Kathrynlls/Hydroponics-Monitoring-System-using-Atmega328p/README.md

# Hydroponics-Monitoring-System-using-Atmega328p
Hydroponics Monitoring System for Bok Choy, Lettuce, and Kale. This repository features a custom ATmega328P implementation, including complete schematics and source code for automated plant health tracking.
