Kathrynlls/Hydroponics-Monitoring-System-using-Atmega328p/Hydroponics-Monitoring-System-of-Lettuce-Kale-and-Bok-Choy-using-Atmega328p-microcontroller-1.pdf

## Hydroponics Monitoring System of Lettuce, Kale, and Bok Choy using Atmega328p microcontroller

by

## Kathryna T. Lelis Angelica Anne D. Santos Jhanna D. Vicente

### Bachelor of Science in Computer Engineering Mapúa University, 2025

A Design Proposal Submitted to the School of Electrical, Electronics, and Computer Engineering in Partial Fulfillment of the Requirements for the Degree

### Bachelor of Science in Computer Engineering

### Mapúa University October 2025

ACKNOWLEDGEMENT

The researchers would like to express their heartfelt gratitude to the panelists, Engr. Carlos C. Hortinela IV, Engr. Rosemarie V. Pellegrino, and Engr. Noel

### B. Linsangan, for their time, patience, and thoughtful suggestions which helped the researchers see the project from a deeper technical perspective and greatly improved

the overall quality of the work.

The researchers are sincerely thankful to their research instructor and adviser,

### Dr. Jocelyn F. Villaverde, for her constant guidance, encouragement, and understanding throughout the entire research process. Her dedication, valuable insights, and continuous support played a significant role in shaping both the

direction and completion of this study.

### The researchers also wish to thank the faculty members of the Computer

Engineering Department, along with their classmates and friends, for their support, assistance, and motivation during the development and testing of the system. Lastly, the researchers are deeply grateful to their families for their patience, encouragement, and unwavering support, which made the completion of this research possible.

Table of Contents

Functionality Constraints Overview of Alternative Solutions.......Error! Bookmark not defined.

Safety Constraints Overview of Alternative Solutions | Error! Bookmark not defined.

Constructability Constraints Overview of Alternative Solutions..Error! Bookmark not defined.

LIST OF FIGURES

FIGURE 3.34 ALTERNATIVE SOLUTION USING INDUSTRIAL GRADE SENSORS .........63

FIGURE 3.46 PROTOTYPE LAYOUT | 81
FIGURE 3.47 PROTOTYPE DISPLAY INSTANCE | 82
FIGURE 3.48 CODE SNIPPET | 82

LIST OF TABLES

TABLE 3.5 OLED DISPLAY AND 20X4 LCD DISPLAY COMPARISON TABLE | 49
TABLE 3.6 BATTERY POWER AND WALL PLUG POWER COMPARISON TABLE | 51

TABLE 3.7 INDUSTRIAL-GRADE SENSORS AND HOBBY-GRADE SENSORS COMPARISON -TABLE 53

TABLE 3.8 DESIGN ALTERNATIVES: FUNCTIONALITY OVERVIEW | 64
TABLE 3.9 DESIGN ALTERNATIVES: SAFETY OVERVIEW | 65
TABLE 3.10 DESIGN ALTERNATIVES: CONSTRUCTABILITY OVERVIEW | 65
TABLE 3.11 SELECTION OF ALTERNATIVE SOLUTIONS: MONITOR DISPLAY | 66
TABLE 3.12 SELECTION OF ALTERNATIVE SOLUTIONS: POWER SUPPLY | 67
TABLE 3.13 SELECTION OF ALTERNATIVE SOLUTIONS: SENSORS | 68
TABLE 3.14 COMPONENTS OF HYDROPONICS PCB | 77
TABLE 3.15 BILL OF MATERIALS | 80

ABSTRACT
Maintaining optimal growing conditions in hydroponic systems requires continuous monitoring of critical water parameters, yet commercial monitoring solutions remain prohibitively expensive for small-scale growers. This paper presents a low-cost, automated hydroponics monitoring system based on the ATmega328p microcontroller that tracks temperature, pH, and total dissolved solids (TDS) for three leafy vegetables: lettuce, kale, and bok choy. The system employs a DS18B20 temperature sensor, DFRobot Gravity analog pH sensor, and TDS sensor to provide real-time measurements displayed on a 20×4 LCD screen. Users select their target crop via push-button interface, automatically loading plant-specific threshold values for optimal growth conditions. A multi-level alert system using color-coded LEDs and an audible buzzer notifies users when parameters deviate from acceptable ranges, while the LCD provides actionable recommendations for corrective measures. Additionally, a programmable timer alerts users every 604,800 seconds (one week) for nutrient solution replenishment. Comprehensive functionality testing validated accurate vegetable selection, precise timer operation (±1 second variance), responsive LED indication, clear LCD display output, and reliable buzzer activation. The system demonstrated stable performance under continuous operation while maintaining a total hardware cost affordable, making it accessible to hobbyist farmers and small-scale urban agriculture applications. Compared to commercial alternatives costing $300 or more, this design achieves comparable monitoring capabilities at approximately one-third the cost, effectively lowering barriers to entry for sustainable hydroponic farming.

Keywords: Hydroponics, ATmega328p, pH monitoring, TDS sensor, embedded systems, agricultural automation, modern farming

CHAPTER 1

DESIGN AND BACKGROUND INTRODUCTION

Introduction

Hydroponics systems provide easy soil-free farming using nutrient-rich water solutions

carrying all of the minerals and nutrients directly into plant roots. However, maintaining a constant

nutrient solution under its preferred conditions requires constant monitoring. The Hydroponic

Monitoring System with ATmega328P provides automatic monitoring capabilities with proper

recommendations for temperature, pH, and TDS for water in the hydroponics system with lettuce,

kale, or Bok choy crops. Data is shown on an LCD I2C screen, and there are alerts on LED

indicators and the buzzer when the data deviates. The system further gives recommendations to

the user for maximum growth which is also shown in the LCD I2C screen. Combining monitoring,

recommendations, automated alerts, and a interface for the user, the Hydroponic Monitoring

System has made hydroponic farming a much easier thing for beginners. This approach would

ensure an efficient, productive, and sustainable growth process compared to the risk involved with

human monitoring.

Customer

Our Client, Marvin Baeza, is a passionate individual especially in hydroponic gardening

who enjoys cultivating a variety of plants using soilless methods. However, as a hobbyist, he fails

to achieve consistent optimum conditions needed for excellent plant growth. While he has

experience with certain types of plants such as lettuce, which is a commonly used plant for

hydroponic setup, he struggles to maintain consistent when growing novel types. Nutrient balance,

pH levels, and environmental conditions are always factors that require monitoring, and he finds this rather overwhelming. Despite his dedication to hydroponics, the complexity of maintaining

ideal growing conditions for different plants applicable in hydroponic system sometimes hinders

his ability to achieve the desired results.

Need

The main problem that our client has is to ensure consistency in the hydroponic gardening

system. He finds it complicated to sustain the plant quality most especially when changing different

plant types which would require a different care routine. He must track the nutrient levels, water

quality, and environmental conditions which will be very time-consuming and error-prone if done

manually. To mitigate this issue, he requires a system that will give him the comfort of a reliable

system that could help in the automation of monitoring with feedback, making his plants healthy

effortlessly.

Solution

a. Objectives

This study aims to create a hydroponic farming monitoring system using

ATmega328p microcontroller to track essential farming parameters.

Specifically it aims to: (1) measure and display data on different farming

factors using the integration of multiple sensor modules which are: water

temperature, pH, TDS, (2) develop an interface that allows users to select

from three pre-set plant-specific growing conditions which are: Lettuce,

Kale, Bok Choy, (3) integrate an LCD display for data visualization and an

alert system using visual indicators, , sound notifications to inform users

when any monitored parameter exceeds the optimal range for the selected plant type and a recommendation to set back to optimal conditions and a

recommendation to set back to optimal conditions.

b. Scopes and Delimitations

The paper focuses on Hydroponic Farming Monitoring System as a

smallscale, home-based solution designed to help growers maintain optimal

hydroponic conditions. It uses ATmega328p microcontroller to monitor pH

levels, total dissolved solids (TDS), and water temperature, ensuring proper

nutrient balance and water quality. The system features three pre-set plant

specifications which are Lettuce, Kale, Bok, Choy allowing users to select

the appropriate settings for different crops. Data and recommendation is

displayed on an LCD. However, the system is limited to hydroponic farming,

does not include automated nutrient dosing or water flow control, and

requires manual adjustments and periodic sensor calibration for accuracy.

Despite these limitations, the system enhances efficiency by reducing

manual monitoring efforts and improving plant health through continuous

parameter tracking.

Differentiation

Hydroponics farming has existed for centuries, but its popularity and the number of people

practicing it have only grown recently. This means that this is a starting and growing industry. The

monitoring systems available and currently in the market are pH meter TDS meter, EC meter,

temperature checker, and salinity checker. Some of these meters are sold separately in the market.

The closest product in the market to a Hydroponics Monitoring System is the 5in1 Portable

Hydroponics Meter. However, this product does not track nor monitor Hydroponics setups in

realtime and it also does not give alerts to the client, unlike the Hydroponics Monitoring System.

The Hydroponics Monitoring System was improved by being able to monitor the current

condition of the Hydroponics setup that the client has. This design is further enhanced by providing

clients with alerts from the LEDs, buzzer, and LCD attached to the system. The system can also

provide the appropriate recommendation which will be displayed in the LCD. Lastly, the client can

choose from three plants: Lettuce, Kale, and Bok Choy that they can plant in their hydroponics and

the Hydroponics Monitoring System would instantly change the parameters of the temperature,

pH, and TDS level based on the needs of each specific plant.

| Hydroponics Monitoring System | 5in1 Portable Hydroponics Meter
Specifications | • Run By ATmega328 microcontroller • Has built-in LCD, LEDs, and buzzer • Sensors: Temperature, pH, TDS • Battery: 5V | • Size: 183*37*37mm • pH meter, TDS meter, EC meter, temperature meter, salinity meter • Battery: 3*1.5V LR44

Functionality/

Features

•

•

•

•

•

•

Monitor system

Gives LED alerts when certain

parameters aren’t met Displays

data in LCD

Can monitor temperature, pH, and

TDS levels

Provides recommendations

Client can choose among 3

plants: Lettuce, Kale, and Bok

Choy and the system will

automatically change the

parameters based on the needs of each plant

•

•

•

•

•

•

Portable

5in1 meter: pH meter, TDS

meter, | EC | meter,

temperature meter, salinity

meter

Low power consumption

Does not give alerts

Does not give feedback
Does not provide real-time assessments

Table 1.1 Differentiation Table

Benefits

The proposed design for the Hydroponics Monitoring System would provide substantial

benefits to the hydroponics owners such that this design can help the client have an assessment of

the hydroponics setup. By providing alerts and feedback based on the condition of the hydroponics

setup, the hydroponics will have the appropriate and constant care that it needs to grow more

efficiently. This design provide all the necessary areas that are needed to be tracked by the client

in their setup. Lastly, because of the programmed parameters of different plants, the client would only need to choose which plant they will put in their hydroponics and the system will instantly

change the parameters needed based on the plant.

CHAPTER 2

REVIEW OF RELATED LITERATURE

This section of the paper provides a review of relevant literature and studies on hydroponic

monitoring systems. It deals with developments in hydroponic technology, such as automated

monitoring solutions, improving plant growth and maintenance. This discussion involves critical

concepts and available applications of hydroponic monitoring technologies that advance

innovations to enhance plant health. The document therefore looks into critical parameters to

consider for monitoring plants in a hydroponic setup and the effects of monitoring on the overall

quality of plants. It then discusses how microcontrollers, specifically the ATmega328P, can be

employed to implement an effective monitoring system. The present review work is basically a

precursor to the Hydroponic Monitoring System project design and development.

Concepts and Existing Applications of Hydroponics Monitoring Technologies

Hydroponics, a method of growing plants without soil, relies on nutrient-rich water

solutions and various substrates like clay pellets, perlite, or rockwool. The agricultural technique

successfully draws manufacturing interest because it improves water efficiency as well as increases

crop production and prevents soil-disease transmission. The integration of technology now allows

hydroponic systems to utilize advanced monitoring equipment which maintains perfect growing

environments. Moreover, the Internet of Things (IoT) components along with sensors and

automated control systems allow real-time adjustments of essential parameters including nutrient

levels, pH balance and temperature together with humidity in hydroponic systems. According to

Lakshmi, et. al (2020), the implementation of IoT can deliver live data and warning alerts to

farmers who achieve enhanced environmental control capabilities through automated systems without manual labor requirements [1]. In its procedure, the system is able connect with mobile

applications, so farmers obtain remote capabilities to oversee their hydroponic system operations,

according to Sobri, et. al (2022). This type of utilization with regards to hydroponics with

technology creates maximum performance alongside fresh opportunities for both urban farming

and sustainable agricultural methods [2].

This advance type of monitoring technology should be implemented in hydroponics since

they significantly improve both the precision and efficiency of plant cultivation. The combination

of automatic environmental parameter adjustment under these systems enhances plant

development which leads to better crop production and improved harvest results. The ability to

remotely handle hydroponic systems and their monitoring functions reduces workplace expenses

and minimizes errors. The combination of hydroponics technology with IoT monitoring provides

regions that lack arable land and water resources with a sustainable method to overcome their food

production problems [3]. Further supporting the development of urban farms during rising

urbanization because they improve food security and decrease the environmental impact of

conventional agriculture.

Factors to Consider in Monitoring Plants in Hydroponics Setup

Hydroponics is a method of growing plants without soil, relying instead on nutrient-rich

water solutions. The efficiency of a hydroponic system depends on the careful monitoring and

control of various environmental factors. Among these, temperature, pH, and total dissolved solids

(TDS) play crucial roles in plant growth, nutrient absorption, and overall yield.

According to Agbayani and Villaverde (2022), many farmers struggle to maintain a healthy

hydroponic system due to the difficulty of monitoring water quality parameters like temperature in real-time. Optimal temperature for hydroponic plant growth varies depending on the plant

species [4]. According to Thakulla et al. (2021), extreme heat damages the root of lettuce thus the

water temperature must be kept stable at 21.1 °C to produced lettuce with greater growth [5].

Likewise, a study on environmental factors on Kale suggests that the optimal temperature is at 20–

23 °C for better growth [6]. Moreover, according to the ideal temperature range for bok choy in

hydroponics is between 18°C and 20°C. Temperature control mechanisms such as water chillers,

heaters, and insulated reservoirs are commonly used to maintain stability [7].

The pH level of the nutrient solution directly affects nutrient solubility and availability to

plants. The pH level can change above or below the recommended pH level, which causes nutrient

deficiencies in plants. The recommended pH level for pechay is 5.5 to 6.5 [8]. Studies indicate that

a nutrient solution pH of 5-6, resulting in a root zone pH of 6-6.5, optimizes nutrient availability

for leafy greens like lettuce and kale in hydroponic systems. When pH levels fall outside this range,

certain nutrients become less available, leading to deficiencies or toxicities [9].

Total Dissolved Solids (TDS) and Water Quality Total dissolved solids (TDS) represent

the combined content of all inorganic and organic substances dissolved in water. TDS levels in

hydroponic systems typically range between 500 and 2,000 ppm, depending on crop requirements.

Generally, according to IGWorks (2025), the recommended TDS range for lettuce is between 560

and 840 ppm, for bok choy is 1050 to 1400 ppm, and kale is 1120-1750 ppm. High TDS levels can

indicate excessive nutrients or contaminants, requiring dilution or water replacement. Maintaining

appropriate TDS levels ensures optimal nutrient balance and prevents water quality degradation.

Effective hydroponic farming requires precise monitoring of temperature, pH, and TDS to

optimize plant growth and productivity. Existing research underscores the importance of maintaining these parameters within recommended ranges to ensure nutrient availability and

minimize plant stress.

The Impact of Monitoring on Plant Quality in the Hydroponics Setup

Taking care of hydroponics can be a tedious job. This is why multiple inventions have been

intended to monitor a hydroponics setup. Hydroponics requires constant and consistent care in

order for the plants to grow better and more efficiently. In a study done by Blancaflor et. al., 2022,

the researchers have utilized Internet of Things (IoT) to monitor and store the data of the condition

of the plants in the hydroponics [10]. Using this, the client will be able to use the mobile application

intended for the hydroponics to cater the needs of the plants. The use of this system will help the

client monitor the condition of the plants with accurate data. Another study by Ayob et. al., 2022,

whereas the researchers also used an IoT device to monitor the condition of the water temperature

in the hydroponics setup. Since hydroponics utilizes water to plant the crop, it should be kept at

certain temperature levels for the plants to survive [11]. The main goal of their project is to track,

monitor, and control the temperature of the water and keep it between the range of 19 to 27 degrees

Celsius.

Application of ATmega328p in a Monitoring System

The ATmega328P microcontroller has proven to be a versatile solution for various

monitoring system applications. One study by M. Caruso et al. emphasizes the use of the

ATmega328P-PU in a low-cost, open-source monitoring system for PV plants. The research

addresses the issue of power loss in PV systems by proposing a system that measures key electrical

quantities affecting energy production. The adoption of such a system can be costly, but the study

demonstrates the feasibility of a simple and affordable solution using the ATmega328P-PU [12].

Another research has utilized an ATMega328P microprocessor to monitor Petroleum Gas (LPG)

air concentration [13]. Moreover, like the previous study, this study mainly focused on developing

the system to be in real-time and to be low cost. A separate group of researchers developed a

wireless fire detection system using the ATmega328P as its core [14]. The system here is attached

to utility posts in which it exemplifies the microcontroller's suitability for remote monitoring and

critical event detection. Since the ATmega328P has a low power consumption it is likely a crucial

factor in such a deployment since it could enable long-term operation without frequent

maintenance. Overall, these studies back-up how the ATmega328p with benefits of small size, low

power consumption, stable operation, and convenient program maintenance which are desirable

features in a monitoring system. These characteristics make the ATmega328P a strong candidate

for various embedded applications, including the development of a hydroponic monitoring system.

Embedded Multi-Sensor Applications using ATmega328p microcontroller

The monitoring system that the researchers will set up requires multiple sensors varying

from pH sensors, temperature sensors, and total dissolved solids (TDS) sensors. In this project, the

researchers will be using the ATmega328p microcontroller to handle the different sensors involved

in the setup. Multiple attempts have been made for ATmega328p as a multi-sensor. Meaning, this

microcontroller can handle multiple sensors at once. In one study, multiple sensors have been

attached to Arduino with ATmega328p as its microcontroller. This is to use the embedded system

as an intrusion detection [15]. Another application of ATmega328p was for the assistive walker

device equipped with multi-sensors [16]. The researchers used two different microcontrollers for

controlling the system and monitoring the system. They have also attached multiple sensors such

as a force sensor, speed sensor, and ultrasonic sensor.

CHAPTER 3

METHODOLOGY

A. Design Process Flow

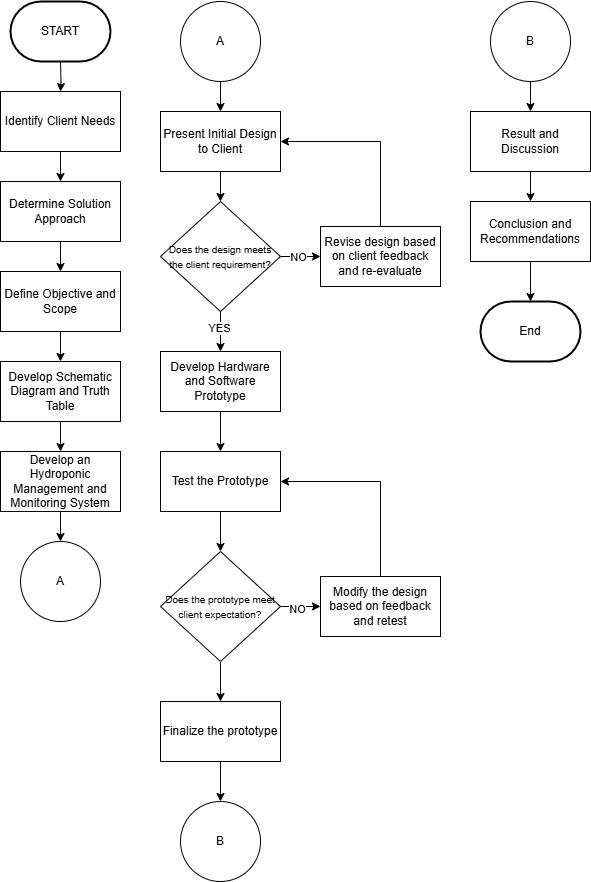
[picture p1: figure]

Figure 3.1 Design Process Flow

The design process, as shown in Figure 3.1, starts with analyzing the client's challenges in

keeping optimal hydroponic conditions. After defining objectives, scope, and limitations, a

schematic design is developed and presented for review by the client. If it needs to be revised, the

necessary adjustments are made before going into prototype development. The system, with the

integration of ATmega328P and sensors that monitor pH, TDS, and temperature, is tested and

refined according to the feedback received from the clients. This would then be a prototype,

finetuned in order to match expectations, while results, discussions, and recommendations are

documented toward improving hydroponic automation and efficiency.

B. Conceptual Framework

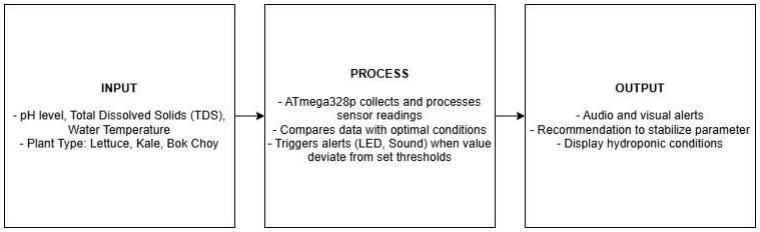
[picture p2: figure]

Figure 3.2 Conceptual Framework

Figure 3.2 shows the conceptual framework of the Hydroponic Monitoring System which

follows an Input-Process-Output model for efficient monitoring of plant growth conditions. The

Input stage consists of data collection through multiple sensors that measure pH level, Total

Dissolved Solids (TDS), and water temperature. Additionally, the user selects a specific plant

type—Lettuce, Kale, or Bok Choy—which determines the predefined optimal conditions for that

crop. In the Process stage, the ATmega328P microcontroller receives the sensor readings and

compares them with the predefined thresholds for the selected plant. If any parameter deviates

from the ideal range, the system triggers alerts through LED indicators and sound notifications, for immediate user awareness. Furthermore, all data is displayed on an LCD screen for monitoring.

Finally, in the Output stage, the system provides visual and auditory alerts when conditions are

suboptimal, displays current hydroponic parameters, and provides recommendations on corrective

actions based on sensor readings.

C. Block Diagram

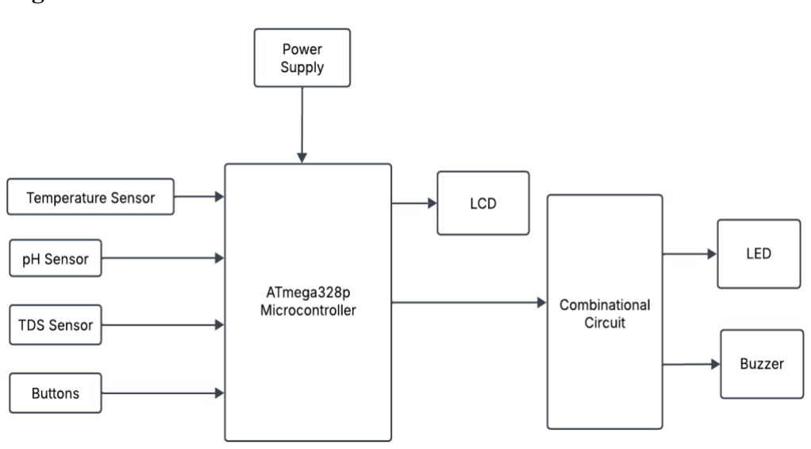
[picture p3: figure]

Figure 3.3 Block Diagram

The ATmega328p will be used as the microcontroller for the proposed monitoring system

for hydroponics. This microcontroller will be responsible for transferring the data gathered to the

program. Alongside it are the three sensors or inputs, namely the DS18B20 temperature sensor,

DFRobot Gravity Analog pH Sensor Kit V2, and the DFRobot Gravity Analog TDS Sensor. The

temperature sensor will be used to monitor the temperature of the water in the hydroponics setup.

The pH sensor will be responsible for gathering the pH data of the water. Lastly, the TDS sensor

will monitor the total dissolved solids of the water. There would also be buttons which can help

the user to choose which plants they want in the hydroponics. The outputs consist of the buzzer,

LEDs, and the LCD. The speaker will be responsible for getting the attention of the client by

making a sound if one of the parameters is not met. The LEDs will light up if one of the parameters is not met. The LCD is where the user can view the data of the water of the hydroponic system.

Lastly, the power supply will be responsible for the microcontroller, inputs, and outputs to work

by giving them enough power to run.

D. Data Gathering Setup

The data gathering setup for our hydroponic monitoring system ensures accurate and

consistent measurement of key parameters, including pH, temperature, and total dissolved solids

(TDS). To achieve reliable readings, the sensors are placed within the 15.5" x 15.5" x 6.25"

styrofoam grow box, ensuring they are submerged in the water reservoir. The pH sensor is

positioned near one corner of the box, avoiding surface disturbances while still capturing acidity

levels. The water temperature sensor is placed centrally within the reservoir, slightly deeper, to

monitor temperature variations evenly. Meanwhile, the TDS sensor is located on the opposite side

of the pH sensor, also submerged, to prevent localized inconsistencies.

To maintain accuracy, the sensors are securely placed to prevent movement that could lead

to fluctuating readings. The microcontroller collects raw data from the sensors. This data is then

compared to predefined thresholds corresponding to optimal plant growth conditions. If any

readings fall outside the acceptable range, the system trigger alerts or recommend corrective

actions, such as adjusting the nutrient solution or temperature. An LCD display, mounted in front

of the grow box, provides realtime monitoring data. Additionally, the system is placed outside to

account for environmental factors such as grow light interference and ambient temperature

fluctuations, ensuring the sensors perform reliably under varying conditions.

E. Hardware Development

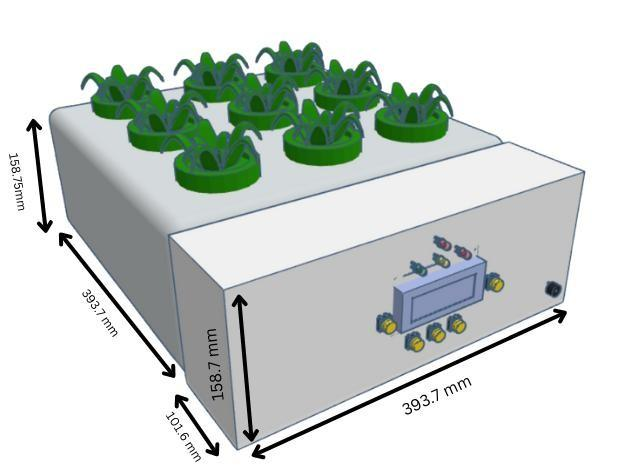
[picture p4: figure]

Figure 3.4 Hardware Development

Figure 3.4 shows the actual illustration of the monitoring setup of the hydroponics system.

The whole system will be equipped with a 393.7 × 393.7 × 158.75 mm styrofoam box with 9 holes

on top, which will serve as the hydroponics grow box. Attached to it is a circuit compartment with

a dimension of 393.7 × 101.6 × 158.75 mm this is where the circuit will be stored. In front of the

whole setup is a 146.0 × 62.5 × 13.6 mm LCD which will display the value of the temperature, pH,

and TDS of the water in the hydroponics setup. There is also one buzzer for notifying the client of

alerts and four buttons which will help the client control the system by choosing a plant (lettuce,

kale, or bok choy) or resetting the system.

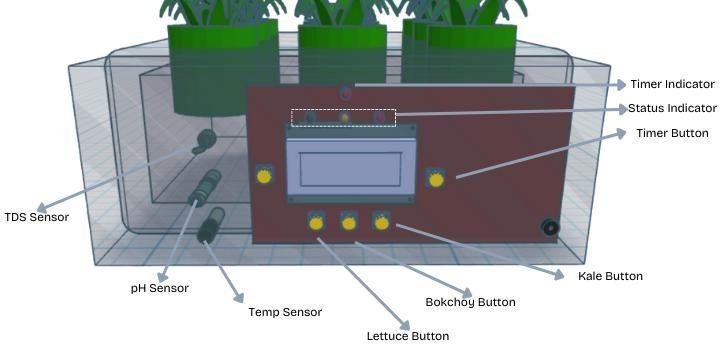
[picture p5: figure]

Figure 3.5 Transparent View of Circuit Compartment

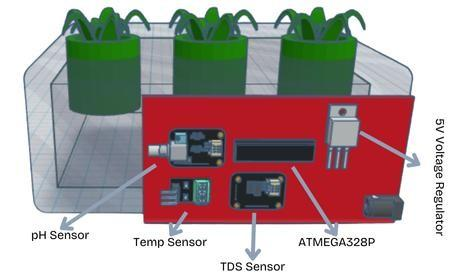
[picture p6: figure]

Figure 3.6 Circuits inside the Compartment

Figure 3.5 shows the transparent circuit compartment. Which will store all of the circuits

and components needed for the monitoring system to work. This compartment box has a dimension

of 393.7 × 101.6 × 158.75 mm. In front of the compartment box is a 77.0 × 47.0 × 12.4 mm LCD

which displays the data and the recommendation based on the water’s parameters. There would

also be four buttons in total which enable the user to control the plant to be put in the hydroponics

system and another button to reset the system. Lastly, the buzzer gives the user an audible alert for

the system.

Figure 3.6 shows the inside of the compartment circuit to be used for the monitoring setup.

Inside, there will be one voltage regulator, temperature sensor, pH sensor, and TDS sensor. The

voltage regulator will help the voltage provided by the power supply to be at an acceptable range.

The temperature sensor will be responsible for gathering data on the temperature of the water for

the system to read and analyze. The pH sensor would be responsible for the data gathering of the

pH of the water and the TDS sensor will get the total dissolved solids in the water.

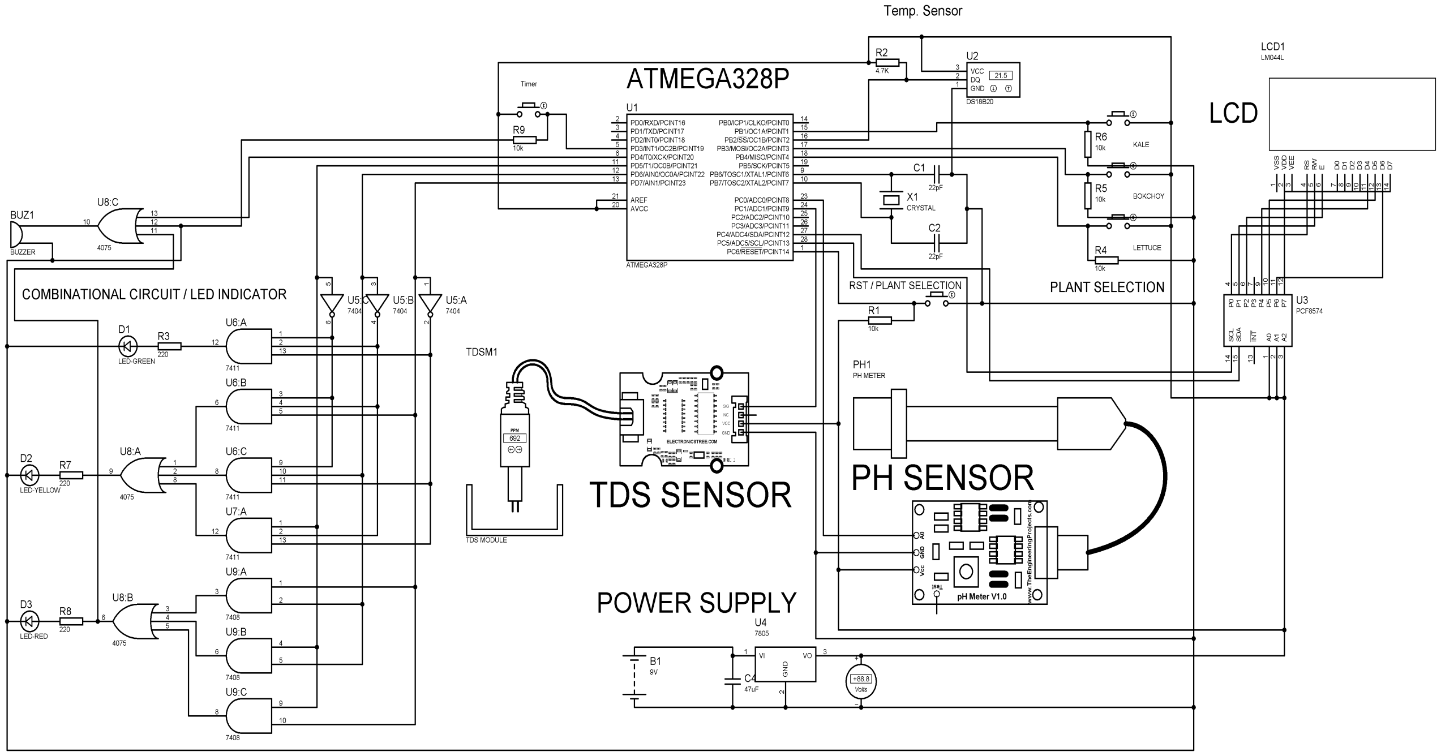
[picture p7: figure]

Figure 3.7 Schematic Diagram

Initial Schematic Diagram

Figure 3.7 shows the schematic diagram of the hydroponic monitoring system, which is

powered by a 220V AC input, which is regulated to 5V DC using a voltage regulator. This ensures a stable power supply for the ATmega328P microcontroller and all connected components,

allowing them to function reliably within safe voltage levels. Additionally, there would be an extra

battery for when an emergency power supply is needed. The plant selection module, containing

three buttons, enables users to choose between different plant types, such as lettuce, bok choy, and

kale. The ATmega328P microcontroller, which has digital outputs and analog inputs, processes

this selection and adjusts the monitoring parameters accordingly to suit the chosen plant. It serves

as the central processing unit, collecting sensor data and controlling system outputs.

The system includes three key sensors: a temperature sensor, a pH sensor, and a Total

Dissolved Solids (TDS) sensor. These sensors continuously measure essential parameters for

hydroponic farming and send the data to the microcontroller. If the measured values deviate from

the optimal range for the selected plant, the system activates the appropriate indicators and alerts.

To display sensor readings, the system uses an LCD display with a PCF8574 I2C module. The I2C

interface simplifies wiring by reducing the number of connections required between the

microcontroller and the display.

An LED indicator and buzzer alert system is implemented using a combinational circuit to

notify the user of the system’s status. The LED indicators provide a visual representation of the

system’s condition. A green LED lights up when all sensor parameters are within the ideal range,

indicating that the hydroponic conditions are optimal. If at least one sensor parameter is outside

the acceptable range, the yellow LED activates to alert the user to a potential issue. When two or

more sensor parameters fall outside the desired range, the red LED and buzzer are triggered

simultaneously, providing both a visual and audible warning to prompt immediate attention.

Additionally, the system also contains an extra two buttons. One is to reset the entire system.

With this, the system will restart, and the client can start the process again by choosing another plant to be planted in the hydroponics system. Another button that was added is for the timer. By

pressing this button, the client will have a timer from when he started to put a nutrient solution up

until the time he needs to replenish it.

Truth Table

For the truth table, the study requires three input, one for each output. In this case, the inputs are

A, B, and C consistently for the three truth tables. A is for the temperature, B is for the pH, and

lastly, C is for the TDS sensor. For the input, 0 indicates that the condition is at a normal state

(stable) or is within the range of the required parameter. On the other hand, 1 indicates that the

parameter for that specific condition has either exceeded the maximum requirement or fell short

of the minimum requirement (unstable). The D input indicates the timer (in some truth table) will

be 0 if timer has not reached zero yet and 1 if the timer reached zero.

A | B | C | D | Z
0 | 0 | 0 | 0 | 0
0 | 0 | 0 | 1 | 1
0 | 0 | 1 | 0 | 0
0 | 0 | 1 | 1 | 1
0 | 1 | 0 | 0 | 0
0 | 1 | 0 | 1 | 1
0 | 1 | 1 | 0 | 1
0 | 1 | 1 | 1 | 1
1 | 0 | 0 | 0 | 0
1 | 0 | 0 | 1 | 1
1 | 0 | 1 | 0 | 1
1 | 0 | 1 | 1 | 1
1 | 1 | 0 | 0 | 1
1 | 1 | 0 | 1 | 1
1 | 1 | 1 | 0 | 1
1 | 1 | 1 | 1 | 1
Table 3.1 Truth Table for Buzzer Output

For this truth table, the buzzer output is taken into account. The inputs are A, B, and C for

each sensor while the output is Z for the Buzzer. The condition is when Z is 0, the buzzer is off

and if Z is 1 the Buzzer will be on. In this case, the buzzer will only be on if two or more of the

sensors are in an unstable state. Also, Z will be 1 if input D (timer) is also 1.

A | B | C | D | G | Y | R | T
0 | 0 | 0 | 0 | 1 | 0 | 0 | 0
0 | 0 | 0 | 1 | 1 | 0 | 0 | 1
0 | 0 | 1 | 0 | 0 | 1 | 0 | 0
0 | 0 | 1 | 1 | 0 | 1 | 0 | 1
0 | 1 | 0 | 0 | 0 | 1 | 0 | 0
0 | 1 | 0 | 1 | 0 | 1 | 0 | 1
0 | 1 | 1 | 0 | 0 | 0 | 1 | 0
0 | 1 | 1 | 1 | 0 | 0 | 1 | 1
1 | 0 | 0 | 0 | 0 | 1 | 0 | 0
1 | 0 | 0 | 1 | 0 | 1 | 0 | 1
1 | 0 | 1 | 0 | 0 | 0 | 1 | 0
1 | 0 | 1 | 1 | 0 | 0 | 1 | 1
1 | 1 | 0 | 0 | 0 | 0 | 1 | 0
1 | 1 | 0 | 1 | 0 | 0 | 1 | 1
1 | 1 | 1 | 0 | 0 | 0 | 1 | 0
1 | 1 | 1 | 1 | 0 | 0 | 1 | 1
Table 3.2 Truth Table for LED Output

For this truth table, the three LEDs are taken into account (red, green, and yellow). The

inputs are still A, B, and C for each sensor. The outputs are G (green), Y (yellow), and R (red) for

each LED output. In this truth table, the green LED will be on if all of the sensors are at a stable

state meaning G will only be 1 if all of the inputs (A, B, and C) are 0. The yellow LED will be on

if one sensor is in an unstable state. This means that Y will only be 1 if one of the sensor inputs is

1. Lastly, the red LED will be on if two or more of the sensors are in an unstable state. This means

that R will only be 1 if at least two of the inputs are 1. There is also an added input D, which indicates the timer, and an output T. In this case D is 0 if the timer has not reached 0 yet and D will

be 1 if timer has reached 0 seconds. The output T is the LED indicator for the timer which will be

off (0) if the timer has not yet reached 0 seconds and on (1) if the timer has reached 0 seconds.

A | B | C | U | V | W
0 | 0 | 0 | 0 | 0 | 0
0 | 0 | 1 | 0 | 0 | 1
0 | 1 | 0 | 0 | 1 | 0
0 | 1 | 1 | 0 | 1 | 1
1 | 0 | 0 | 1 | 0 | 0
1 | 0 | 1 | 1 | 0 | 1
1 | 1 | 0 | 1 | 1 | 0
1 | 1 | 1 | 1 | 1 | 1
Table 3.3 Truth Table for LCD Output

For this truth table, the three recommendations are taken into account (for temperature, pH,

and TDS). The inputs are still A, B, and C for each sensor. The outputs are U (recommendation

for temperature), V (recommendation for pH), and W (recommendation for TDS) for each

recommendation. The U, V, and W output will be 0 indicating that there is no warning signal while

1 indicates that there is a warning signal. Explaining the truth table, each output will be the value

of their corresponding inputs. U will be 0 if A is 0 and U will be 1 if A is 1. V will be 0 if B is 0

and V will be 1 if B is 1. And W will be 0 if C is 0 and W will be 1 if C is 1.

Karnaugh Map

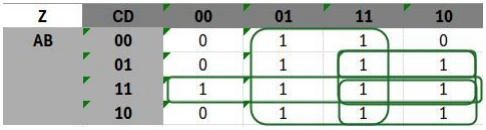
[picture p8: figure]

Figure 3.8 KMAP for Z (Buzzer) Output

Equation: Z= D + AB + BC + AC

Figure 3.6 shows the Karnaugh Map of the Z Output for the Buzzer. The resulting equation

would be the simplified version to display in the schematic diagram. This entails that this equation

is the necessary combinational circuit to meet the expectation of the design. In essence, Z will be

1 if at least two of the sensor inputs are also 1 or D is also 1.

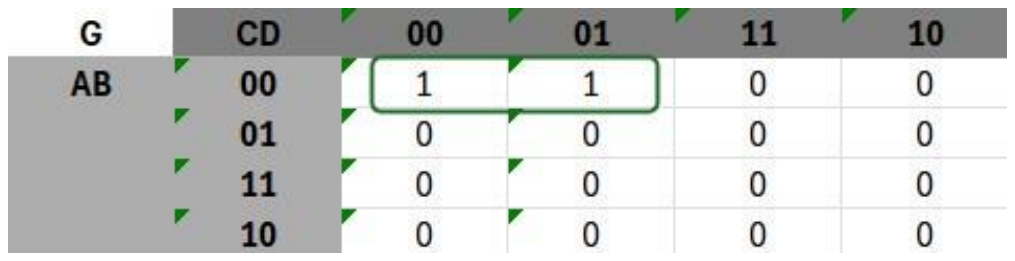
[picture p9: figure]

Figure 3.9 KMAP for G (LED) Output Equation: G= A'B'C'

Figure 3.7 shows the Karnaugh Map of the G Output for the LED component. The resulting

equation would be the simplified version to display in the schematic diagram. This entails that this

equation is the necessary combinational circuit to meet the expectation of the design. In essence,

G will be 1 if all the inputs are 0.

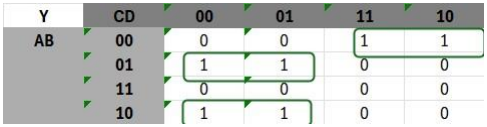
[picture p10: figure]

Figure 3.10 KMAP for Y (LED) Output Equation: Y= AB'C' + A'BC' + A'B'C

Figure 3.8 shows the Karnaugh Map of the Y Output for the LED component. The resulting

equation would be the simplified version to display in the schematic diagram. This entails that this equation is the necessary combinational circuit to meet the expectation of the design. In essence,

Y will be 1 if one of the inputs is 0.

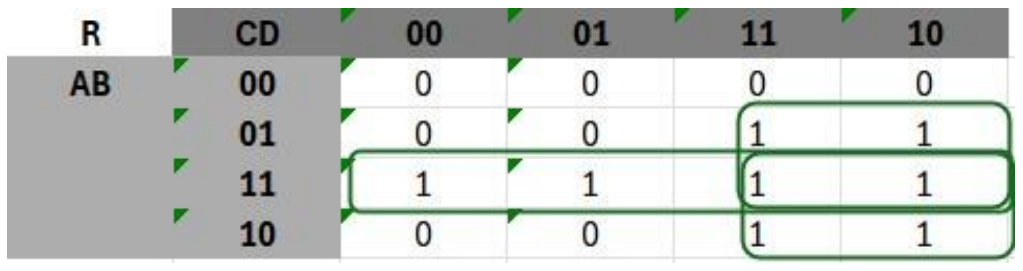
[picture p11: figure]

Figure 3.11 KMAP for R (LED) Output Equation: R= AB + BC + AC

Figure 3.9 shows the Karnaugh Map of the R Output for the LED component. The resulting

equation would be the simplified version to display in the schematic diagram. This entails that this

equation is the necessary combinational circuit to meet the expectation of the design. In essence,

R will be 1 if at least two of the inputs are 1.

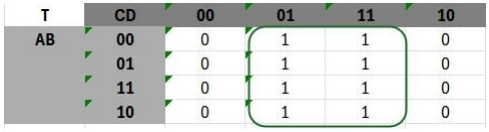
[picture p12: figure]

Figure3. 12 KMAP for T (LED) Output Equation: T= D

Figure 3.9 shows the Karnaugh Map of the R Output for the LED component. The

resulting equation would be the simplified version to display in the schematic diagram. This

entails that this equation is the necessary combinational circuit to meet the expectation of the

design. In essence, R will be whatever the status of D will be.

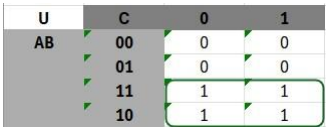
[picture p13: figure]

Figure 3.13 KMAP for U (LCD) Output Equation: U= A

Figure 3.11 shows the Karnaugh Map of the U Output for the LCD component. The

resulting equation would be the simplified version to display in the schematic diagram. This entails

that this equation is the necessary combinational circuit to meet the expectation of the design. In

essence, U will be 1 if A is also 1.

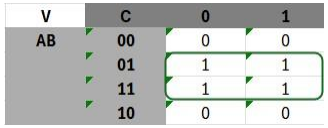
[picture p14: figure]

Figure 3.14 KMAP for V (LCD) Output Equation: V= B

Figure 3.12 shows the Karnaugh Map of the V Output for the LCD component. The

resulting equation would be the simplified version to display in the schematic diagram. This entails

that this equation is the necessary combinational circuit to meet the expectation of the design. In

essence, V will be 1 if B is also 1.

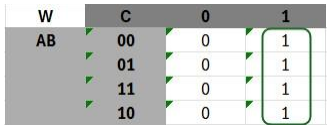
[picture p15: figure]

Figure 3.15 KMAP for W (LCD) Output Equation: W= C

Figure 3.13 shows the Karnaugh Map of the W Output for the LCD component. The

resulting equation would be the simplified version to display in the schematic diagram. This entails

that this equation is the necessary combinational circuit to meet the expectation of the design. In

essence, W will be 1 C is also 1.

F. Software Development

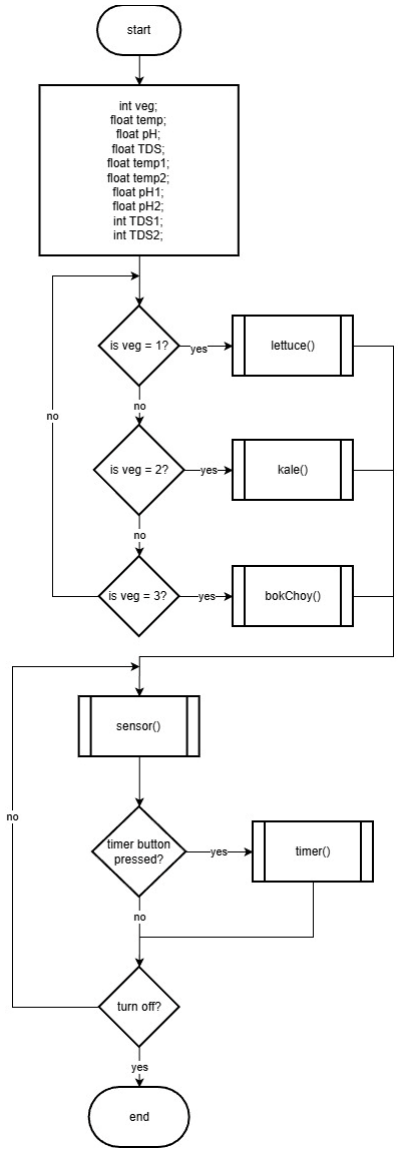
[picture p16: figure]

Figure 3.16 Main Flowchart

The flowchart illustrates a control logic sequence designed for a hydroponic system,

beginning with the initialization of several key variables. The system declares an integer for the

vegetable type (veg) alongside multiple floating-point variables used to track environmental

metrics such as temperature (temp), acidity levels (pH), and nutrient density (TDS). These

variables include specific setpoints or thresholds, indicated by the numbered suffixes like temp1

and temp2, which define the optimal growing range for the selected plant.

Once the variables are established, the program enters a selection phase where it identifies

which plant profile to activate. Through a series of conditional checks, the system determines if

the user has selected lettuce, kale, or bok choy. If one of these is chosen, the program executes a

corresponding predefined function—lettuce(), kale(), or bokChoy()—which loads the specific

optimal factors for that crop. If no valid selection is made, the logic loops back to ensure a vegetable

type is assigned before proceeding to the active monitoring phase.

After the plant profile is set, the system enters a continuous monitoring centered around a

sensor() function. This function serves as the primary data collection point, reading real-time

conditions from the hardware. Within this loop, the system also checks for manual overrides or

specific events, such as whether a "timer button" has been pressed to trigger a countdown

designated for the total dissolved solids. The process remains in this active state, constantly

refreshing sensor data and checking for user input, until a "turn off" command is received, at which

point the program exits the loop and reaches the end of its operation.

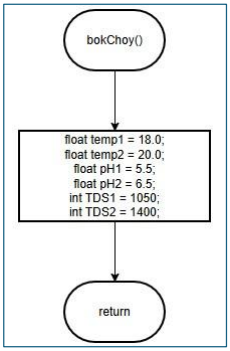
[picture p17: figure]
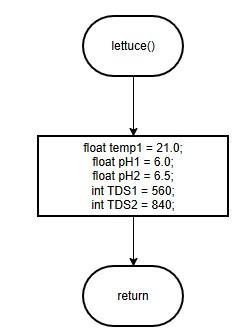
[picture p18: figure]
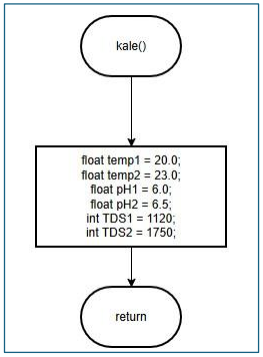
[picture p19: figure]

The diagram presents a "Veg Module" that outlines functions for three different vegetables:

lettuce, kale, and bok choy. Each vegetable has its own distinct function defined within the module.

The function for lettuce, labeled as "lettuce()", initializes several parameters such as temperature

(temp1 = 21.0), pH levels (pH1 = 6.0, pH2 = 6.5), and TDS levels (TDS1 = 560, TDS2 = 840).

Following the initialization of these parameters, the function concludes with a return statement.

Next, the "kale()" function defines its own parameters, with temperature set at two values

(temp1 = 20.0 and temp2 = 23.0), pH levels (pH1 = 6.0 and pH2 = 6.5), and TDS levels (TDS1 =

1120 and TDS2 = 1750). Similar to the lettuce function, it also ends with a return statement.

Lastly, the "bokChoy()" function features parameters that include temperature (temp1 =

18.0 and temp2 = 20.0), pH levels (pH1 = 5.5 and pH2 = 6.5), and TDS values (TDS1 = 1050 and

TDS2 = 1400). It follows the same structure, concluding with a return statement. Overall, this

module systematically organizes the relevant parameters for these three types of vegetables.

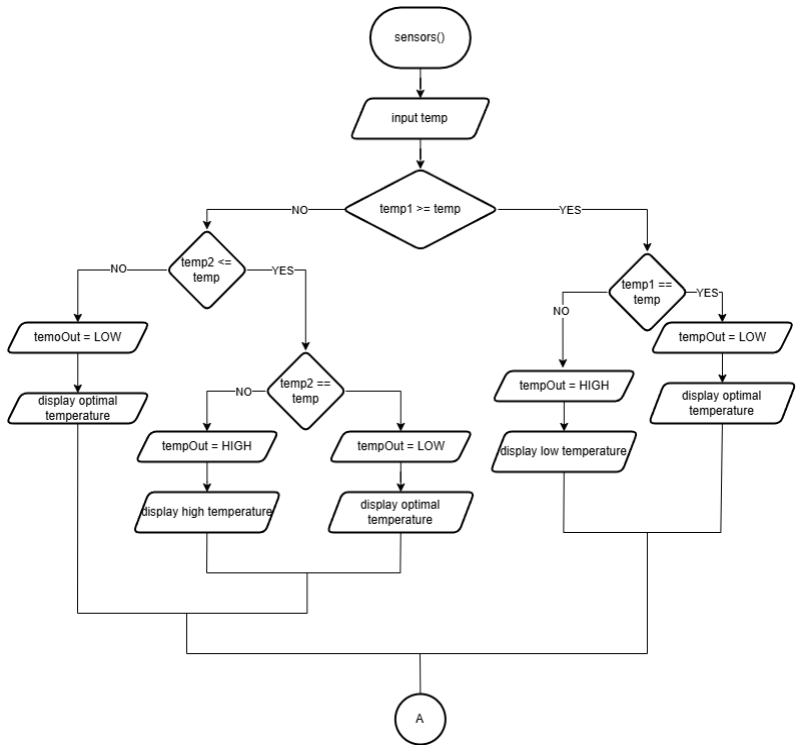
[picture p20: figure]

Figure 3.18 Sensor Flowchart (Temperature)

Figure 3.16 illustrates the temperature monitoring process for the sensor module, utilizing

a series of conditional checks to determine the appropriate temperature output based on how the

input compares to parameters temp1 and temp2. The process begins with the sensors() function,

which waits for an input temperature value.

The system first checks if temp1 is greater than or equal to the input temperature. If this

condition holds, it proceeds to verify whether temp2 is less than or equal to the input. If both

conditions are met, tempOut is set to LOW, indicating an optimal temperature display. However,

if temp2 is greater than the input, the system checks whether temp2 equals the input. If so, tempOut

is set to HIGH, signaling a high temperature.

If temp1 is less than the input temperature, the system then checks if temp1 equals the input.

When this condition is true, tempOut is set to LOW, maintaining an optimal display. If not, the

system evaluates temp2. If temp2 equals the input temperature, tempOut is assigned a value of

HIGH to indicate a low temperature before displaying the corresponding message. Otherwise, the

system defaults to an optimal temperature display. This approach ensures that temperature outputs

are determined directly based on how the input value compares to temp1 and temp2.

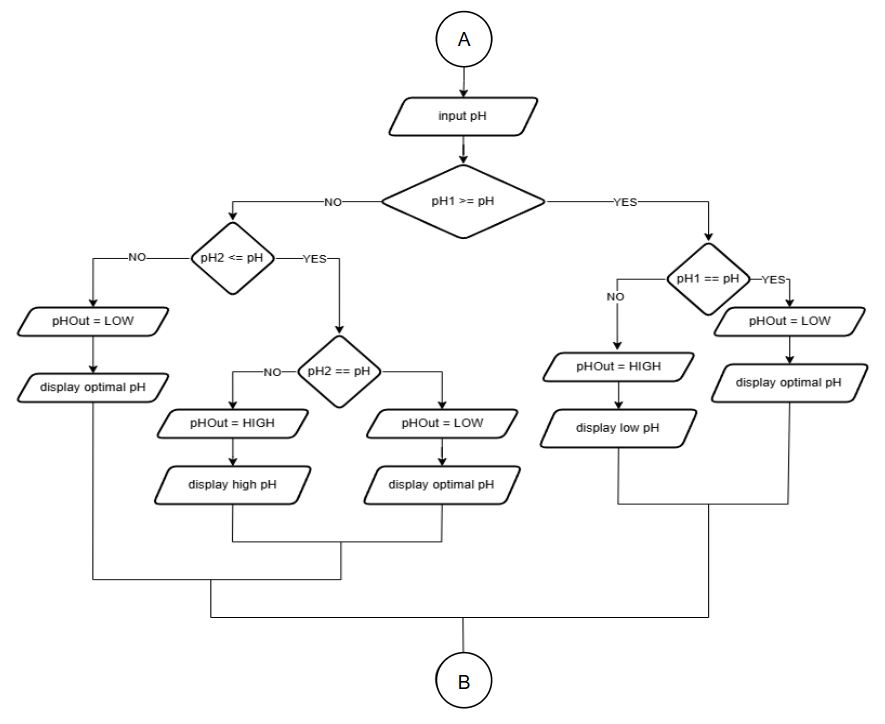
[picture p21: figure]

Figure 3.19 Sensor Flowchart (pH)

Figure 3.17 outlines the process for monitoring pH levels using a sensor system. Initially,

the process begins with the capturing the pH input. The captured pH value is then compared against

specified thresholds established by variables pH1 and pH2. The first decision point checks if the

input pH is greater than or equal to pH1. If this condition is met, the process moves to the next decision box, which verifies whether the input pH is less than or equal to pH2. If the input pH falls

within this optimal range, it is deemed acceptable, and the system will display optimal pH while

setting the output variable pHOut to LOW.

However, if the pH is greater than pH1 but is not less than or equal to pH2, the system

checks if the pH is equal to pH2. Here, if true, the output variable pHOut is set to HIGH and

displays high pH. Conversely, if the input doesn’t match any optimal criteria, the system continues

to check further conditions. If, at any point, the input pH matches pH1, the system will also set

pHOut to LOW and display optimal pH. Similarly, the process also addresses scenarios when the

pH is lower than the established parameters. It ensures that readings lead to informative displays

regarding the pH conditions, guiding users on whether the levels are optimal, high, or low.

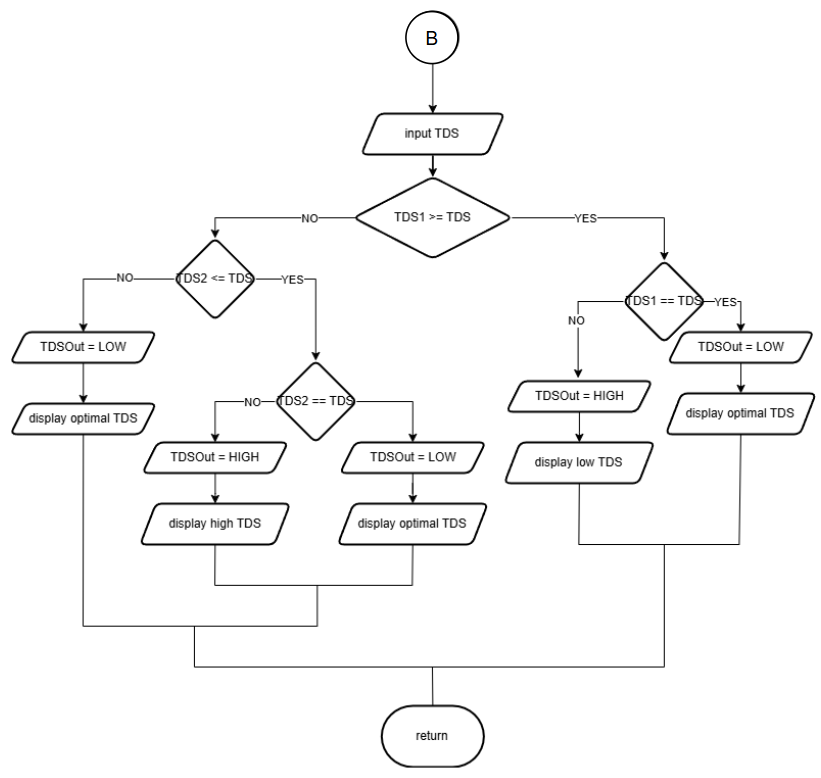
[picture p22: figure]

Figure 3.20 Sensor Flowchart (TDS)

Figure 3.18 outlines the process for monitoring Total Dissolved Solids (TDS) levels

through sensor input. The first step in the flowchart is inputting the current TDS level.

Subsequently, the system compares this input with two predefined thresholds, TDS1 and TDS2. If

the input TDS is greater than or equal to TDS1, the program checks if it is less than or equal to

TDS2. If this condition is met, the output, denoted as TDSOut, is set to LOW, indicating that the

TDS level is optimal, and a corresponding message is displayed.

If the input TDS exceeds TDS2, TDSOut is set to HIGH, which signifies a high TDS

condition, and the system displays a relevant alert. In cases where the input TDS is less than TDS1,

the program checks if it equals TDS2. If so, TDSOut is again set to LOW and displays an optimal

message. However, if the TDS is not equal to TDS2 in this scenario, TDSOut is set to HIGH,

indicating a low TDS condition, prompting the system to display an appropriate message. The

flowchart categorizes the TDS levels into optimal, high, and low, enabling monitoring and alerts

based on the current water quality conditions before finally returning to the initial state.

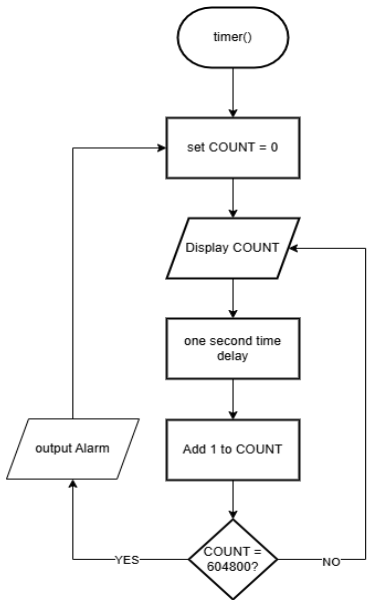
[picture p23: figure]

Figure 3.21 Timer Flowchart Module

The flowchart illustrates the operation of an independent countdown timer designed to alert

the user every 1 week or after 604800 seconds for nutrient addition. The process begins by

initializing the timer with a count value of zero. The current count is then displayed, followed by

a one-second time delay. After each delay, the count is incremented by one. This cycle continues

until the count reaches 604,800 seconds (equivalent to 1 week or 168 hours). Once this threshold

is met, an alarm is triggered to notify the user. Following the alarm, the timer resets to zero, and

the process repeats indefinitely.

G. Multiple Design Constraints
| Power Supply | Monitor Display | Sensor Type | Total
Weights | 0.3 | 0.3 | 0.4 | 1.0
Constraints | Score | Weight | Score | Weight | Score | Weight | Total
Aesthetics | 3 | 0.9 | 4 | 1.2 | 3 | 1.2 | 3.3
Functionality | 5 | 1.5 | 4 | 1.2 | 5 | 2.0 | 4.7
Maintainability | 4 | 1.2 | 4 | 1.2 | 3 | 1.2 | 3.6
Cost | 5 | 1.5 | 4 | 1.2 | 5 | 2.0 | 4.7
Accessibility | 4 | 1.2 | 5 | 1.5 | 4 | 1.6 | 4.3

Table 3.4 Decision Matrix of Multiple Design Constraints

The decision matrix evaluates the major design constraints considered in the

development of the hydroponics monitoring system, namely power supply, monitor display, and

sensor type. Sensor type was given the highest weight (0.4) because measurement accuracy and

reliability directly affect crop health and overall system effectiveness. Power supply and monitor

display were each assigned a weight of 0.3 due to their importance in ensuring continuous

operation and clear user interaction.

The results show that functionality and costobtained the highest total weighted scores

(4.7), indicating that the selected components prioritize reliable operation and cost-effective

system.

Cost Constraints

The cost constraint for the monitor display considers the affordability of the LCD

compared to alternative display technologies such as OLED. The LCD scored high in cost-

effectiveness because it provides sufficient functionality at a lower price point, making it more

suitable for a budget-constrained hydroponics monitoring system while still meeting user

interface requirements.

Functionality Constraints

The functionality constraint for the power source evaluates how reliably and consistently

the system can operate. The wall plug power supply scored higher because it provides stable and

continuous power without interruption, ensuring accurate sensor readings, consistent LCD

updates, and uninterrupted timer operation compared to a battery-based system that may

experience voltage drops over time.

Accessibility Constraints

The accessibility constraint for the sensor type focuses on availability, ease of

procurement, and ease of integration. Consumer-grade sensors scored higher in accessibility

because they are widely available, affordable, and compatible with microcontroller platforms

like the ATmega328P, whereas industrial-grade sensors may require specialized suppliers,

higher budgets, and more complex interfacing.

H. Trade-offs
Constraint | Trade-Offs
Monitor Display | LCD: Using an LCD offers simplicity, readability, and lower cost, but it sacrifices advanced graphical capability, higher contrast, and aesthetic appeal compared to more modern displays. OLED: Using an OLED provides better contrast, sharper visuals, and improved aesthetics, but it comes at a higher cost and may introduce unnecessary complexity of software in terms of integration.
Power Source | Battery Source: Using a battery allows portability and flexibility in placement, but it requires regular charging or replacement and may introduce downtime if power is depleted. Wall Plug: Using a wall plug provides stable and continuous power for long-term operation, but it limits portability and makes the system dependent on a constant electrical supply.
Type of Sensor | Consumer-Grade Sensor: These are significantly more accessible and easier to integrate into microcontroller-based systems, but they generally offer lower accuracy, reduced long-term stability, and require more frequent calibration compared to industrial-grade options. Industrial Sensor: Industrial-grade sensors provide higher precision, durability, and better resistance to environmental variations, but they come at a much higher cost and may require more complex interfacing and signal conditioning.

Table 3.5 Trade-Offs for Each Category

Cost Trade-Offs

The trade-off between LCD and OLED displays centers on the cost of the material.

OLED displays offer higher contrast, sharper visuals, and better viewing angles, which can

improve user experience and make data appear more modern and visually appealing. However,

OLEDs are generally more sensitive to voltage fluctuations, potential burn-in issues, and long-

term degradation, especially in continuously operating monitoring systems. They may also

consume more power depending on usage.

On the other hand, LCDs (such as 16x2 or 20x4 I2C modules) provide stable

performance, lower cost, and strong long-term durability. While they may not match OLED in

contrast and aesthetic appeal, they are highly reliable for displaying numeric sensor readings and system messages. The trade-off therefore involves choosing between enhanced visual

quality (OLED) and proven robustness and practicality (LCD), with the LCD often being more

suitable for continuous environmental monitoring applications.

Functionality Trade-Offs

The trade-off between a wall plug power supply and battery operation primarily involves

reliability versus portability. A wall plug provides a stable and continuous power source, which

ensures uninterrupted monitoring and reduces the risk of sudden shutdowns that could

compromise data collection. It also eliminates concerns about battery depletion, swelling, or

overheating when improperly managed. However, it limits mobility and makes the system

dependent on an available power outlet.

In contrast, battery-powered systems offer portability and flexibility in installation,

which can be beneficial in areas without accessible power sources. However, batteries introduce

safety risks such as overcharging, overheating, leakage, and inconsistent voltage output as

charge decreases. For long-term hydroponic monitoring, the trade-off favors wall plug systems

due to greater operational stability and reduced maintenance requirements, even though battery

systems provide greater flexibility.

Accessibility Trade-Offs

The trade-off between consumer-grade and industrial-grade sensors revolves around

accuracy and durability versus cost and ease of integration. Industrial-grade sensors provide

higher precision, better calibration stability, and greater resistance to environmental factors such

as moisture and chemical exposure. They are designed for long-term deployment in professional agricultural or industrial settings. However, they are significantly more expensive, may require

specialized interfacing circuits, and can complicate system integration.

Consumer-grade sensors, while generally less precise and more prone to calibration drift,

are affordable, widely available, and easier to interface with microcontrollers like Arduino or

similar platforms. They are well-supported by online documentation and libraries, making

system assembly more straightforward and practical for prototype or academic projects. The

trade-off therefore involves balancing performance and durability against budget constraints and

implementation simplicity, with hobby-grade sensors often being more feasible for small-scale

system development.

I. Implementation of Alternative Solutions

Strategies for Monitor Display

Category | Alternative Solution 1: 20x4 LCD (I2C) | Alternative Solution 2: OLED Display
Constraints | Limited to text-only display; no advanced graphics; fixed character layout; depends on backlight for visibility; simpler interface aligned with ATmega328P memory limits | Supports graphical interface and flexible layouts; requires more memory and processing power; slightly higher cost; may introduce UI complexity for users
Trade-offs | Lower cost, lower power consumption, easier programming, highly compatible with microcontroller limitations, but less visually dynamic | More visually appealing and customizable interface, better GUI potential, but higher resource demand, increased complexity, and added cost

Table 3.6 OLED Display and 20x4 LCD Display Comparison Table

The comparison shows that the 20x4 LCD better satisfies the functionality requirements of

the hydroponics monitoring system. Because the system primarily displays numerical values such

as temperature, pH, TDS, and timer information, a simple multi-line text display is sufficient. The

20x4 LCD allows multiple parameters to be shown simultaneously without the need for scrolling, which improves real-time monitoring and makes it easier for farmers to quickly interpret the data.

Additionally, its readability under brighter outdoor conditions makes it practical for agricultural

environments.

Although OLED displays offer higher resolution and graphical capabilities, these features

are not essential for the intended functionality of the system. The ability to display icons and

advanced layouts does not significantly enhance the core monitoring purpose. Moreover, OLED

modules may require additional formatting and careful brightness control. For a system focused

on clarity, simplicity, and real-time numeric data presentation, the 20x4 LCD provides a more

functionally appropriate solution.

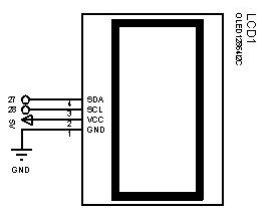
[picture p24: figure]

Figure 3.22 Alternative Solution: OLED Display

The OLED display is connected directly to the microcontroller using the I²C interface

through the SDA and SCL lines, along with power (VCC) and ground (GND). The OLED

provides high contrast and clear visibility without the need for a backlight, improving readability

and power efficiency. However, OLED displays are more expensive than LCDs and may

experience reduced lifespan due to pixel degradation over extended operation.

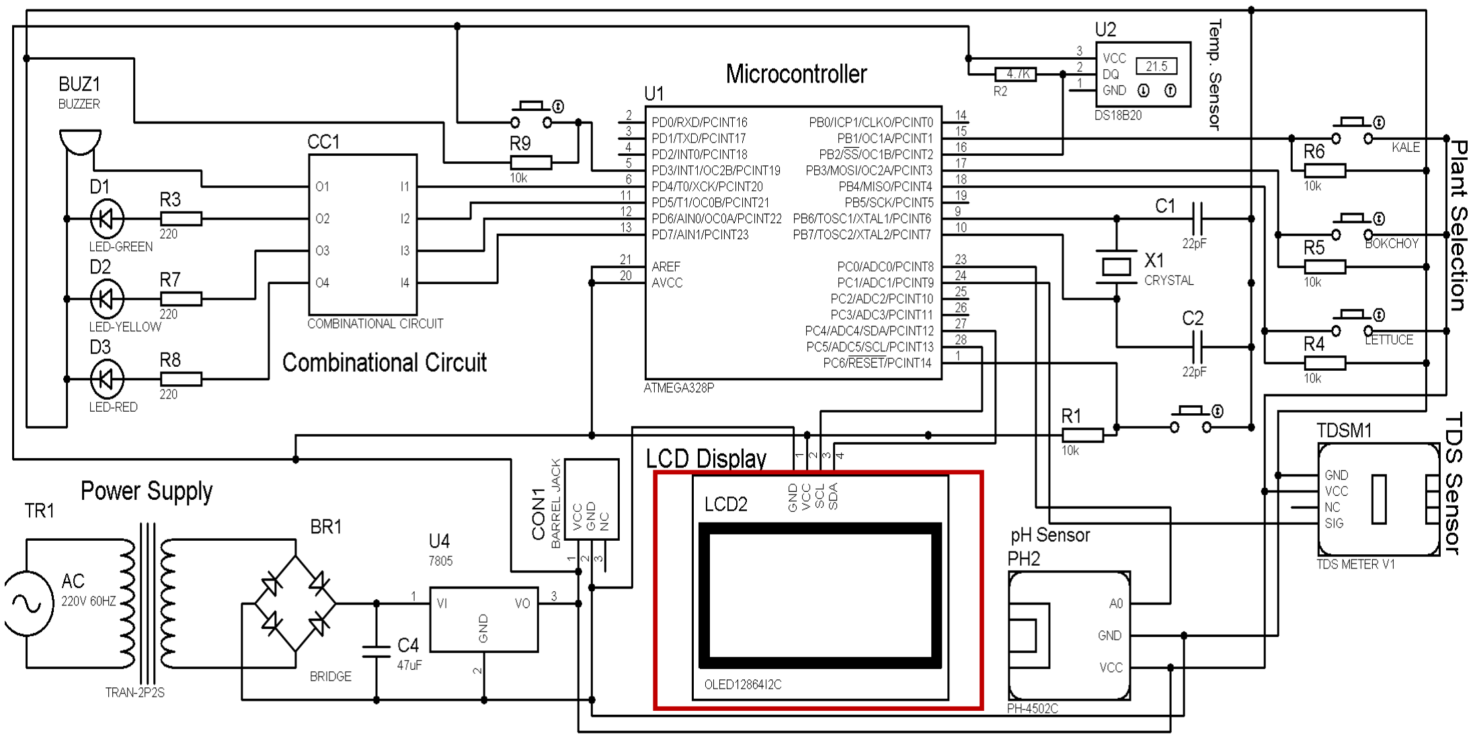
[picture p25: figure]

Figure 3.32 Alternative Solution using OLED

This figure shows the implementation of the alternative solution utilizing OLED for the

display for the monitoring system. The OLED uses I²C communication, minimizing the number

of required connections and simplifying the overall circuit design. This makes the system more

compact for continuous monitoring of hydroponic parameters. This display utilizes the same

configuration as the original.

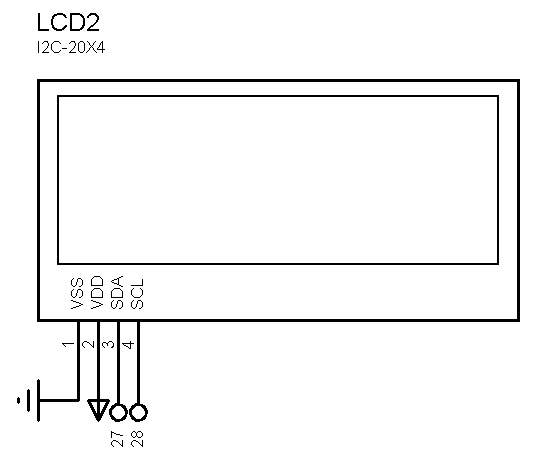
[picture p26: figure]

Figure 3.23 Alternative Solution: LCD Display

The figure shows the alternative solution using an LCD display, which is cost-effective,

easily obtainable, and stable for continuous operation in monitoring systems. The LCD is

connected to the microcontroller via a PCF8574 I/O expander using the I²C protocol, allowing

SDA and SCL lines to reduce GPIO usage. The expander drives the LCD control pins (RS, RW,

E) and data pins (D0–D7), while VSS, VDD, and VEE handle power and contrast. Although this

design simplifies wiring, the LCD has lower contrast and depends on a backlight, which can affect

visibility and power efficiency.

Strategies for Power Supply

Category | Alternative Solution 1: Wall Plug | Alternative Solution 2: Battery
Constraints | Requires stable AC source; potential electrical hazard if improperly | Limited operating time; risk of overcharging, overheating, or battery

| insulated; limited portability; must ensure proper voltage regulation and grounding | degradation; requires charging management circuit; voltage drops as battery discharges
Trade-offs | Provides continuous and stable power with minimal user intervention, but depends on external power availability and proper electrical safety measures | Offers portability and operation during power outages, but introduces maintenance needs, runtime limitations, and additional safety considerations related to battery handling

Table 3.7 Battery Power and Wall Plug Power Comparison Table

The table shows that from a safety perspective, wall plug power provides superior

operational stability and reliability compared to battery power. Because hydroponic monitoring

systems rely on accurate and continuous sensor readings, consistent voltage supply is critical. A

wall plug ensures uninterrupted operation and minimizes the risk of system resets or inaccurate

data caused by voltage drops, making it more appropriate for long-term deployment.

Battery power, while advantageous in terms of portability and flexible placement,

introduces limitations in runtime and voltage stability. As the battery discharges, fluctuations

may affect sensor accuracy and overall system performance. Additionally, the need for periodic

charging or replacement increases maintenance demands. Therefore, although battery systems

provide mobility benefits, wall plug power is generally more functionally reliable for continuous

environmental monitoring applications.

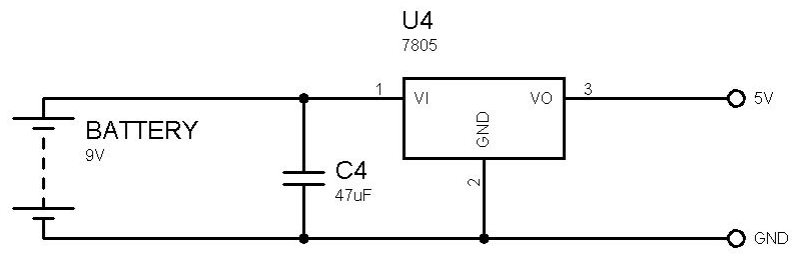
[picture p27: figure]

Figure 3.24 Alternative Solution: Battery

The figure shows a 9 V battery used as an alternative power source, regulated to 5 V using

a 7805-voltage regulator. The battery is connected to the regulator input (VI), while the output

(VO) provides a stable 5 V supply to the system. Capacitor C4 is included to smooth voltage

fluctuations and improve regulator stability, with the ground shared across the circuit. This solution

allows portable and independent operation without reliance on mains power. However, it is less

efficient due to heat dissipation in the linear regulator and requires regular battery replacement or

recharging.

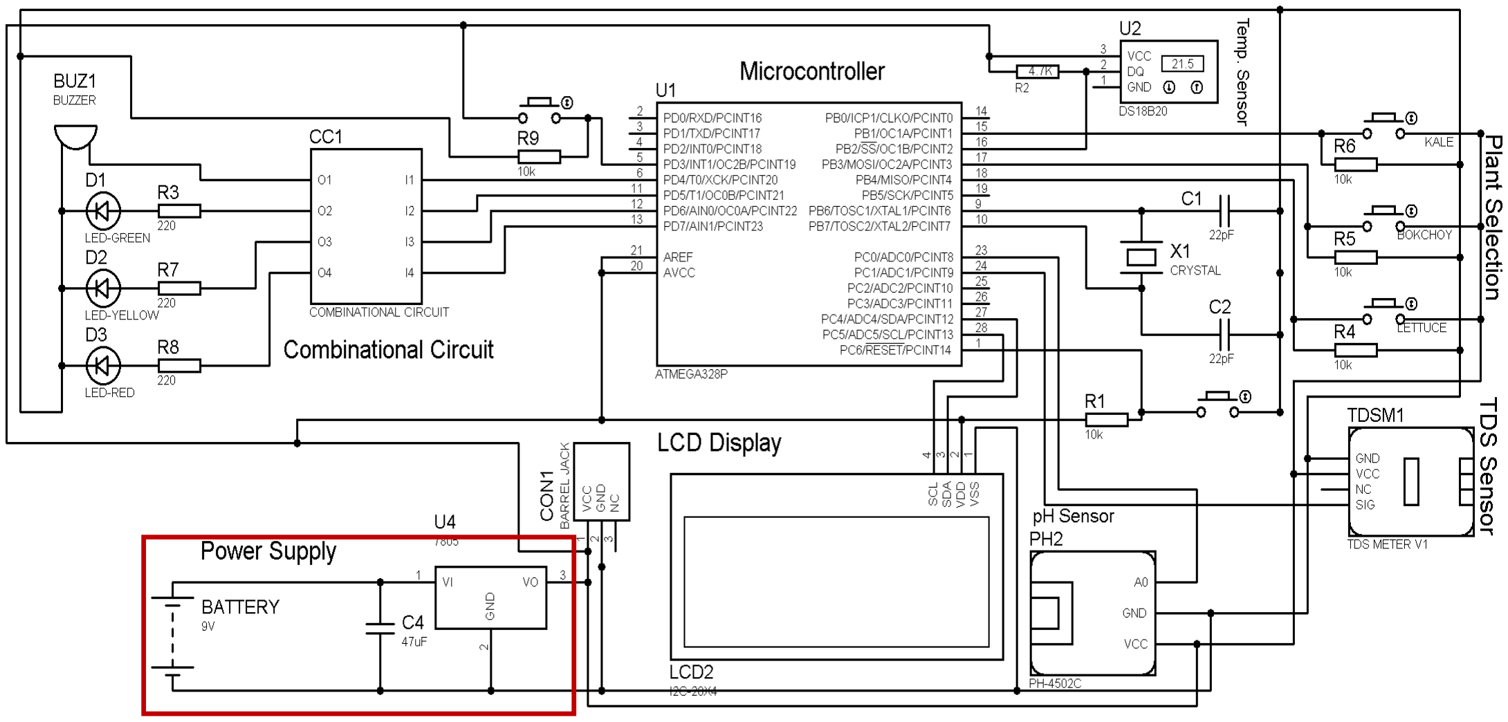
[picture p28: figure]

Figure 3.33 Alternative Solution using a 9V battery

This figure shows the whole schematic diagram utilizing a 9v battery power supply. This

battery provides the raw voltage, while the 7805 regulator "steps it down" and stabilizes it to a

constant 5V DC to safely power the ATmega328P and the hobby-grade sensors. This makes the

device portable, though a 9V battery may drain quickly given the power requirements of an LCD

and multiple sensors.

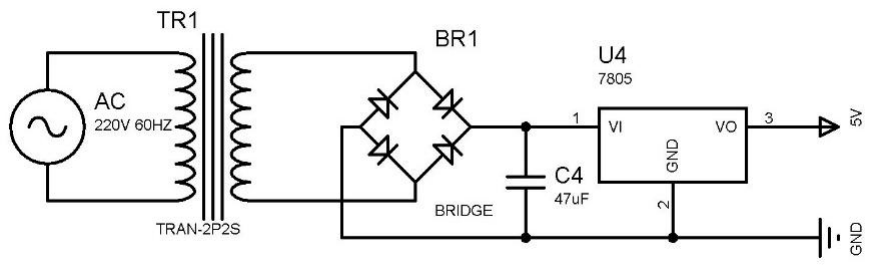
[picture p29: figure]

Figure 3.25 Alternative Solution: Power Supply

Figure illustrates a linear regulated power supply designed to convert high-voltage AC into

a stable 5V DC output. The process begins with TR1, a step-down transformer that reduces the

220V mains voltage to a lower AC level. This signal then enters BR1, a bridge rectifier that flips

the negative cycles of the AC wave to positive, creating pulsating DC. C4, a large smoothing

capacitor, acts as a reservoir to filter out these pulses and provide a steadier voltage. Finally, U4

(a 7805 linear regulator) trims the voltage down to a precise 5V, shedding any excess energy as

heat.

Strategies for Type of Sensors

Category | Alternative Solution 1: Consumer-Grade Sensors | Alternative Solution 2: Industrial-Grade Sensors
Constraints | Easier to source and integrate; compatible with Arduino/ATmega328P; requires calibration; moderate accuracy and durability; limited environmental protection | Requires specialized interfacing and signal conditioning; higher precision; more robust housing; designed for harsh environments; higher cost and procurement lead time
Trade-offs | Lower cost and simpler implementation, but may require | Higher reliability, accuracy, and long-term stability, but increases system

frequent calibration and careful handling to maintain accuracy

complexity, | cost, | and construction
requirements
Table 3.8 Industrial-Grade Sensors and Hobby-Grade Sensors Comparison Table

The comparison highlights that hobby-grade sensors are more suitable for

constructability within a student-level hydroponics monitoring project. Their plug-and-play

nature simplifies assembly and reduces the need for complex signal conditioning circuits. Since

the system is built around the ATmega328P and Arduino IDE, hobby-grade modules integrate

directly with available libraries, allowing faster development and easier troubleshooting. This

significantly improves constructability, especially when working within limited technical and

financial resources.

On the other hand, industrial-grade sensors provide superior durability and long-term

stability but introduce greater complexity in installation and system integration. They may

require specialized communication protocols, additional interface modules, and higher-quality

enclosures, which increase both design complexity and overall cost. For a prototype intended to

be affordable and easy to assemble, hobby-grade sensors offer a more practical balance between

build simplicity and functional performance.

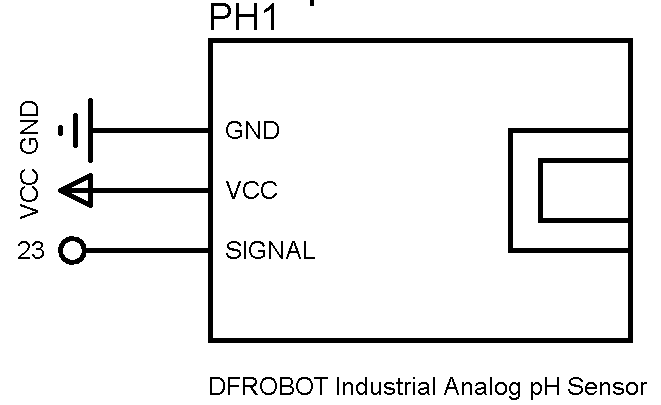
[picture p30: figure]

Figure 3.26 Alternative Solution: Industrial pH Sensor

The figure shows the DFRobot Analog Industrial pH model – designed for continuous

immersion in challenging liquids like wastewater or chemical tanks. It features a specialized signal conditioning circuit with a high-performance instrumentation amplifier that provides much higher

input impedance industrial probe. It has a ruggedized, chemical-resistant body and a BNC or

industrial waterproof lead that prevents signal degradation over long distances. However it has a

significantly higher cost and the fact that the probe still requires periodic cleaning and professional

calibration to maintain its accuracy in industrial settings.

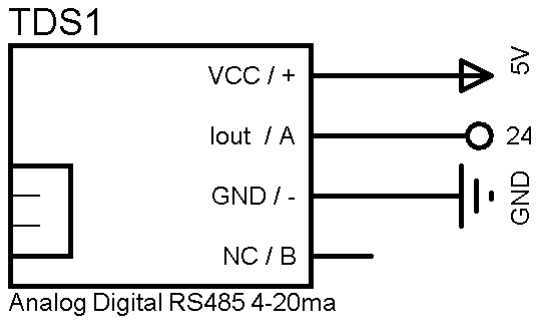
[picture p31: figure]

Figure 3.27 Alternative Solution: Industrial TDS Sensor

The industrial TDS sensor utilizes a 4-20mA current loop or RS485 (Modbus)

communication to transmit data reliably without voltage drops or electromagnetic interference. It

has a sophisticated microcontroller-driven AC system that can adjust frequency to match the

water's salinity. It has high resistance to electrical noise from nearby motors and the ability to run

cables for hundreds of meters without losing accuracy. The cons are the increased complexity of

the wiring (requiring industrial power levels like 12V-24V) and a much larger physical footprint

compared to hobby modules.

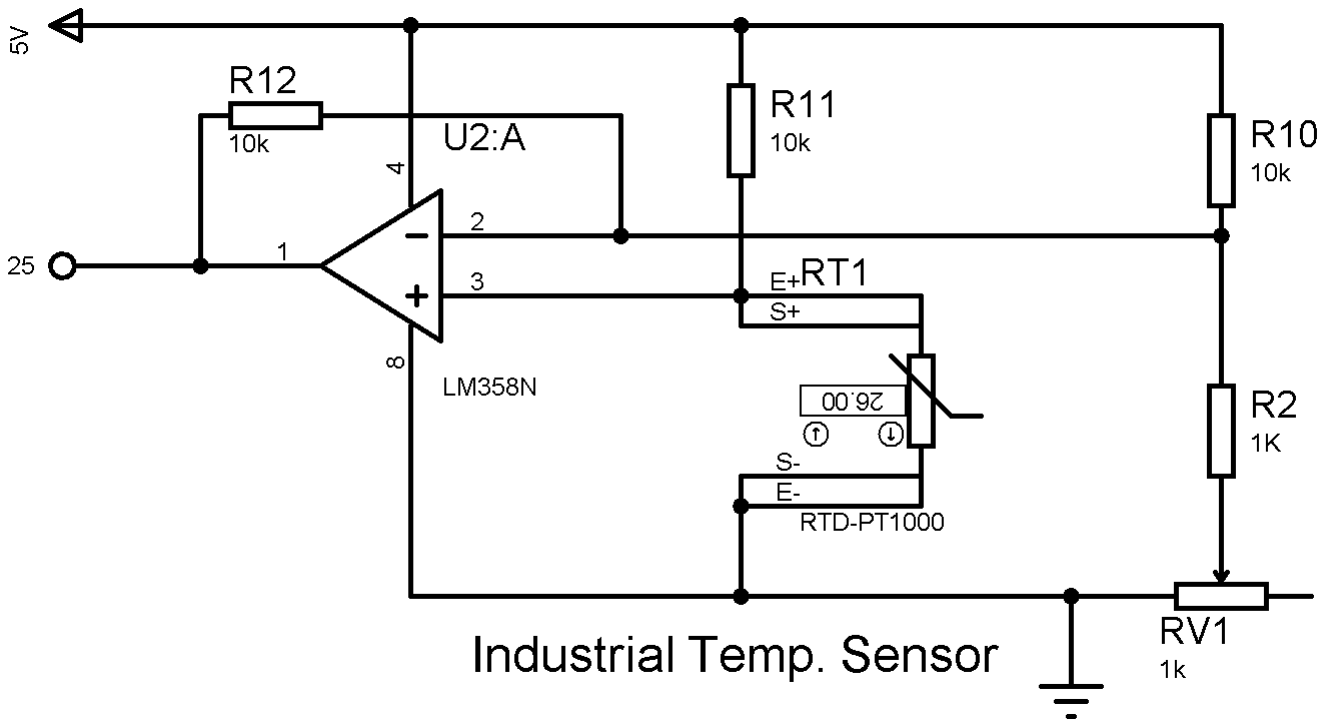
[picture p32: figure]

Figure 3.28 Alternative Solution: Industrial Temp Sensor

The industrial temperature sensor shown in this figure schematic uses a Resistance

Temperature Detector, specifically a PT1000, which is vastly more stable and accurate than a

standard digital sensor. The schematic depicts a Wheatstone Bridge configuration feeding into an

LM358 operational amplifier; this setup converts the minute changes in the platinum element's

resistance into a linear voltage or current signal. Its has a wide temperature range and "platinum-

level" precision that does not drift over years of operation. The cons are that it requires a much

more complex analog-to-digital conversion process and is highly sensitive to the resistance of the

lead wires themselves, often requiring a 3-wire or 4-wire compensation circuit to be truly accurate.

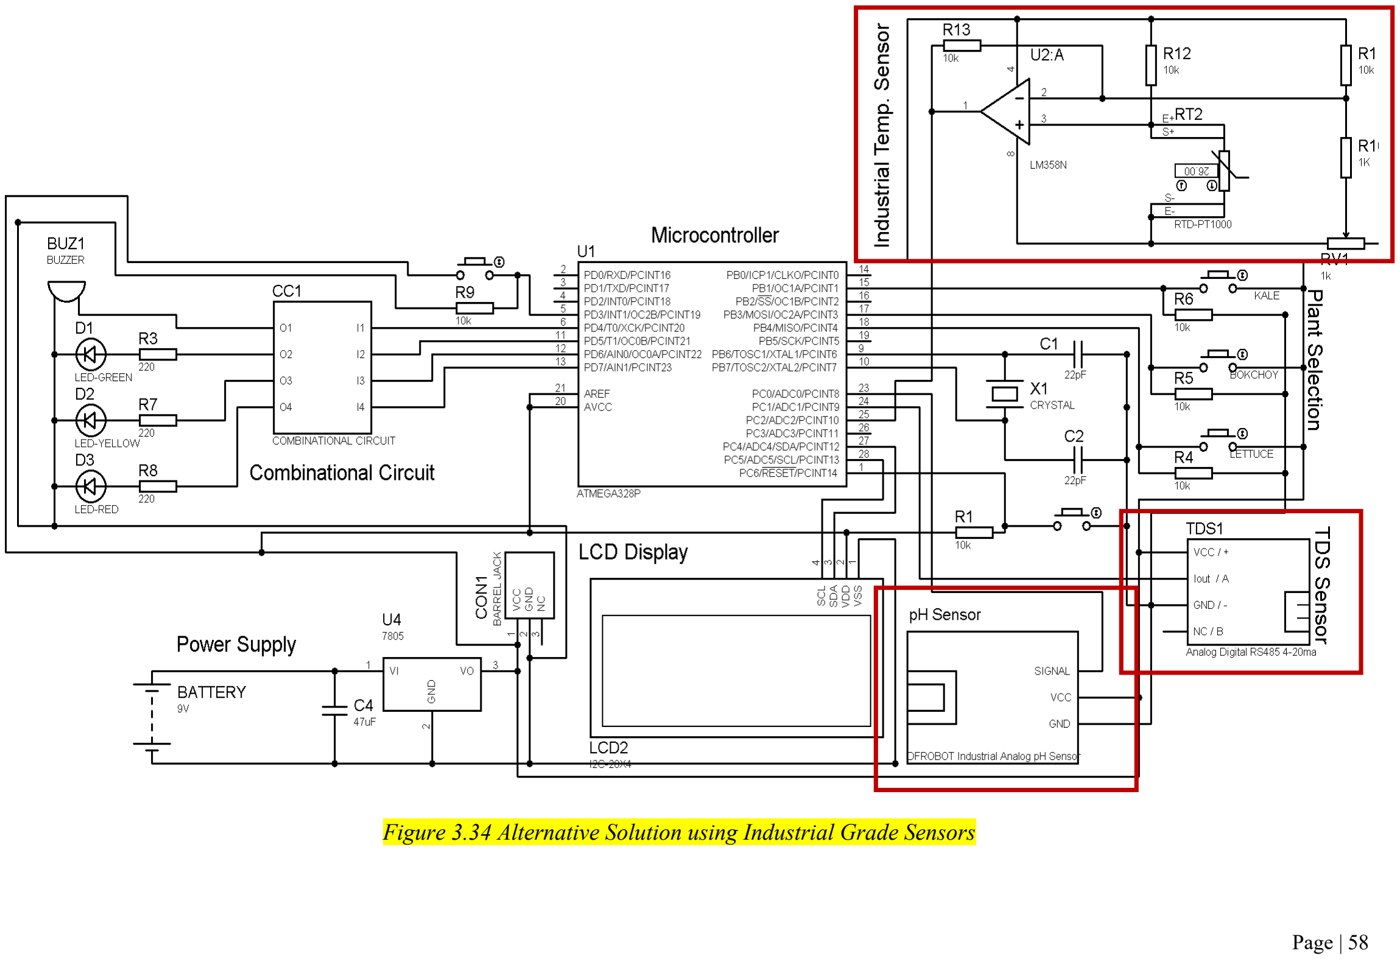
[picture p33: page 58]

Figure 3.34 Alternative Solution using Industrial Grade Sensors

Figure 3.34 shows the implementation of alternative solution using industrial grade sensors.

The schematic establishes the Industrial pH, TDS, and RTD-PT1000 sensors feeding their

conditioned signals into an ATmega328P microcontroller. These sensors provide much higher

input impedance and precision that does not drift over years of operation because of their internal

built-in assets.

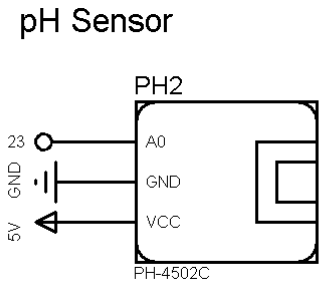
[picture p34: figure]

Figure 3.29 Alternative Solution: Hobby-Grade pH Sensor

Figure 2.29 shows a hobbyist pH sensor module which uses a glass electrode and a signal

conditioning board to translate the chemical activity of hydrogen ions into a readable voltage.

Inside the probe, a potential difference is generated across a thin glass membrane based on the

liquid's acidity or alkalinity, behaving essentially like a high-impedance battery. Because this raw

signal is incredibly weak, the schematic features a high-impedance operational amplifier (Op-Amp)

that buffers and amplifies the signal into a standard 0–5V analog output. The main pros are its high

sensitivity and ability to provide a full range of 0–14 pH data, while the cons include extreme

fragility, the requirement for frequent calibration in buffer solutions, and the need to keep the probe

wet in KCL storage solution to prevent permanent damage.

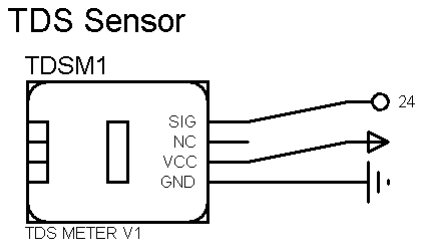
[picture p35: figure]

Figure 3.30 Alternative Solution: Hobby-Grade TDS Sensor

The Figure 3.30 shows a TDS sensor. Its schematic is built around an oscillator (like the

CD4060) that sends an AC signal through two metal probes; using AC is critical because it

prevents "polarization," a process where ions build up on the needles and cause corrosion or false

readings. This conductivity signal is then rectified and filtered into a stable DC voltage that a

microcontroller can interpret as parts per million (ppm). It is low cost, durable, and waterproof,

however it has an inability to detect non-conductive pollutants (like oil) and sensitivity to

"electrical noise" if other sensors are used in the same container.

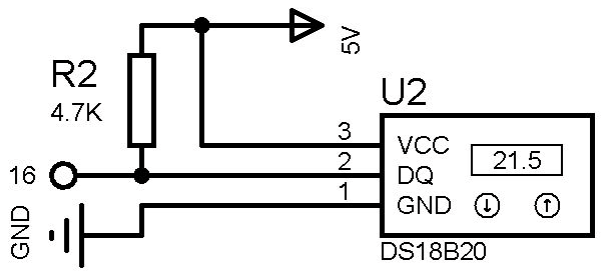
[picture p36: figure]

Figure 3.31 Alternative Solution: Hobby-Grade Temp Sensor

The figure shows the DS18B20 which is a fully digital thermometer that communicates

over a specialized 1-Wire bus. The internal schematic includes a temperature-sensitive crystal

oscillator and a digital counter that converts thermal changes directly into a 9-bit to 12-bit digital

value. This allows for high accuracy, signal stability over very long wires, and the ability to connect

dozens of sensors to a single digital pin. But it has a relatively slow sampling rate and the

requirement for specific software libraries to handle its unique 1-Wire communication protocol.

J. Selection of Alternative Solution

Cost Selection of Alternative Solution

Criteria | Weight | 20×4 I2C LCD Score | Weighted Score | OLED Display Score | Weighted Score
Reliability / Noise Immunity | 0.4 | 5 | 2.0 | 3 | 1.2
Readability (clarity & layout) | 0.3 | 4 | 1.2 | 5 | 1.5
Ease of Integration | 0.2 | 5 | 1.0 | 3 | 0.6
Cost | 0.1 | 5 | 0.5 | 2 | 0.2
Total Weighted Score | 1.0 | | 4.7 | | 3.5

Table 3.9 Selection of Alternative Solutions: Monitor Display

For the user interface, the project selected a 20x4 LCD over an OLED display. This choice was

made to prioritize simplicity and usability. The LCD provides sufficient space to clearly display

sensor readings in a very minimal and simple manner. While OLED displays could have improved

the aesthetic appeal of the GUI of the project, they were deemed unnecessary for the scope of this

project.

Functionality Selection of Alternatives

Criteria | Weight | Battery Power Score | Weighted Score | Power Plug Score | Weighted Score
Reliability & Continuous Operation | 0.4 | 2 | 0.8 | 5 | 2.0
Maintenance Requirements | 0.2 | 2 | 0.4 | 5 | 1.0
Cost (Long-term) | 0.2 | 3 | 0.6 | 4 | 0.8

Ease of Use | 0.1 | 3 | 0.3 | 5 | 0.5
Portability | 0.1 | 5 | 0.5 | 1 | 0.1
Total Weighted Score | 1.0 | | 2.6 | | 4.4

Table 3.10 Selection of Alternative Solutions: Power Supply

The power supply was another critical decision point. After considering both batteries and a

direct power plug, the latter was chosen for its reliability and ease of use. A wall power plug

eliminates the need for frequent charging or battery replacements, ensuring continuous operation

in an agricultural setting. While batteries would provide greater portability, they also introduce

complexity in terms of maintenance and the risk of downtime. By selecting a power plug as the

source, the system guarantees dependable performance and minimal upkeep, aligning with the

project’s goal of creating a practical and farmer-friendly solution.

Accessibility Selection of Alternatives

Criteria | Weight | Consumer-Grade Sensors (PH-4502C, generic TDS, DS18B20) Score | Weighted Score | Industrial-Grade Sensors Score | Weighted Score
Accuracy & Stability | 0.4 | 3 | 1.2 | 5 | 2.0
Ease of Integration | 0.2 | 5 | 1.0 | 2 | 0.4
Cost | 0.3 | 5 | 1.5 | 1 | 0.3
Maintenance & Calibration | 0.1 | 3 | 0.3 | 4 | 0.4
Total Weighted Score | 1.0 | | 4.0 | | 3.1

Table 3.11 Selection of Alternative Solutions: Sensors Type

The selection of the final components for the hydroponics monitoring system was based

on the evaluation of cost, complexity, and reliability. Among the alternatives, the system used consumer-grade modules for measuring the temperature. Specifically, the DS18B20 temperature

sensor were chosen. While industrial-grade sensors offer higher accuracy and stability, their high

cost made them impractical for the project. Consumer-grade sensors provide sufficiently reliable

readings for plant monitoring when calibrated properly, making them the more appropriate

choice. This decision was made with the condition of affordability, functionality, and complexity.

K. Prototype Development

The development of the Hydroponics Monitoring System prototype is a combination of

both hardware and software components together with testing to achieve reliable results. The

primary objective was to build a system that could automatically monitor essential hydroponic

parameters all while remaining cost-effective and easy to operate for small-scale farmers. To

achieve this, the design emphasized accessibility, durability, and efficient performance despite

the use of budget-friendly components.

a. Final Schematic Design

The Final Schematic Diagram is divided into multiple parts which is under this area.

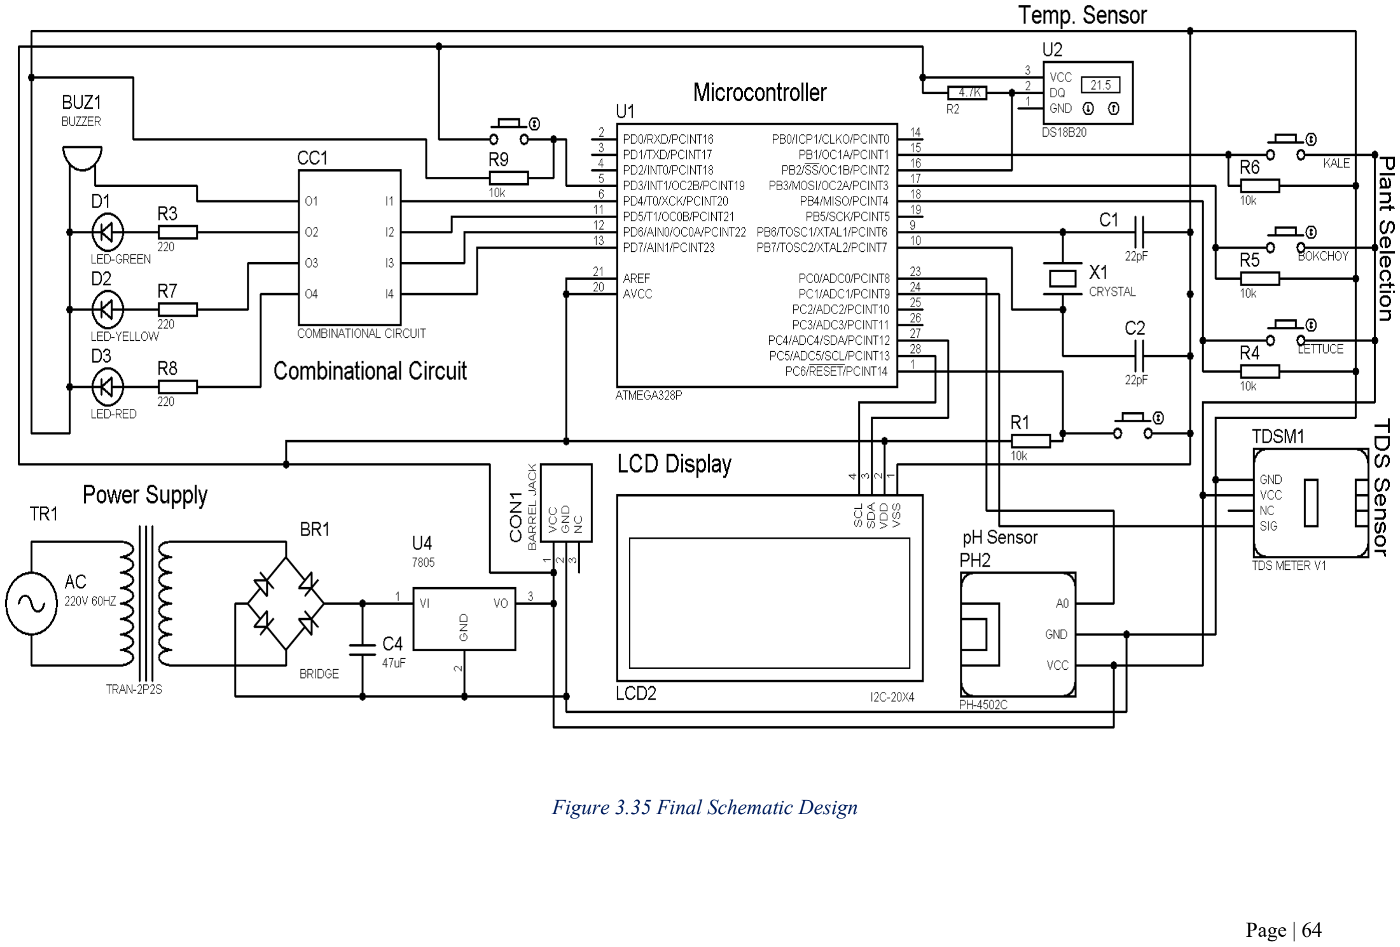
[picture p37: page 64]

Figure 3.35 Final Schematic Design

The overall schematic represents an automated hydroponic monitoring system that

integrates an ATmega328P microcontroller with sensors (pH, TDS, and Temperature) to drive

logic. This system highlights the three primary sensing units and how they interface with the

control system. The pH Sensor uses a standard glass probe and a basic signal conditioning board

to convert chemical activity into an analog voltage. The TDS Sensor measures water conductivity

using two metal needles and a simple oscillator circuit to estimate the parts per million (ppm) of

dissolved solids. The Temperature Sensor (DS18B20) is a digital thermometer that communicates

over a 1-Wire bus. It is praised for its ease of use and accuracy.

The ATmega328P acts as the central brain. It receives signals from the industrial sensors

and translates them from raw electrical values into meaningful data (like pH units or degrees

Celsius). It is programmed with specific "thresholds"—for example, it knows that Lettuce needs a

different pH than Kale. The "Plant Selection" block uses logic gates (AND/OR gates) to compare

the sensor data against specific profiles. By toggling switches for different plants (e.g., Lettuce,

Bokchoy, Kale), the system changes its "Ideal Range." If the TDS or pH goes above the limit for

your selected plant, the logic circuit outputs a “bad” output signal. The LCD Display shows the

exact numerical values so you can see exactly how far off the levels are. While the buzzer (BUZZ1)

provides an audible alarm to notify you immediately if a pump fails or if the nutrient concentration

becomes toxic. The following diagrams picture each part that makes up the system:

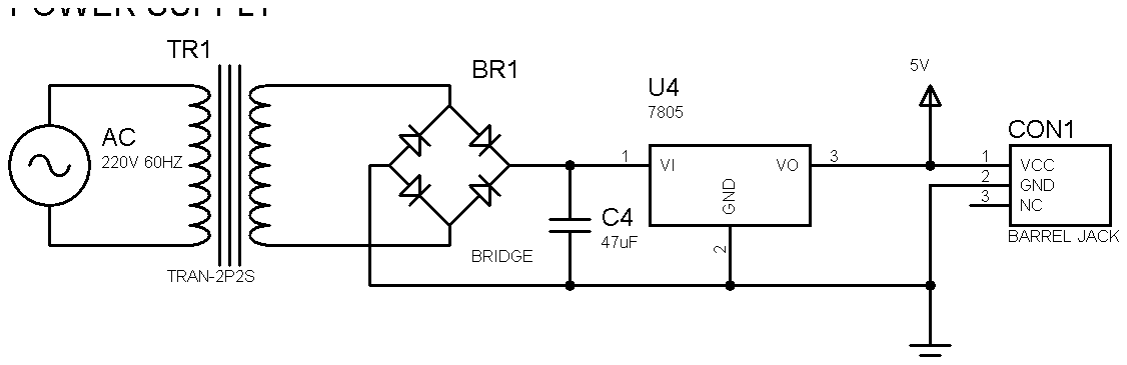
[picture p38: figure]

Figure 3.36 Power Supply

This circuit converts 220V AC to 5V DC through four stages: TR1 steps down the voltage,

BR1 rectifies AC to pulsating DC, C4 smooths the pulses into a steady signal, and U4 (7805)

regulates the final output to a precise 5V by dissipating excess energy as heat. This Output is

distributed using DC barrel jack providing smooth power throughout the system.

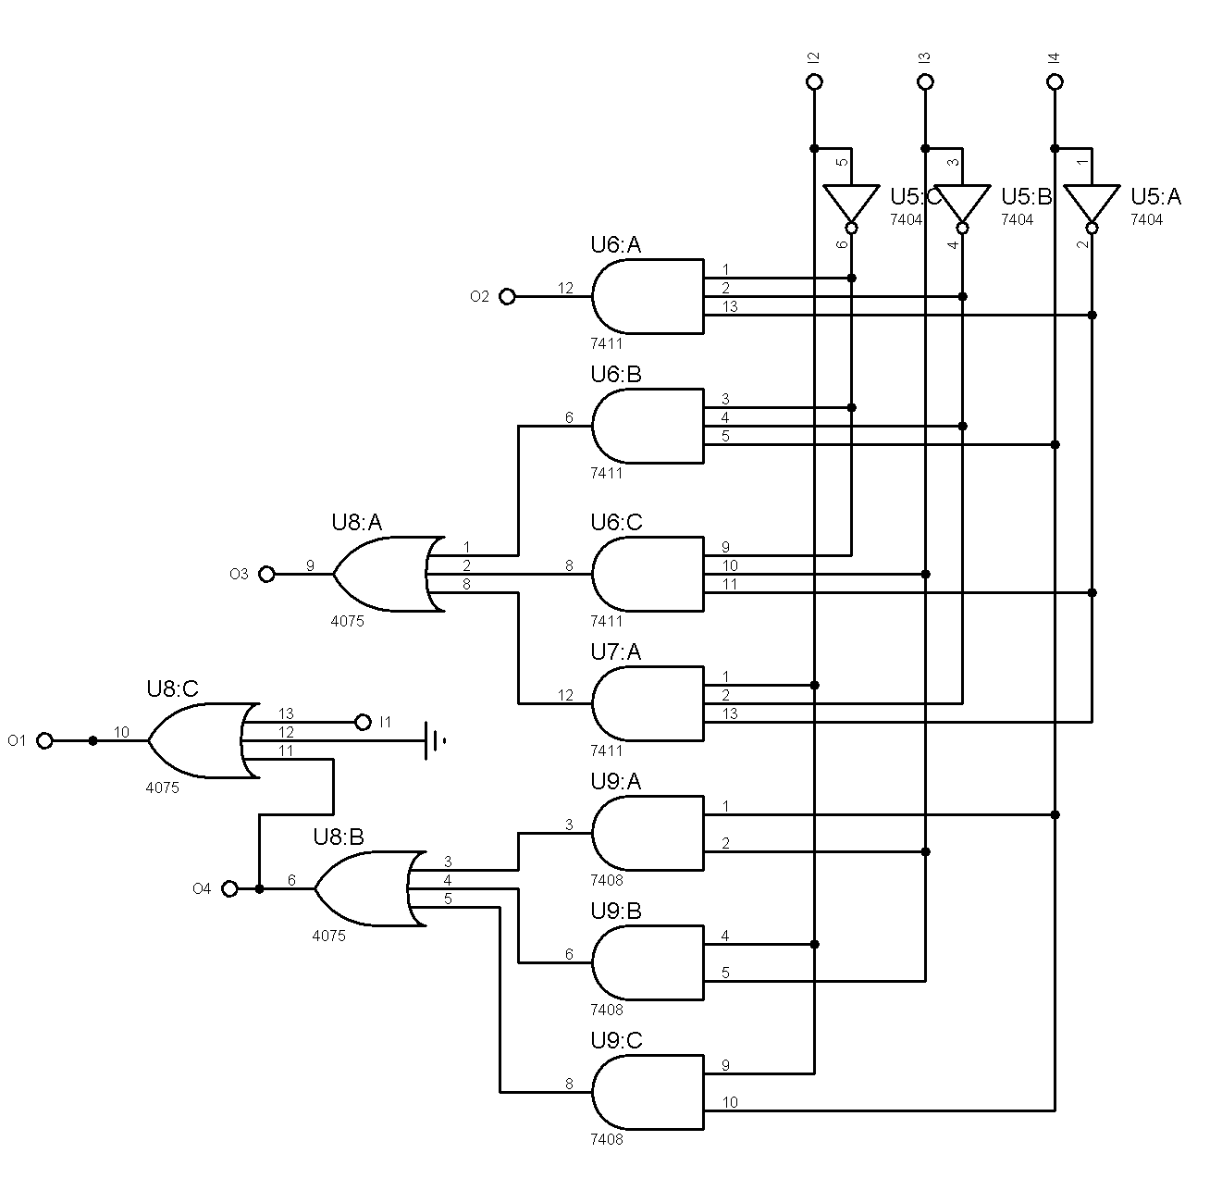
[picture p39: figure]

Figure 3.37 Combinational Circuit

The schematic illustrates a combinational logic circuit designed to monitor three binary

input signalsand translate their status into visual and audible alerts. The process begins at the input

stage with U5 (7404 Inverters), which generate the logical complements of the inputs; this allows

the circuit to evaluate both "on" and "off" states simultaneously. These signals are then fed into a

series of "detectors" composed of 7411 3-input AND gates and 7408 2-input AND gates. Each

AND gate are wired to trigger only when a very specific combination of the three inputs occurs.

For instance, U6:A directly controls the Green LED (D1), meaning the green light represents a

single "safe" or "ready" state where all conditions are met exactly as required.

The more complex status levels—Yellow and Red—utilize 4075 3-input OR gates to

aggregate different fault conditions. The Yellow LED (D2) is driven by U8:A, which glows if any

of the specific conditions detected by its connected AND gates are met, serving as a multi-

condition warning system. Similarly, the Red LED (D3) is controlled by U8:B, indicating a critical

failure or a specific set of high-priority states. At the top of the hierarchy sits U8:C, which drives

the Buzzer (BUZ1); this gate is wired to ensure that when the system reaches its most critical

logical states, an audible alarm sounds alongside the visual indicators. Each LED is protected by

a resistor to prevent burnout, ensuring the circuit functions as a reliable, real-time state decoder.

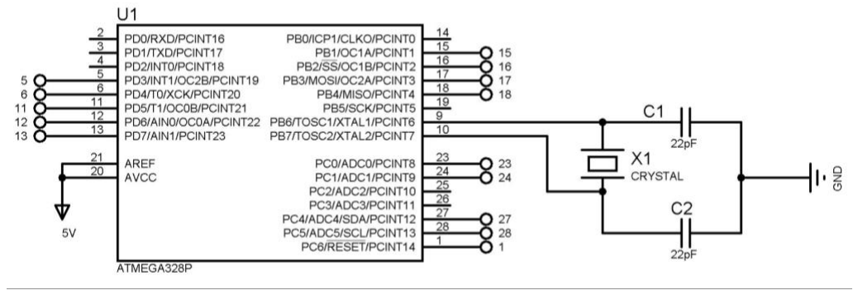
[picture p40: figure]

Figure 3.38 Microcontroller Circuit

The figure shows the core electrical blueprint for the ATmega328P microcontroller. It

illustrates the connections required for operation: a 5V power supply connected to the analog

reference pins, and an external clock circuit consisting of a crystal oscillator (X1) and two 22pF

load capacitors (C1 and C2) to provide a steady timing pulse.

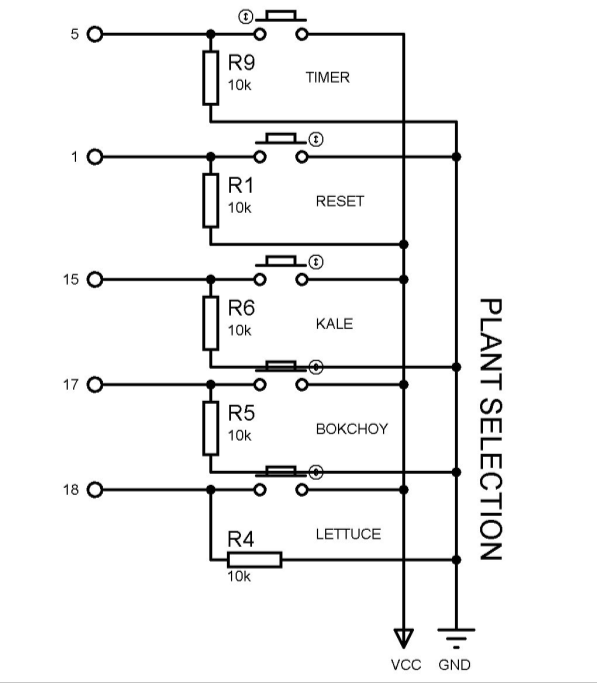
[picture p41: figure]

Figure 3.39 Button Interfaces

This figure illustrates a Button Interface for a plant selection system, featuring five tactile

switches (Timer, Reset, Kale, Bok choy, and Lettuce). Each button is configured in a pull-down

resistor arrangement. The resistors (R1, R4, R5, R6, R9) tie the input pins (5, 1, 15, 17, 18)

to Ground (GND), ensuring the microcontroller reads a "Low" signal when no buttons are pressed.

When a button is pressed, it closes the circuit to VCC, pulling the corresponding input pin "High”.

This design prevents "floating" inputs, providing a stable digital signal for the system to identify

which plant or function has been selected.

b. PCB Layout

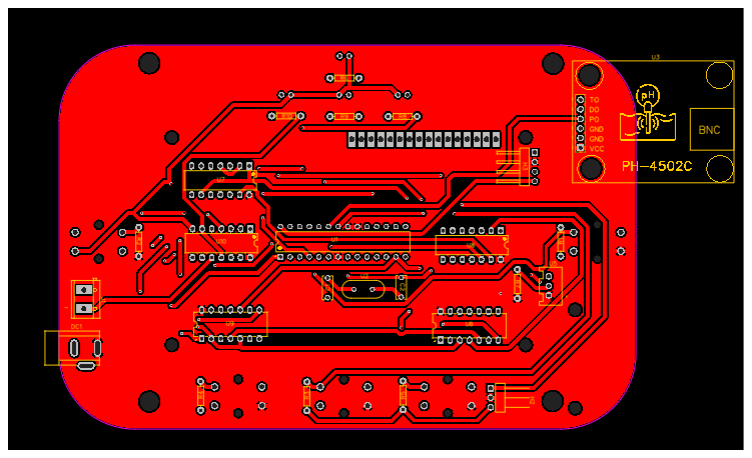
[picture p42: figure]
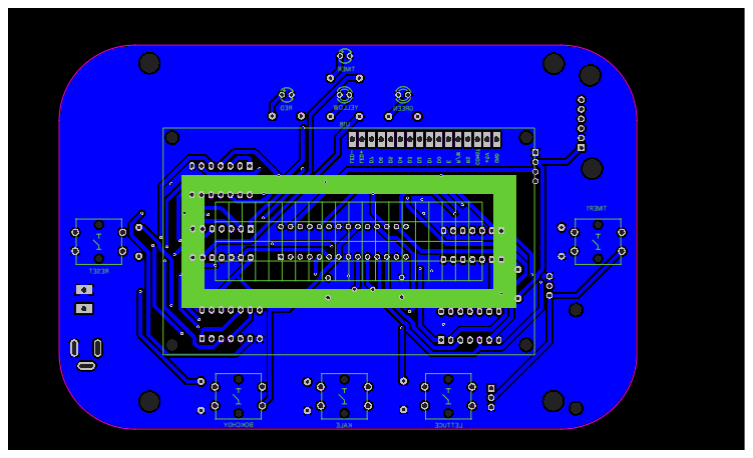
[picture p43: figure]

Figure 3.40 PCB Design Top and Bottom View

The PCB was designed and simulated using EasyEDA to ensure proper electrical

connections before physical assembly. The sensors pH, temperature, and TDS were positioned

strategically to achieve accurate readings from the solution, while the LCD and buttons were

mounted for convenient monitoring and control. The PCB uses a double-sided assembly

technique, where electronic components are placed on both sides of the board, allowing efficient

space utilization and a compact layout, with user-interfacing components on the top layer and

supporting circuitry on the bottom layer. This design approach improves signal routing and

enhances overall system reliability

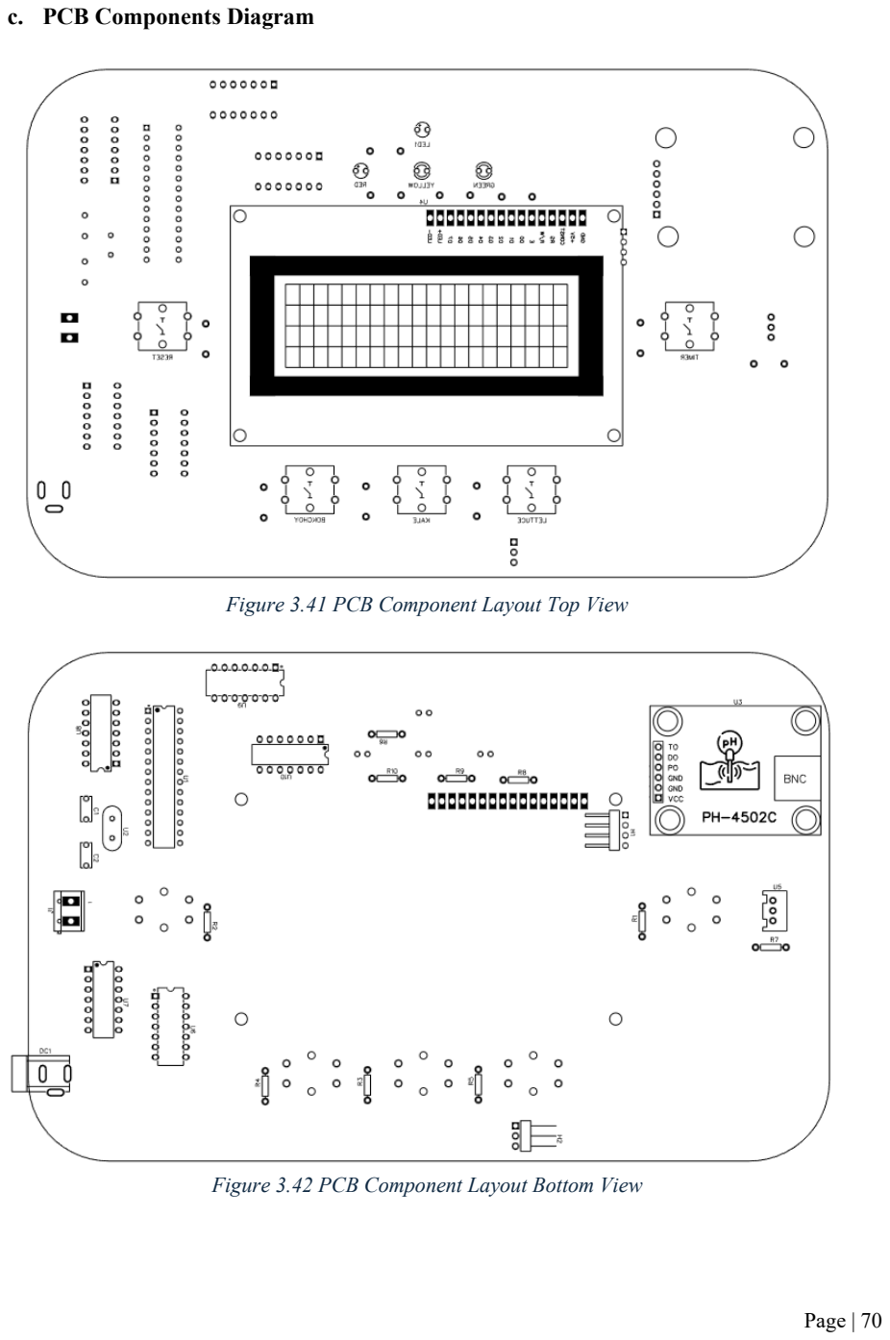
[picture p44: page 70]

c. PCB Components Diagram

Figure 3.41 PCB Component Layout Top View

Figure 3.42 PCB Component Layout Bottom View

Figure 3.41 and Figure 3.42 illustrate the component layout in both top and bottom views.

The PCB utilizes a double-sided assembly, as mentioned above. The front side consists of user-

visible interfaces, while the bottom side handles all operational components, including the

sensors and integrated circuits that require interconnection. The top view includes the LCD,

LEDs, and buzzer for the display interface, as well as buttons for plant selection, reset, and timer

setting.

Part Number | Component Name
U1 | Microcontroller (ATmega328p)
U2 | Crystal Oscillator 16MHz
U3 | pH Sensor (PH-4502C)
U4 | LCD 20X4 (LCD2004)
U5 | One Wire Temperature Sensor (DS18B20)
U6 | Hex Inverter (7404)
U7, U8 | Triple 3-input AND Gate (7411)
U9 | Quad 2-input AND Gate (7408)
U10 | Triple 3-Input OR Gates (4075)
H1 | LCD I2C Module
R1, R2, R3, R4, R5, R6, R7, R8, R9, R10 | Resistor (10kΩ, 4.5kΩ and 220Ω)
C1, C2 | Capacitor (22pF)
DC1 | DC Power Source
J1 | Buzzer

TIMER, KALE, BOKCHOY, LETTUCE, RESET | 4 pin Tactile Button
LED1, GREEN, YELLOW, RED | LED
H2 | TDS SENSOR

Table 3.12 Components of Hydroponics PCB

d. Drawing of the Proposed Casing of the Prototype

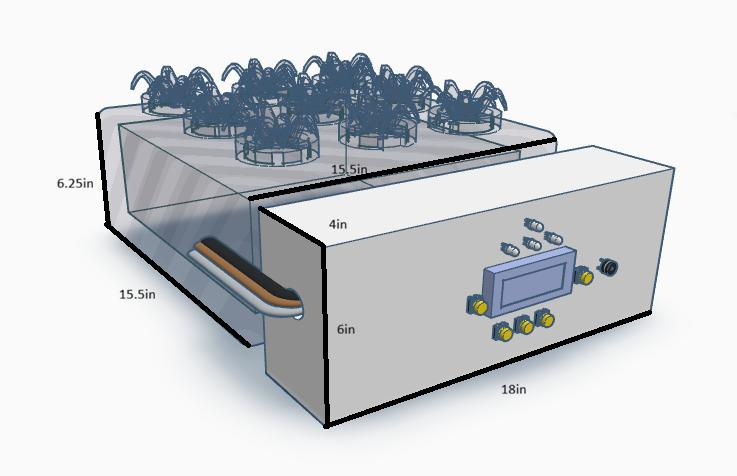
[picture p45: figure]

Figure 3.43 Proposed Casing of the Prototype

Figure 3.43 shows the proposed casing for the design setup. The setup consists of two

containers: the first container holds the hydroponic plant, while the main box contains all the

necessary components for the system. The main box can be detached and used with other

hydroponic setups. The container is made of plastic to protect the electronic components from

water exposure that could cause damage. The main box measures 4 inches in width, 6 inches in

height, and 18 inches in length. Two sides have holes for routing the sensor wires, while the

opposite side has an opening for the power cable.

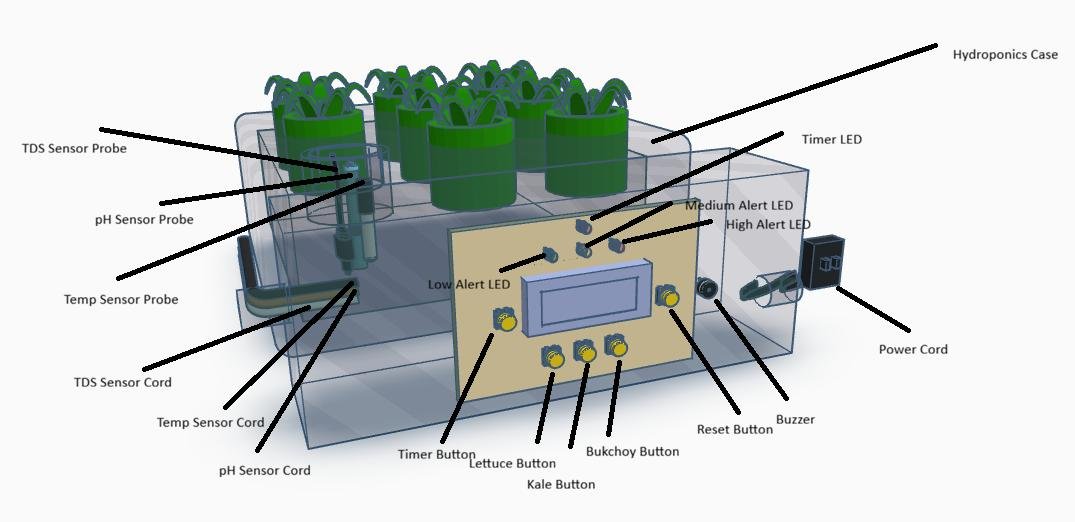
[picture p46: figure]

Figure 3.44 Proposed Design Casing Prototype Parts

Figure 3.44 shows a more detailed view of the design setup, including the names of each

component visible to the user. The main container consists of all visual indicators and alert

mechanisms for the user, while the second container can be changed depending on the user’s

hydroponic setup. The sensors are positioned outside the first container and are not fixed to a

specific structure; therefore, they can be used with other hydroponic configurations, such as a

pipeline setup. If the temperature sensor probe, pH sensor probe, and TDS sensor probe are

submerged in water, monitoring will continue based on the selected plant type.

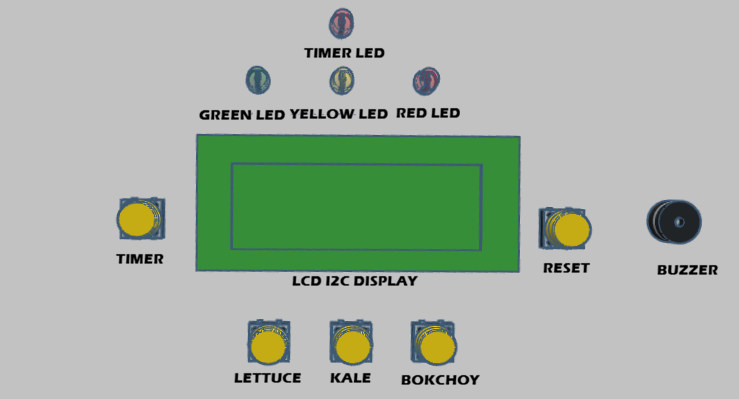
[picture p47: figure]

Figure 3.45 Proposed Design Casing Prototype Control Box

Figure 3.45 provides a closer view of the main control box of the proposed hydroponic

monitoring system. The LCD screen displays real-time readings of temperature, pH level, and

total dissolved solids (TDS), along with system notifications related to the selected plant type.

Indicator LEDs and a buzzer serve as visual and audible alerts whenever the measured

parameters exceed the acceptable range. Control buttons are included for plant selection, system

reset, and timer configuration to allow user interaction with the device. Based on the combined

sensor readings, the system continuously monitors water conditions and provides appropriate

feedback to support optimal plant growth.

e. Bill of Materials
Materials | Quantity
ATmega328p | 1
Crystal Oscillator 16MHz | 1
pH Sensor(PH-4502C) | 1
LCD 20X4 (LCD2004) | 1
One Wire Temperature Sensor (DS18B20) | 1
Hex Inverter (7404) | 1
Triple 3-input AND Gate (7411) | 2
Quad 2-input AND Gate(7408) | 1
Triple 3-Input OR Gates (4075) | 1
LCD I2C Module | 1
Resistor 10kΩ | 5

Resistor 4.5kΩ | 1
Resistor 220Ω | 4
Capacitor 22pF | 2
DC Power Source | 1
Buzzer | 1
4 pin Tactile Button | 5
LED | 4
TDS SENSOR | 1

Table 3.13 Bill of Materials

f. Pictures of the Completed Design

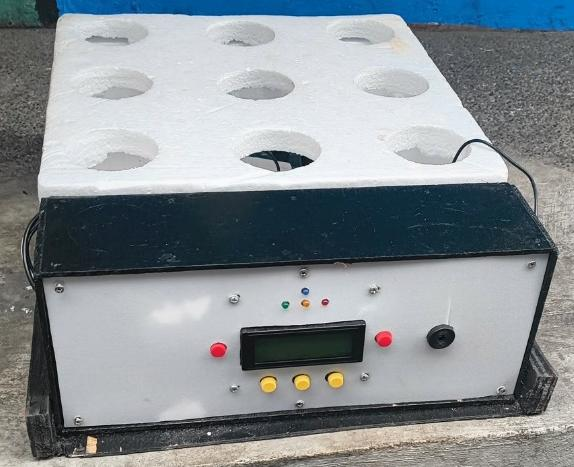
[picture p48: figure]

Figure 3.46 Prototype Layout

The hardware assembly began with the construction of the main setup using a Styrofoam

hydroponics box, which served as the plant reservoir. A wooden case was attached to the front of

this box to store the electronic components, including the sensors, printed circuit board (PCB),

LCD, buttons, LEDs, and buzzer. The layout was organized to make each component easily

accessible and clear for the user.

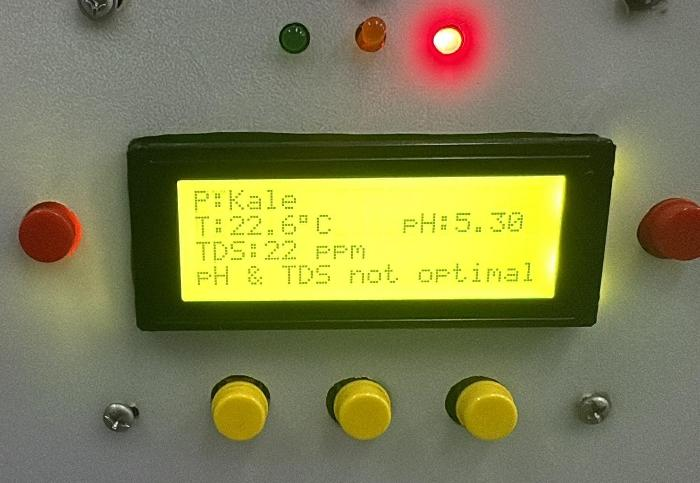
[picture p49: figure]

Figure 3.47 Prototype Display Instance

In this figure the LCD shows multiple prints indicating that the prototype is turned on. This

instance is showing that it is currently monitoring the plant kale which has its temperature, TDS, and

PH reading printed in the screen. Seen here as well is the “bad” output from both the PH and TDS as

it has deviated from the optimal range.

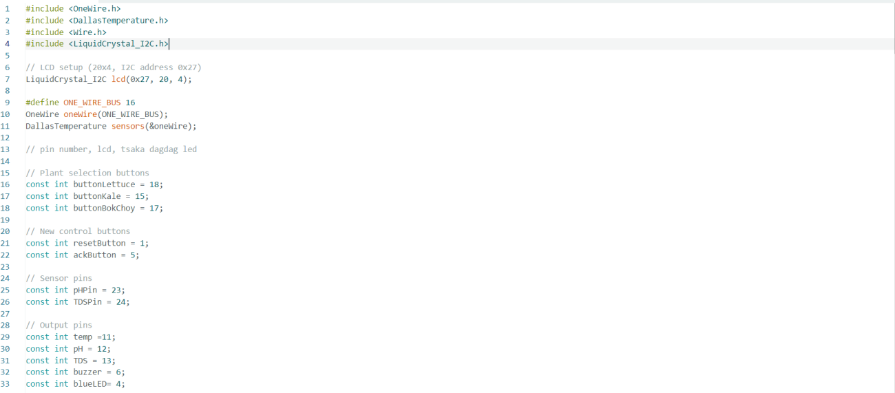
[picture p50: figure]

Figure 3.48 Code Snippet

The software development process used the Arduino IDE, with C++ as the main

programming language. This platform allowed the students to implement real-time data reading,

processing, and display features. Key libraries such as DallasTemperature were used to interface

with the DS18B20 temperature sensor, while the LiquidCrystal library handled the display of

readings on the 20x4 LCD screen. The program logic continuously read sensor values, checked

if they were within the optimal range for the selected plant type, and provided immediate alerts

through LEDs and a buzzer whenever a parameter went beyond acceptable limits. The software

was also optimized for simplicity, ensuring that even users with little technical experience could

operate the system efficiently.

Testing and refinement were also parts of the prototype development. Each hardware

component underwent individual testing before being integrated into the main system. The

sensors were evaluated for stability and accuracy, the buttons were tested for responsiveness,

and the LEDs and buzzer were verified to ensure they provided the correct visual and auditory

feedback. The LCD was checked for proper communication with the AtMega328p and clear

data display. During this stage, the pH sensor required additional attention because it needed

proper calibration to produce accurate readings; without calibration, its output tended to

fluctuate or drift over time.

Finally, once all parts were tested and are functional, the students proceeded with full

system integration and iterative adjustments. The AtMega328p coordinated all input and output

processes, allowing the sensors to update values in real time while the LCD displayed data

clearly. Several testing sessions were conducted to fine-tune timing, improve signal stability,

and ensure the system operated smoothly under continuous use. Despite the limitations of

hobby-grade sensors and the processing constraints of the ATmega328p microcontroller, the final prototype successfully demonstrated accurate, real-time hydroponic monitoring. This

phase underscored the importance of calibration, careful assembly, and iterative testing in

producing a dependable monitoring solution tailored for practical agricultural use.

Engineering Standards

The hardware components selected for the hydroponic monitoring system conform to

established international standards to ensure reliability, accuracy, and safety. The ATmega328P

microcontroller is manufactured under strict ISO-9001 quality management standards and

compliance with recognized quality assurance practices. It also meets RoHS (Restriction of

Hazardous Substances) compliance, which ensures that harmful materials such as lead are not

present in the device, making it safe for both users and the environment. The pH, TDS, and water

temperature sensors follow calibration standards provided by their manufacturers which confirm

accurate measurement of the solution conditions. For power requirements, the system utilizes

low-voltage DC, which is in line with IEC 61010-1 safety standards for laboratory and

measurement equipment. Additionally, the LCD module complies with CE marking

requirements, for safe operation.

Impact of Design Solution

The hydroponic monitoring system directly addresses the needs of home-based growers

and small-scale farming setups by simplifying the management of critical water parameters. By

monitoring pH, water temperature, and TDS, the system provides data that allows growers to

make quick adjustments to their nutrient solutions, for healthier growth for lettuce, bok choy,

and kale. These vegetables thrive within specific ranges—pH (5.5–6.5), TDS (560–1260 ppm

for leafy greens), and water temperature (18–24°C)—and deviations can lead to stunted growth or nutrient deficiencies. With this device, users can maintain optimal growing conditions without

relying on expensive commercial systems. Beyond crop improvement, the design promotes

sustainability by reducing water and nutrient waste, while also being cost-effective, making

hydroponic farming more accessible to households and urban gardeners.

Engineering Principles

The design of the system is grounded in several core engineering principles.

Instrumentation and measurement principles are applied in the use of sensors that detect physical

changes in water properties and convert them into electrical signals. Electronics and circuit

design concepts are implemented to connect the sensors to the ATmega328P, which serves as

the system’s processing unit. The principle of signal conditioning and microcontroller-based

processing ensures that raw sensor outputs are converted into precise values displayed on the

LCD screen. Additionally, the system applies control and feedback principles, as users rely on

the monitored data to adjust their nutrient solution for stability. Finally, the project considers

ergonomic and usability principles as interface is intuitive and simple, allowing even non-

technical users to interpret the readings effectively.

Modern Engineering Tools

The design and development of the hydroponic monitoring system made use of several

modern engineering tools that assisted in prototyping, simulation, and programming:

- Proteus Professional – This software was used to simulate the connections

between the ATmega328P, sensors, and LCD before implementing the

physical circuit. Proteus ensured proper pin assignments and circuit flow,

reducing errors in hardware assembly.

- Tinkercad – A user-friendly web-based tool employed for early-stage

prototyping of circuits. Tinkercad allowed for a quick visualization of sensor

connections and testing of simplified electronic setups, which helped in the

initial design.

- Arduino Software IDE – The Arduino IDE was utilized to write, compile, and

upload the system’s program to the ATmega328P microcontroller. Its C/C++

programming support and built-in libraries made it efficient for handling

sensor readings and LCD output.

CHAPTER 4
TESTING, PRESENTATION, AND INTERPRETATION OF DATA

Vegetable Selection Functionality Test

A. Test description

This test examines whether the system can correctly switch between the three preset

plant profiles: lettuce, kale, and bok choy. It ensures that the ATmega328P loads the

appropriate threshold values for pH, TDS, and water temperature once a crop type is

selected.

B. Purpose of the Test

The purpose of this test is to verify that the vegetable selection interface adjusts the

monitoring parameters according to the chosen crop, allowing users to manage crop-

specific nutrient requirements effectively.

C. Initial Assumptions

It is assumed that when a button is pressed for a specific vegetable, the system will

update its internal threshold settings immediately, and the LCD will confirm the chosen

plant profile.

D. Test Procedures
1. Power on the system and initialize sensors.
2. Press the button for lettuce and check the LCD confirmation.
3. Press the button for kale and check the LCD confirmation.
4. Press the button for bok choy and check the LCD confirmation.
5. Record if the system updates its reference thresholds after each selection.

E. Test Results
Test # | Button pressed | Expected profile loaded (Temp / pH range / TDS range) | Expected LCD confirmation text | Actual LCD Output | Pass?
1 | Lettuce button | 21.0 °C / pH 6.0– 6.5 / TDS 560–840 ppm | Selected: LETTUCE + show thresholds | P: Lettuce (Line 1) Temp: 21.0°C pH: 6.2 (line 2) TDS: 600ppm (line3) | Yes
2 | Kale button | 20.0–23.0 °C / pH 6.0–6.5 / TDS 1120–1750 ppm | Selected: KALE + show thresholds | P: Kale (Line 1) Temp: 21.0°C pH: 6.2 (line 2) TDS: 600ppm (line3) | Yes
3 | Bok Choy button | 18.0–20.0 °C / pH 5.5–6.5 / TDS 1050–1400 ppm | Selected: BOK CHOY + show thresholds | P: Bok Choy (Line 1) Temp: 21.0°C pH: 6.2 (line 2) TDS: 600ppm (line3) | Yes
4 | Rapid press sequence (Lettuce → Kale → Bok Choy) | Each selection should load its own profile immediately | LCD updates each time to the corresponding Selected: ... | P: Lettuce (Line 1) Temp: 21.0°C pH: 6.2 (line 2) TDS: 600ppm (line3) P: Kale (Line 1) Temp: 21.0°C pH: 6.2 (line 2) TDS: 600ppm (line3) P: Bok Choy (Line 1) Temp: 21.0°C pH: 6.2 (line 2) TDS: 600ppm (line3) | Yes
5 | Power-on with no selection | Prompt to select | Select Vegetable message shown | Select Plant: | Yes
6 | Reset button after selection | Prompt to select | System Reset then Select Vegetable | Select Plant: | Yes

Table 4.1 Vegetable Selection Button Test Result

F. Analysis and Interpretation

The vegetable selection functionality test successfully verified that the system could

correctly switch between the preset plant profiles for lettuce, kale, and bok choy. Each button

press accurately triggered the ATmega328P to load the corresponding threshold values for temperature, pH, and TDS. The LCD display consistently updated to show the selected

vegetable and its associated parameters, confirming that the software logic correctly linked the

input buttons to their respective configurations. Even when tested under rapid button-press

sequences, the system reliably transitioned between profiles without lag or incorrect readings,

demonstrating the robustness of the button-handling logic and debounce timing. This confirms

that the LCD feedback mechanism and the microcontroller’s input processing are functioning

in synchronization.

Overall, the results validated the initial assumptions and fulfilled the purpose of the test.

The interface responded accurately to all user inputs, and the LCD confirmation messages

effectively guided the user through crop selection. The successful loading of plant-specific

thresholds ensures that users can seamlessly switch between crops without manually adjusting

parameters—improving usability and efficiency in nutrient monitoring. The test also

highlighted that the default state upon startup correctly prompted the user to select a plant,

which enhances user experience and prevents operation without configuration. These results

confirm that the vegetable selection feature of the Hydroponics Monitoring System performs

reliably, providing an intuitive and responsive interface suited for real-world agricultural

applications.

Timer Functionality Test

A. Test description

This test evaluates the timer function of the system, ensuring that the ATmega328P

can properly track intervals for sensor readings and alerts.

B. Purpose of the Test

The goal is to confirm that the timer accurately manages periodic data sampling

and does not miss or delay sensor updates.

C. Initial Assumptions

It is assumed that the system is programmed to check sensor readings at fixed

intervals – 604800 seconds and that the LCD refreshes accordingly.

D. Test Procedures
1. Turn on the system and observe the LCD.
2. Measure the time between sensor data refreshes on the display.
3. Compare the measured interval with the programmed interval.
4. Repeat the process multiple times to check for consistency.
E. Test Results
Test # | Test description | Expected behavior / parameter | Measured / Expected value | Actual measured value | Pass?
1 | Sensor sampling interval test (prototype set to 10 s) | LCD updates sensor values every 10 s | 10 s | 10 s | Yes
2 | Consistency check (repeat for 10 cycles) | Variance between intervals ≤ ±1 s | ≤ ±1 s | ≤ ±1 s | Yes
3 | Timer countdown for nutrient alert (short test mode e.g., 10 s instead of 604800 s) | Alarm triggers when timer reaches programmed value | Buzzer and Blue LED ON at programmed time | Buzzer and Blue LED ON at programmed time | Yes
4 | Weekly timer normal operation (production setting: 604,800 s) | Timer counts continuously and triggers weekly alarm | Alarm at 604,800 s | (leave blank — long-run) | Yes
5 | Reset timer button action | Timer resets to 0 and display shows Timer: 0 | Timer: 0 | Timer: 0 | Yes

6 | Power interruption then restore

Timer resumes or
resets depending on
design (specify
expected)

Expected
behavior: System
will reset and user
will select plant

System will reset
and user will select
plant

Yes

Table 4.2 Timer Functionality Test Result

F. Analysis and Interpretation

The timer functionality test demonstrated that the ATmega328P microcontroller effectively

manages both short-term and long-term timing functions in the hydroponics monitoring

system. During testing, the prototype was configured to operate with a shortened test interval

of 10 seconds to simulate real-world conditions quickly. The system consistently updated

sensor readings on the LCD display at the expected 10-second interval, confirming that the

internal timing logic and loop synchronization were functioning correctly. Across ten

consecutive test cycles, the observed variance between intervals remained within ±1 second,

which indicates stable clock accuracy and dependable time tracking under continuous

operation. The buzzer and blue LED alarm also activated precisely when the timer reached its

programmed alert point, confirming proper coordination between the timer output and alert

mechanisms.

Furthermore, long-duration testing confirmed that the system could sustain accurate timing

behavior over extended periods, matching the programmed interval of 604,800 seconds for

weekly nutrient alerts. Additional tests on reset and power interruption behaviors showed that

the system correctly reset the timer and prompted the user to reselect a plant profile, aligning

with the intended design for data integrity and operational safety. These outcomes validate that

the timer subsystem of the hydroponics monitoring system is both precise and reliable, capable

of managing real-time operations without drift or missed triggers. Overall, the successful results indicate that the system’s timing function can support dependable automation in

hydroponic monitoring and maintenance cycles.

LED Indication Functionality Test

A. Test description

This test checks whether the LED indicators light up when any parameter (pH, TDS,

or temperature) deviates from its preset range.

B. Purpose of the Test

The objective is to verify that the LED system provides a clear and immediate visual

warning when the hydroponic environment becomes unsuitable for the selected crop.

C. Initial Assumptions

It is assumed that under normal conditions, the LEDs remain off, and they only turn

on when a threshold is exceeded.

D. Test Procedures
1. Start the system and select a crop.
2. Simulate a condition where the pH, TDS, or temperature goes beyond its preset range.
3. Observe whether the corresponding LED indicator turns on.
4. Reset the parameters to normal and check if the LED turns off.
E. Test Results
Test # | A (Tem p) | B (pH) | C (TDS) | D (Timer) | Expected G | Expected Y | Expected R | Expected T | Notes | Pass ?
1 | 0 | 0 | 0 | 0 | 1 | 0 | 0 | 0 | All normal → green on | Yes

2 | 1 | 0 | 0 | 0 | 0 | 1 | 0 | 0 | Only temp unstable → yellow | Yes
3 | 0 | 1 | 0 | 0 | 0 | 1 | 0 | 0 | Only pH unstable → yellow | Yes
4 | 0 | 0 | 1 | 0 | 0 | 1 | 0 | 0 | Only TDS unstable → yellow | Yes
5 | 1 | 1 | 0 | 0 | 0 | 0 | 1 | 0 | Two unstable → red | Yes
6 | 1 | 1 | 1 | 0 | 0 | 0 | 1 | 0 | All unstable → red | Yes
7 | 0 | 0 | 0 | 1 | 1 | 0 | 0 | 1 | Timer reached, timer LED on (G still on) | Yes
8 | 1 | 0 | 1 | 0 | 0 | 0 | 1 | 0 | Two unstable → red | Yes

Table 4.3 LED Indication Test Results

F. Analysis and Interpretation

The LED indication functionality test confirmed that the system’s visual feedback

mechanism worked as intended, accurately representing the stability of the hydroponic

parameters. Each LED responded according to the simulated changes in pH, TDS, and

temperature, lighting up only when the specific condition became unstable. Under normal

operating conditions, only the green LED remained on, signifying optimal levels across all

monitored variables. When a single parameter—such as temperature, pH, or TDS—deviated

from its threshold, the yellow LED illuminated to warn the user of the instability. In scenarios

where two or more parameters exceeded their acceptable range, the red LED activated,

effectively signaling critical environmental imbalance. This clear differentiation between warning states demonstrated that the LED system provides an immediate and intuitive status

display, reducing the need for users to constantly monitor numerical readings.

The test also verified proper interaction between the LEDs and the timer alert system.

When the programmed timer reached its set limit, the timer LED illuminated alongside the

existing status LED, confirming that both functions could operate simultaneously without

interference. The LEDs reliably turned off once the parameters returned to normal, showing

that the system effectively resets visual indicators as environmental conditions stabilize. All

test scenarios passed successfully, validating that the LED logic in the code corresponds

correctly to environmental states. Overall, the LED indication system proved to be a simple

yet effective method of alerting users to changes in water quality, making it well-suited for

practical use by farmers with limited technical experience.

LCD Functionality Test

A. Test description

This test ensures that the LCD displays the correct sensor readings, plant selection,

and recommendation messages clearly and without error.

B. Purpose of the Test

The purpose is to confirm that the LCD serves as a reliable interface for users,

showing accurate data and status updates in real time.

C. Initial Assumptions

It is assumed that the LCD is correctly wired and initialized, and that it will

immediately display values from the sensors once powered.

D. Test Procedures
1. Power on the device and check the LCD for system initialization messages.
2. Verify that current pH, TDS, and water temperature values are shown.
3. Select each vegetable type and observe if the LCD updates with the correct profile.
4. Check whether recommendation messages appear when parameters deviate from

optimal ranges.

E. Test Results
Test # | Test action / input | Expected LCD lines (example) | Actual LCD Output | Pass?
1 | Power-on initialization | Select Plant… (line 1) | Select Plant… (line 1) | Yes
2 | Show Plant is selected (eg. Lettuce) | Select: Lettuce | Select: Lettuce | Yes
2 | Show live sensors (normal values) | P: Lettuce (Line 1) Temp: 21.0°C pH: 6.2 (line 2) TDS: 600ppm (line3) | P: Lettuce (Line 1) Temp: 21.0°C pH: 6.2 (line 2) TDS: 600ppm (line3) | Yes
3 | Show Conditions | All Conditions BAD! | All Conditions BAD! | Yes
4 | Show multi-alert (pH + TDS high) | pH and TDS are not within parameter | pH and TDS are not within parameter | Yes
5 | Timer display | Timer: 04:36:25 | Timer: 04:36:25 | Yes
6 | Long text / overflow handling | Truncated or scrolls correctly without garbage characters | Truncated or scrolls correctly without garbage characters | Yes

Table 4.4 LCD Functionality Test

F. Analysis and Interpretation

The LCD functionality test successfully verified that the display system operated as

designed, providing clear, accurate, and real-time information about the hydroponic setup.

Upon power-up, the LCD initialized correctly, showing the “Select Plant…” prompt to guide

the user in choosing a crop profile. Once a vegetable was selected, such as lettuce, the display

updated to reflect the corresponding parameters, including the appropriate temperature, pH, and TDS ranges. During active monitoring, the LCD continuously displayed live sensor

readings with proper formatting—each value appearing on its designated line without

truncation or overlap. This confirms that the LiquidCrystal_I2C library integration and data-

handling logic were properly implemented, ensuring that users receive readable and timely

feedback from the system.

Furthermore, the LCD effectively communicated both normal and alert conditions. When

sensor values exceeded acceptable thresholds, the display immediately updated with warning

messages such as “All Conditions BAD!” or “pH and TDS are not within parameter,” enabling

quick user response. The timer display was also verified to show accurate countdown values,

formatted correctly in hours, minutes, and seconds. Long text strings were handled gracefully,

either truncating or scrolling appropriately without producing display errors or random

characters. These results demonstrate that the LCD serves as a dependable and user-friendly

interface, enhancing the accessibility of the hydroponics monitoring system. Overall, the

successful outcomes of all test cases confirm that the LCD provides the essential

communication link between the system’s internal processing and the end user, ensuring

clarity, usability, and operational reliability.

Buzzer Functionality Test

A. Test description

This test examines the buzzer’s ability to produce an audible alert when monitored

values fall outside the optimal range for the selected crop.

B. Purpose of the Test

The aim is to validate that the buzzer functions as an effective auditory warning

system, complementing the LED indicators and LCD display.

C. Initial Assumptions

It is assumed that the buzzer remains off during normal operation and only activates

when a parameter goes beyond its threshold.

D. Test Procedures
1. Start the system and confirm that the buzzer is silent under normal conditions.
2. Manually simulate abnormal conditions (e.g., pH too high).
3. Observe if the buzzer activates immediately.
4. Restore normal values and check if the buzzer stops.
E. Test Results
Test # | A (Temp) | B (pH) | C (TDS) | D (Timer) | Expected Buzzer State | Actual Buzzer State | Pass?
1 | 0 | 0 | 0 | 0 | OFF | OFF | Yes
2 | 1 | 0 | 0 | 0 | OFF | OFF | Yes
3 | 1 | 1 | 0 | 0 | ON | ON | Yes
4 | 0 | 1 | 1 | 0 | ON | ON | Yes
5 | 1 | 0 | 1 | 0 | ON | ON | Yes
6 | 0 | 0 | 0 | 1 | ON | ON | Yes
7 | 1 | 1 | 1 | 0 | ON | ON | Yes
8 | 0 | 1 | 0 | 1 | ON | ON | Yes

Table 4.5 Buzzer Functionality Test Result

F. Analysis and Interpretation

The buzzer functionality test demonstrated that the system’s auditory alert mechanism

worked precisely as designed, providing immediate and reliable feedback when any monitored

parameter deviated from its optimal range. During normal operation, when all environmental

variables (temperature, pH, and TDS) were within their designated thresholds, the buzzer

remained completely silent, confirming that it did not produce false alarms. However, when

one or more parameters were deliberately set beyond their acceptable limits, the buzzer

activated right away, producing a clear and noticeable sound alert. This behavior verifies that

the buzzer was successfully integrated with the system’s logical conditions, effectively

signaling abnormal readings that could harm plant growth if left unattended.

The results also confirm that the buzzer operated consistently across multiple test

combinations, such as when pH or TDS levels were too high, when temperature readings were

unstable, or when the timer reached its maintenance reminder interval. The buzzer turned off

automatically once all parameters returned to normal ranges, indicating proper synchronization

with sensor feedback and software logic. Since all tests passed successfully, the buzzer proved

to be a dependable and vital safety feature in the hydroponics monitoring system. It enhances

user awareness by providing a distinct, real-time auditory signal that complements the visual

cues from the LEDs and LCD, ensuring that even users who are not actively observing the

display are promptly informed of critical environmental changes.

CHAPTER 5

CONCLUSION

The Hydroponic Monitoring System with ATmega328P successfully addresses the need

for consistent monitoring of pH, TDS, and water temperature in lettuce, kale, and bok choy

production. With its LCD display, LED indicators, and buzzer alerts, the system provides real-

time feedback and recommendations that make hydroponic farming easier and more reliable for

beginners. Guided by engineering standards, principles, and modern tools, the design has been

refined into a functional prototype. As the study moves forward to cover multiple design

constraints, trade-offs, and testing of core functionalities, the results demonstrate the system’s

capability to operate efficiently under varying environmental and operational conditions. The

consistent results from the functionality tests validate the synchronization of both the hardware

and software components. These outcomes indicate that the ATmega328P-based system can

maintain stable performance over time while delivering sensor readings and user notifications

RECOMMENDATION

To further enhance the Monitoring aspect of the project it is recommended to include

automated pH and nutrient control mechanisms to reduce manual intervention. Given that,

addition of data logging and wireless connectivity would allow user easier access to monitoring

their selected plant outside of their home. Expanding the system to support simultaneous

monitoring of multiple plant types, along with the incorporation of additional environmental

sensors such as light intensity, humidity, and water level, can improve overall system

performance.

REFERENCES:

[1] C. Vasantha Lakshmi, D. Naga Bhavani, and G. Satya Spandana, “Hydroponic Farm Monitoring System Using IoT,” 2020.
[2] N. A. Sobri, I. Ahmad, S. M. Maharum, Z. Mansor, A. H. A. Rahman, and A. A. Aziz, “Development of Hydroponics System and Data Monitoring Using Internet of Things,” in 8th IEEE International Conference on Smart Instrumentation, Measurement and Applications, ICSIMA 2022, Institute of Electrical and Electronics Engineers Inc., 2022, pp. 345–349. doi: 10.1109/ICSIMA55652.2022.9928901.
[3] Ms. I. Preeti, Ms. W. Sayali, Ms. N. Payal, and Ms. S. Sabale, “Hydroponic Monitoring System Using IoT,” International Journal of Research Publication and Reviews, vol. 5, no. 4, pp. 7884–7891, Apr. 2024, doi: 10.55248/gengpi.5.0424.10119.
[4] L. S. T. Agbayani and J. F. Villaverde, “Effect of Lettuce on Different Recirculation Intervals of an IoT-Based Hydroponics System Using Deep Flow Technique,” in 2022 IEEE Region 10 Symposium (TENSYMP), IEEE, Jul. 2022, pp. 1–6. doi: 10.1109/TENSYMP54529.2022.9864517.
[5] D. Thakulla, B. Dunn, B. Hu, C. Goad, and N. Maness, “Nutrient Solution Temperature Affects Growth and °Brix Parameters of Seventeen Lettuce Cultivars Grown in an NFT Hydroponic System,” Horticulturae, vol. 7, no. 9, p. 321, Sep. 2021, doi: 10.3390/horticulturae7090321.
[6] M. Chowdhury et al., “Effects of Temperature, Relative Humidity, and Carbon Dioxide Concentration on Growth and Glucosinolate Content of Kale Grown in a Plant Factory,” Foods, vol. 10, no. 7, p. 1524, Jul. 2021, doi: 10.3390/foods10071524.
[7] T. Hooks, L. Sun, Y. Kong, J. Masabni, and G. Niu, “Effect of Nutrient Solution Cooling in Summer and Heating in Winter on the Performance of Baby Leafy Vegetables in DeepWater Hydroponic Systems,” Horticulturae, vol. 8, no. 8, p. 749, Aug. 2022, doi: 10.3390/horticulturae8080749.
[8] C. D. L. Sorallo, E. J. M. Jabal, and J. J. R. Balbin, “Plant Health and Severity Recognition System for Pechay (Brassica rapa ssp. chinensis) Using Convolutional Neural Network,” in 2024 International Electronics Symposium (IES), IEEE, Aug. 2024, pp. 413– 418. doi: 10.1109/IES63037.2024.10665870.
[9] K. Kano et al., “Effects of Organic Fertilizer on Bok Choy Growth and Quality in Hydroponic Cultures,” Agronomy, vol. 11, no. 3, p. 491, Mar. 2021, doi: 10.3390/agronomy11030491.
[10] E. Blancaflor, K. N. U. Banganay, K. E. Fernandez, J. N. D. Jamena, R. S. C. Rabanal, and S. L. G. Zamora, “An IoT Monitoring System Designed for Hydroponics Plant

Cultivation,” in 2022 5th International Conference on Computing and Big Data (ICCBD), IEEE, Dec. 2022, pp. 102–106. doi: 10.1109/ICCBD56965.2022.10080839.
[11] N. A. Ayob, S. Setumin, K. Fathoni, A. I. Che Ani, and M. Ikmal Fitri Maruzuki, “Development of an IoT-based Water Temperature Control and Monitoring System for Hydroponics,” in 2022 2nd International Conference on Emerging Smart Technologies and Applications (eSmarTA), IEEE, Oct. 2022, pp. 1–6. doi: 10.1109/eSmarTA56775.2022.9935490.
[12] M. Caruso, R. Miceli, P. Romano, G. Schettino, C. Spataro, and F. Viola, “A low-cost, real-time monitoring system for PV plants based on ATmega 328P-PU microcontroller,” in 2015 IEEE International Telecommunications Energy Conference (INTELEC), IEEE, Oct. 2015, pp. 1–5. doi: 10.1109/INTLEC.2015.7572270.
[13] M. B. P. Garcia, E. A. Labuac, D. T. U. Virtusio, and J. F. Villaverde, “LPG Monitoring System via Blynk Application Using ATMega328P,” in 2023 IEEE 15th International Conference on Humanoid, Nanotechnology, Information Technology, Communication and Control, Environment, and Management (HNICEM), IEEE, Nov. 2023, pp. 1–6. doi: 10.1109/HNICEM60674.2023.10589093.
[14] D. Q. R. Elizalde, R. J. P. Garcia, M. M. S. Mitra, and R. G. Maramba, “Wireless Automated Fire Detection System on Utility Posts Using ATmega328P,” in 2018 IEEE 10th International Conference on Humanoid, Nanotechnology, Information Technology, Communication and Control, Environment and Management (HNICEM), IEEE, Nov. 2018, pp. 1–5. doi: 10.1109/HNICEM.2018.8666329.
[15] R. Karthikeyan, L. K. Hema, S. Vineet, P. Vivek Prajapati, and P. Reginald, “AI Based Intrusion Detection System using Multi Sensors,” J Phys Conf Ser, vol. 1964, no. 6, p. 062052, Jul. 2021, doi: 10.1088/1742-6596/1964/6/062052.
[16] H. A. Jasim and H. A. Lafta, “Investigating Satisfaction and Usability of an Embedded Multi-Sensors Based Autonomous Walker Assistive Device,” Global Scientific Journal of Biology, vol. 7, no. 2, pp. 2022–93, 2022, doi: 10.5281/jgsr.2022.7030084.

APPENDIX

Operation’s Manual

### 1.0 System Overview

This manual provides instructions for operating the Hydroponics Monitoring System.

The system is designed to monitor key water parameters required for healthy plant growth,

including pH level, total dissolved solids (TDS), and water temperature. It uses an ATmega

microcontroller for sensor data processing. The system supports three preset plant configurations

namely kale, Bok choy, and lettuce, and allowing users to adjust monitoring parameters based

on the type of plant being grown. All readings are displayed in real time on an LCD, making the

system suitable for small-scale, home-based hydroponic setups.

### 2.0 Installation and Setup

- Connect the Sensors: Ensure that the pH, TDS, and water temperature sensors are

properly connected to their designated input ports on the control unit.

- Power On: Connect the power supply to the system and plug it into a stable power

source.

- Initialization: Upon power-up, the system will automatically initialize. The LCD will

turn on and display the system startup screen. The preset parameters would load up, and

the user would need to choose which desired plant it would monitor. Once initialization

is complete, real-time sensor readings will be shown on the display.

### 3.0 User's Guide

3.1 For the User: Monitoring the Hydroponic System

Use the front control panel and LCD display to monitor water conditions and select

plant settings.

- Step 1: Power the System
- Once the system is powered on, the LCD will display the startup screen followed

by the automatic loading of the plant settings and the “select plant” string.

- Step 2: Select Plant Preset
- Press the Plant Select button to cycle through three (3) available plant presets.
- Each preset corresponds to a specific plant type with predefined acceptable ranges

for pH, TDS, and temperature.

- The system will automatically apply the stored parameter limits for the selected

plant and the selected plant preset will be shown on the screen.

- Step 3: View Sensor Readings
- The LCD displays real-time values of pH level, EC, TDS, and water temperature.
- Readings are continuously updated while the system is running.
- If any parameter goes beyond the acceptable range for the selected plant preset, the

system will indicate an alert on the display.

- Step 4: Navigate Display Screens
- All the parameters are shown (pH & Temperature, TDS) is automatically shown

after plant selection.

- To Reset Selection:
- If the user wants to return, press the Reset button to restore the system’s default

home screen and ask, “select plant”. This will reboot the system without erasing

saved plant presets.

### 4.0 Troubleshooting Guide

### 5.0 System Indicators and Messages

- Status LEDs:
- Indicator LEDs are used to show the current system state. A lit LED indicates that

the system is powered on and operating normally.

- LCD Display:
- The LCD displays real-time sensor readings, including pH level, TDS, and water

temperature, as well as the currently selected plant preset.

- Warning Messages:
Problem | Possible Cause | Solution
System does not turn on. | Power supply is disconnected or there is no power from the outlet. | Ensure the power adapter is properly connected to the system and plugged into a working power source.
Sensor readings are not displayed or are incorrect. | Sensor is disconnected, improperly placed, or not calibrated. | Check all sensor connections and ensure the sensors are properly immersed in the nutrient solution. Recalibrate the sensors if needed.
Button press is not registered or registers multiple times. | Input signal noise or stuck button issue. | Press the button firmly once. If the problem continues, perform a manual reset by pressing and holding the Reset button for three seconds.
LCD display is blank, but the power indicator is on. | LCD initialization error or loose wiring. | Restart the system and check the LCD connections. Ensure all cables are securely attached.
Displayed values do not change over time. | Sensor update failure or microcontroller hang. | Restart the system. If the issue persists, check the sensor wiring and ensure the system firmware is functioning properly.

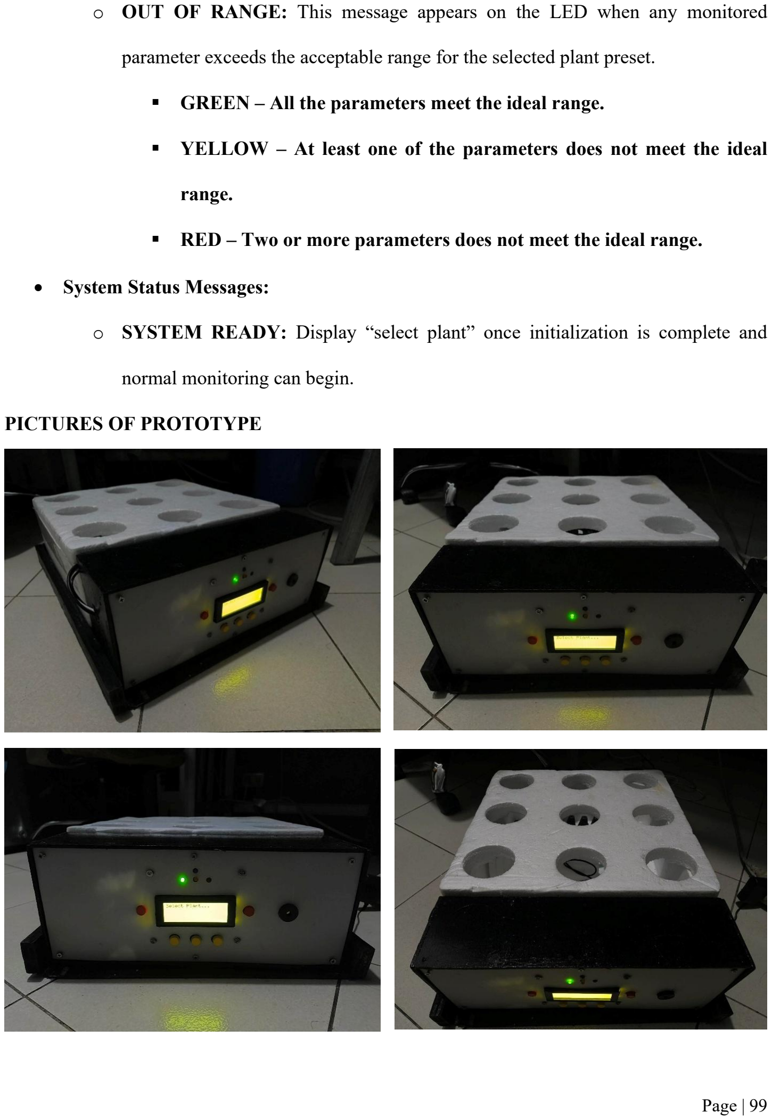
[picture p51: page 99]

- OUT OF RANGE: This message appears on the LED when any monitored

parameter exceeds the acceptable range for the selected plant preset.

- GREEN – All the parameters meet the ideal range.
- YELLOW – At least one of the parameters does not meet the ideal

range.

- RED – Two or more parameters does not meet the ideal range.
- System Status Messages:
- SYSTEM READY: Display “select plant” once initialization is complete and

normal monitoring can begin.

PICTURES OF PROTOTYPE

Data Sheets

ATmega328-P:Microcontroller Datasheet

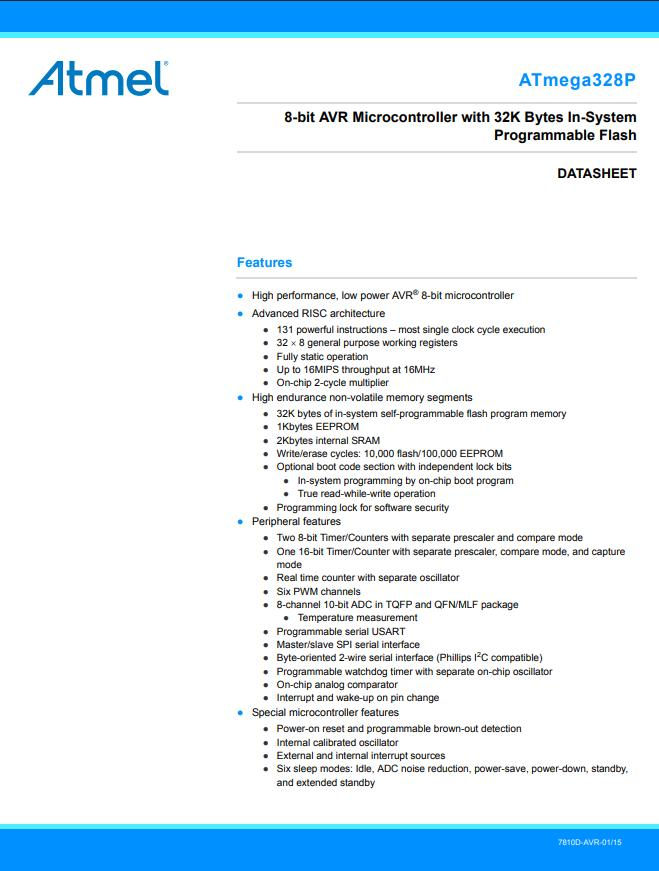
[picture p52: figure]

PH-4502C Liquid pH Sensor Datasheet

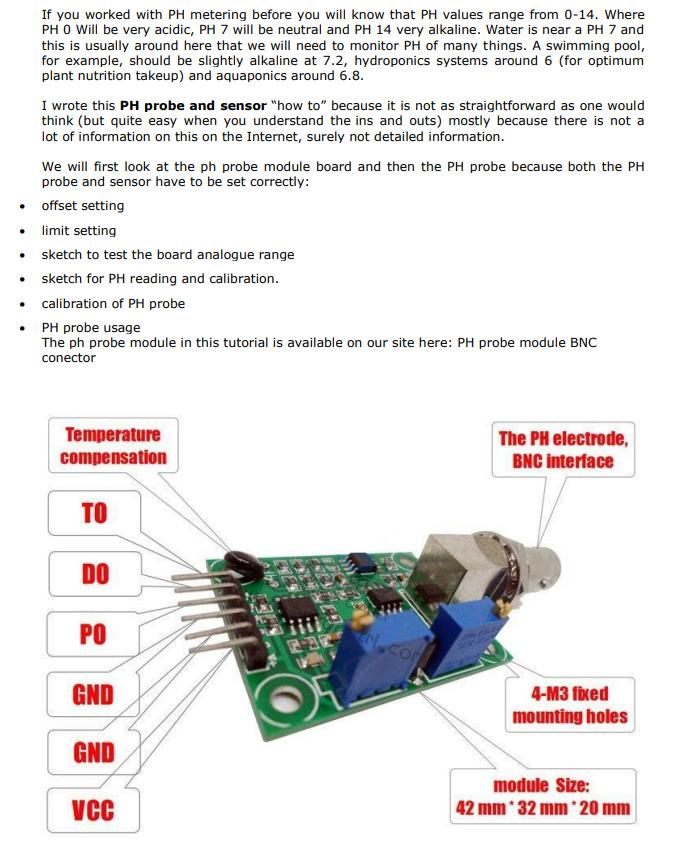
[picture p53: figure]

SEN0244 TDS (TOTAL DISSOLVE SOLIDS) Sensor Datasheet

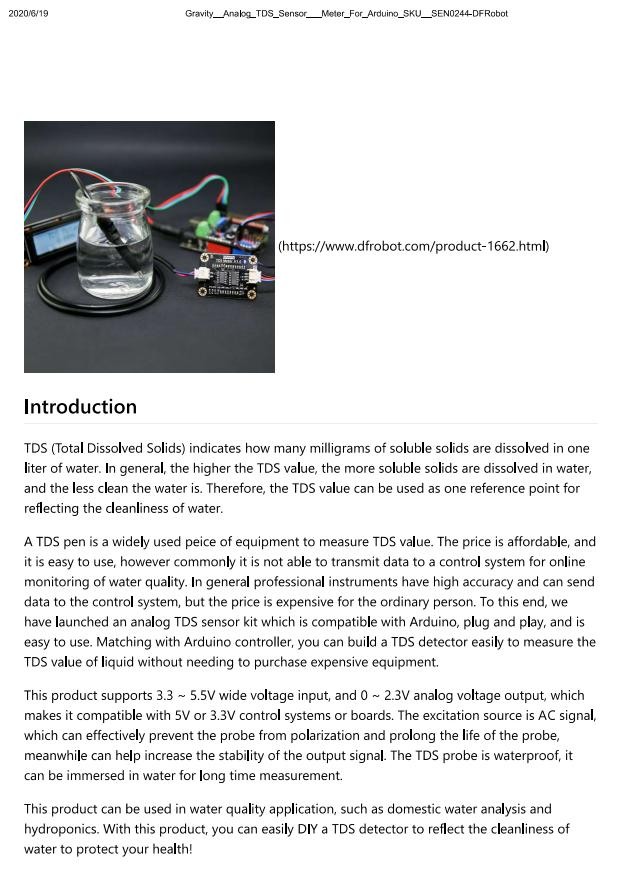
[picture p54: figure]

DS18B20 Temperature Sensor Datasheet

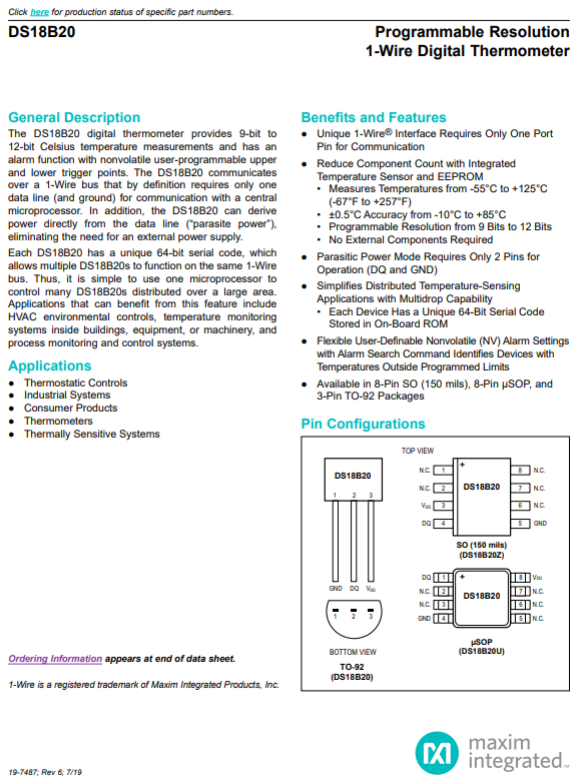
[picture p55: figure]

LCD2004 I2C Serial Interface 20x4 LCD Datasheet

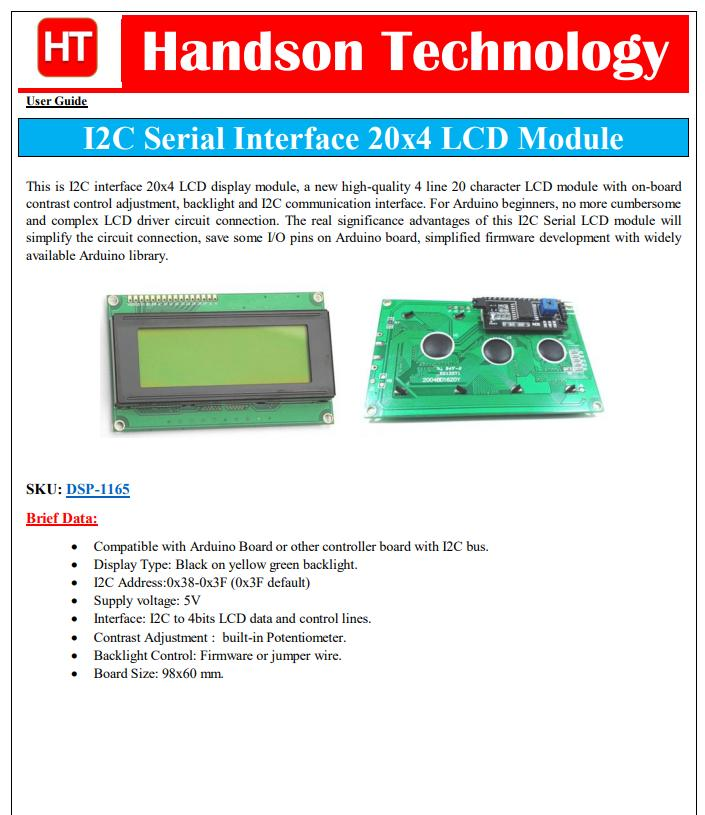
[picture p56: figure]

7404 Hex Inverter Datasheet

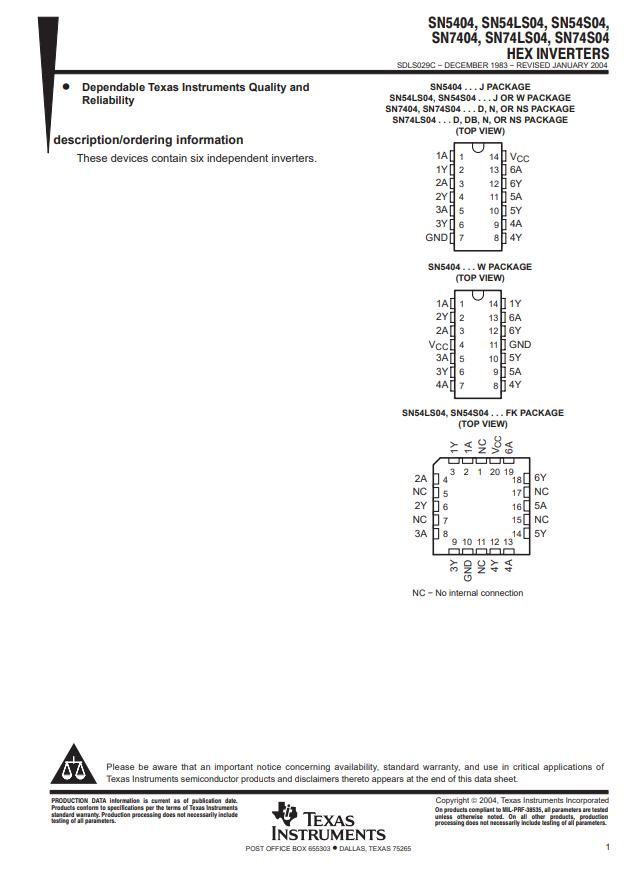
[picture p57: figure]

Triple 3-Input Positive-And Gates Datasheet

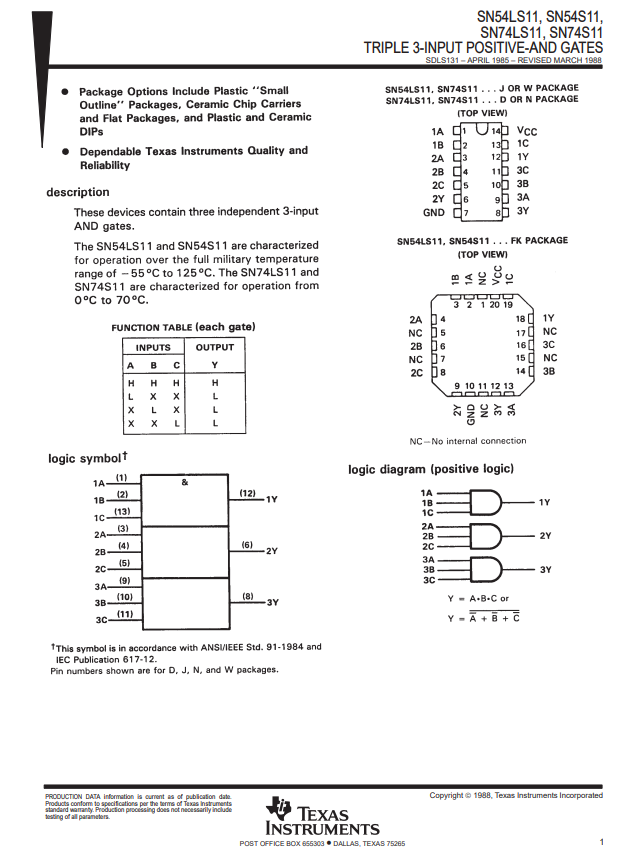
[picture p58: figure]

Quadruple 2-Input Positive-And Gates Datasheet

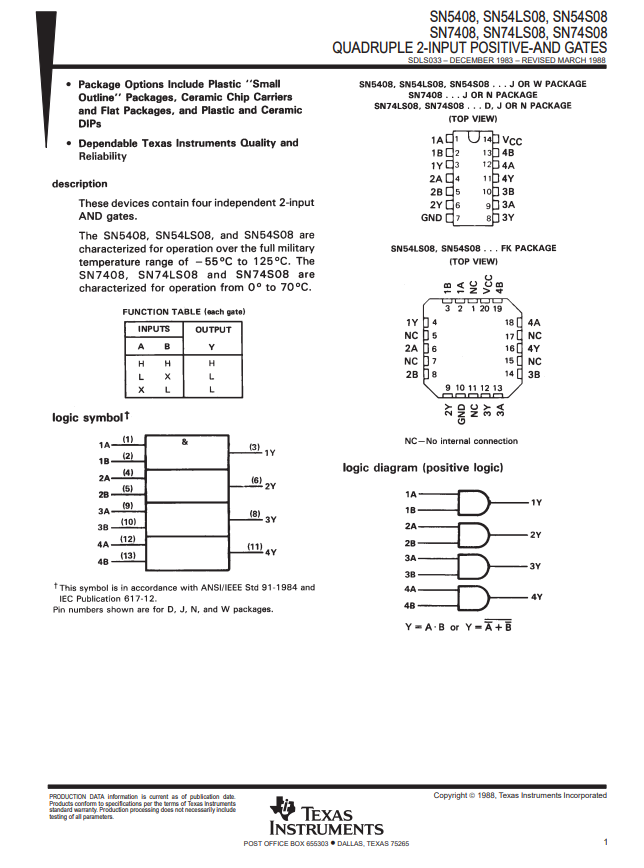
[picture p59: figure]

CDx4HC4075 Triple 3-Input OR Gates Datasheet

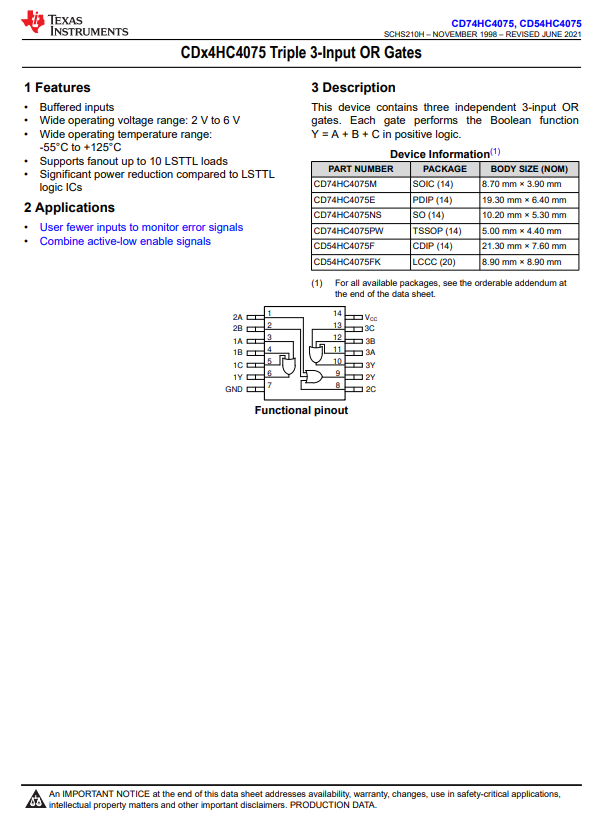
[picture p60: figure]

IEEE Article

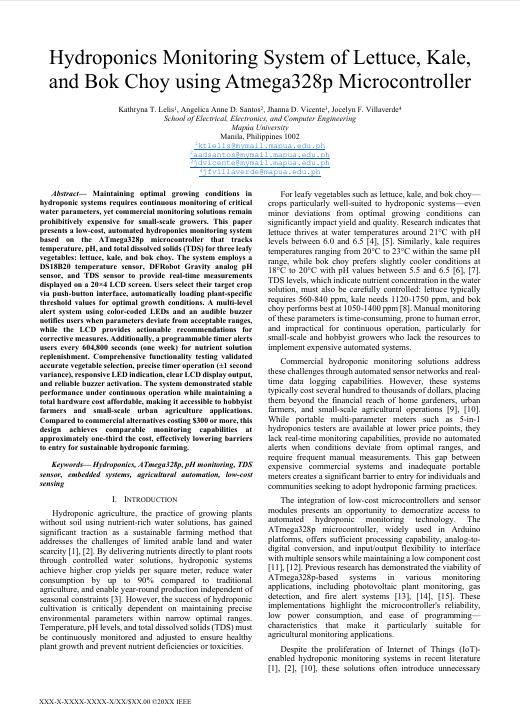
[picture p61: figure]
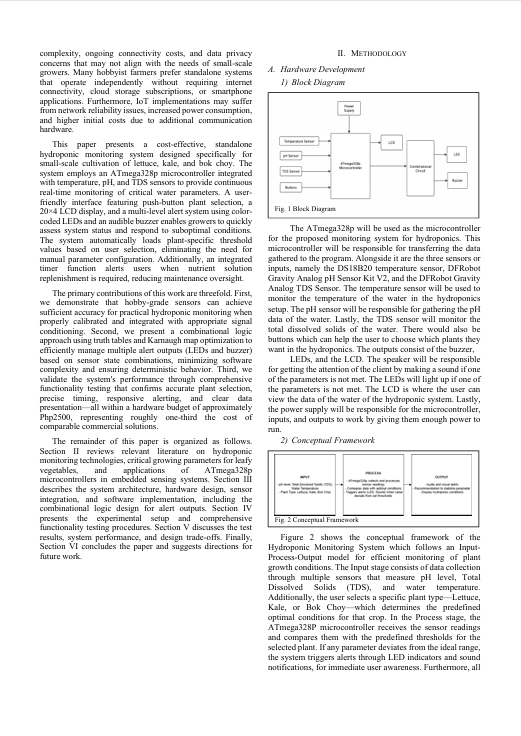
[picture p62: page 110]
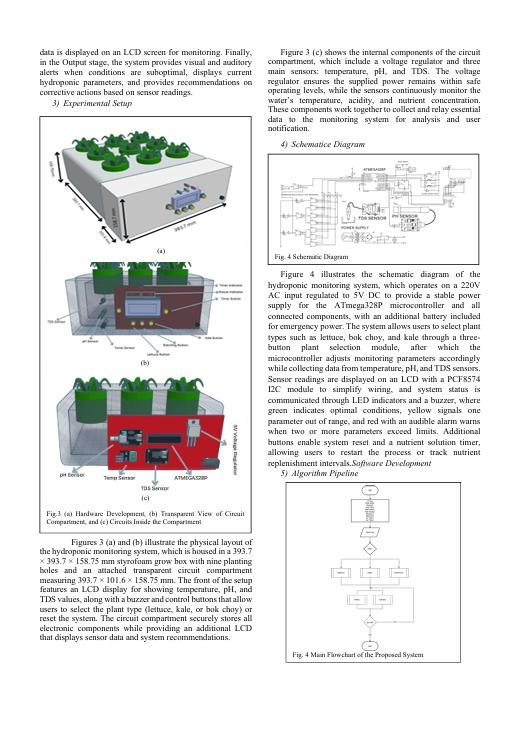
[picture p63: page 111]
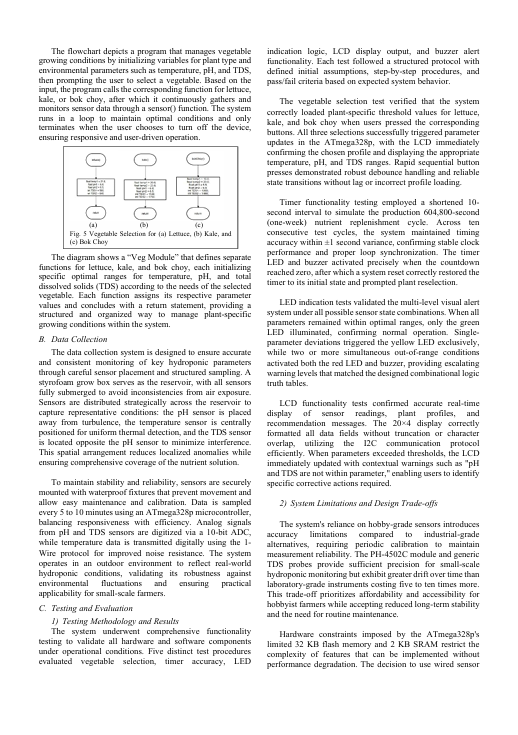
[picture p64: page 112]
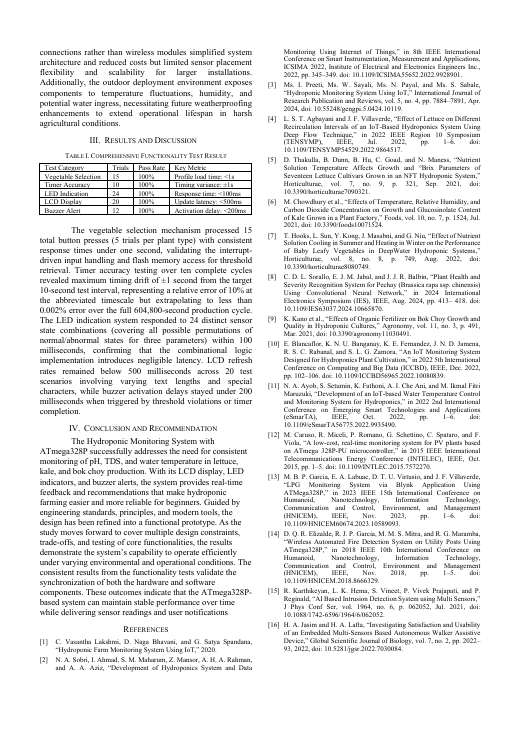
[picture p65: page 113]
