Kathrynlls/Hydroponics-Monitoring-System-using-Atmega328p/ATEMGA328P.bmp

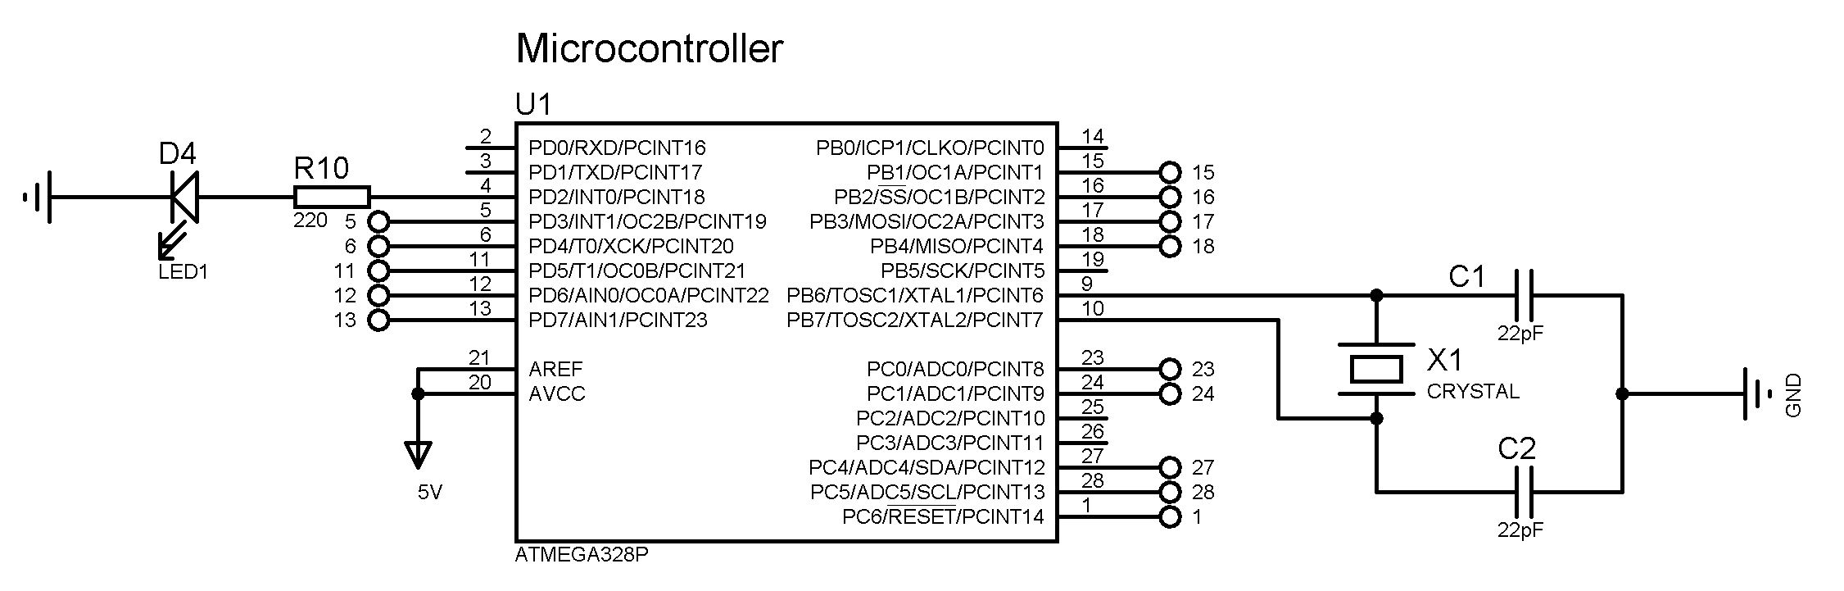
ATEMGA328P.bmp
