Kathrynlls/Hydroponics-Monitoring-System-using-Atmega328p/Buttons.bmp

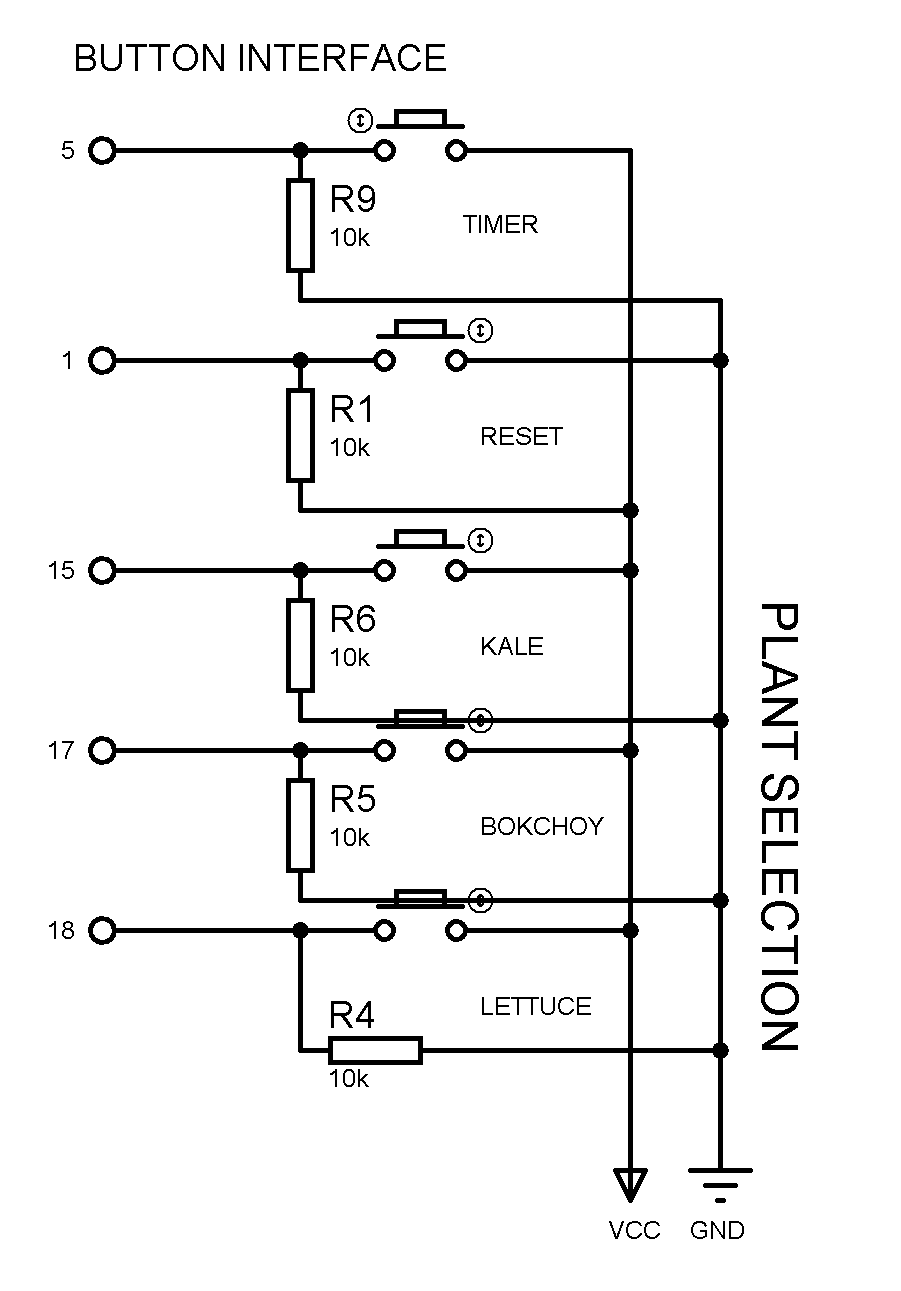
Buttons.bmp
