Kathrynlls/Hydroponics-Monitoring-System-using-Atmega328p/Combinational.bmp

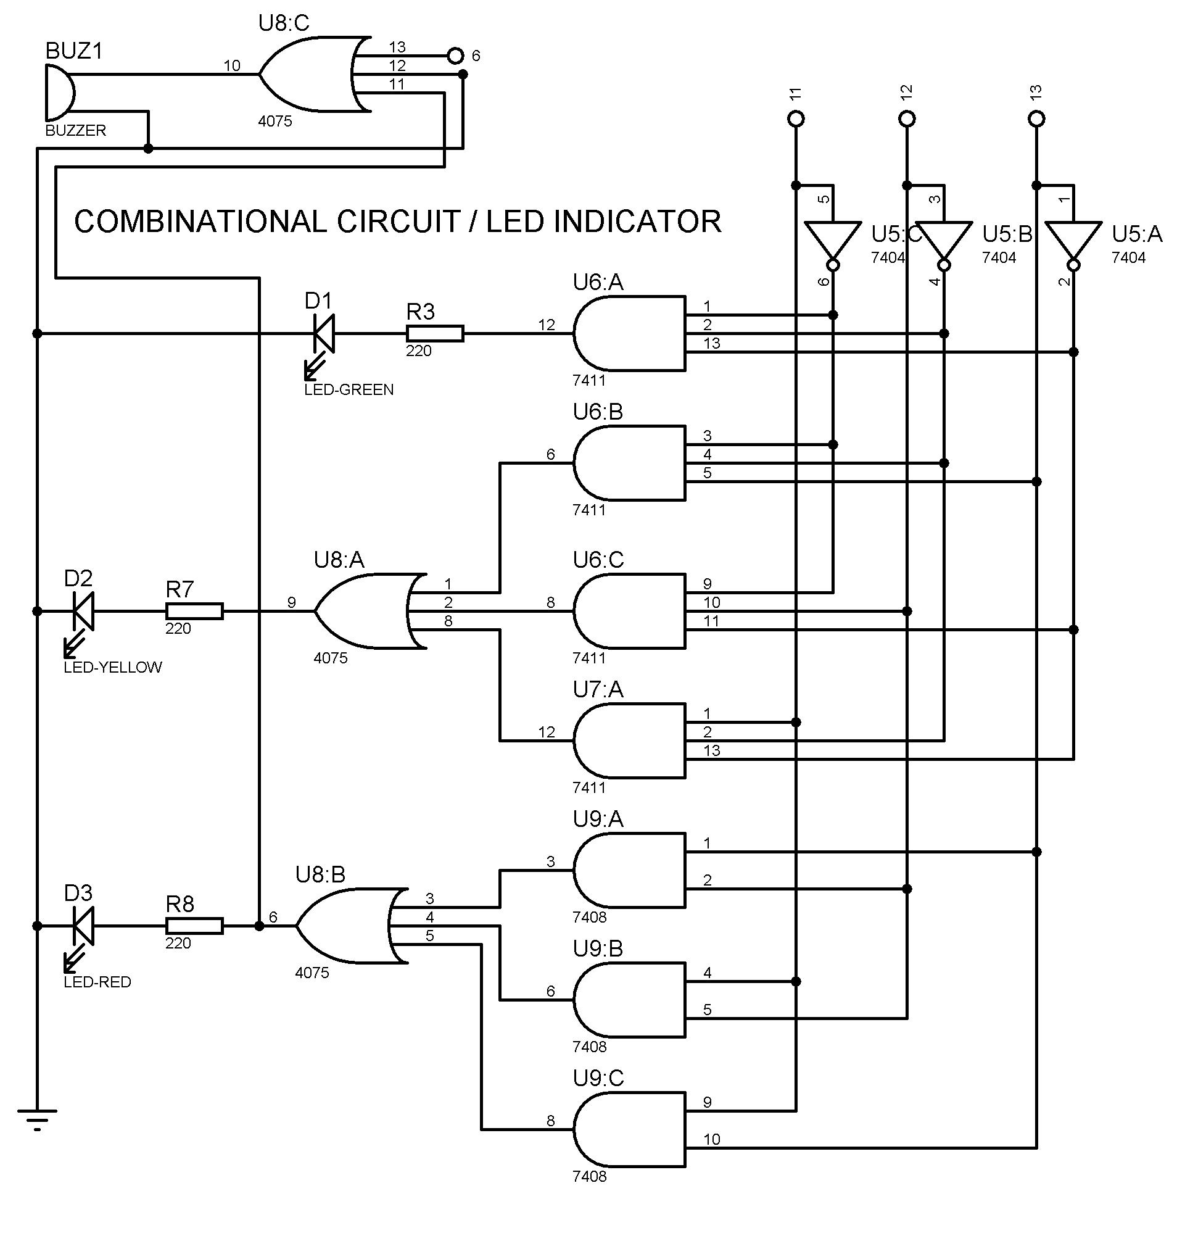
Combinational.bmp
