Kathrynlls/Hydroponics-Monitoring-System-using-Atmega328p/Final Schematic.bmp

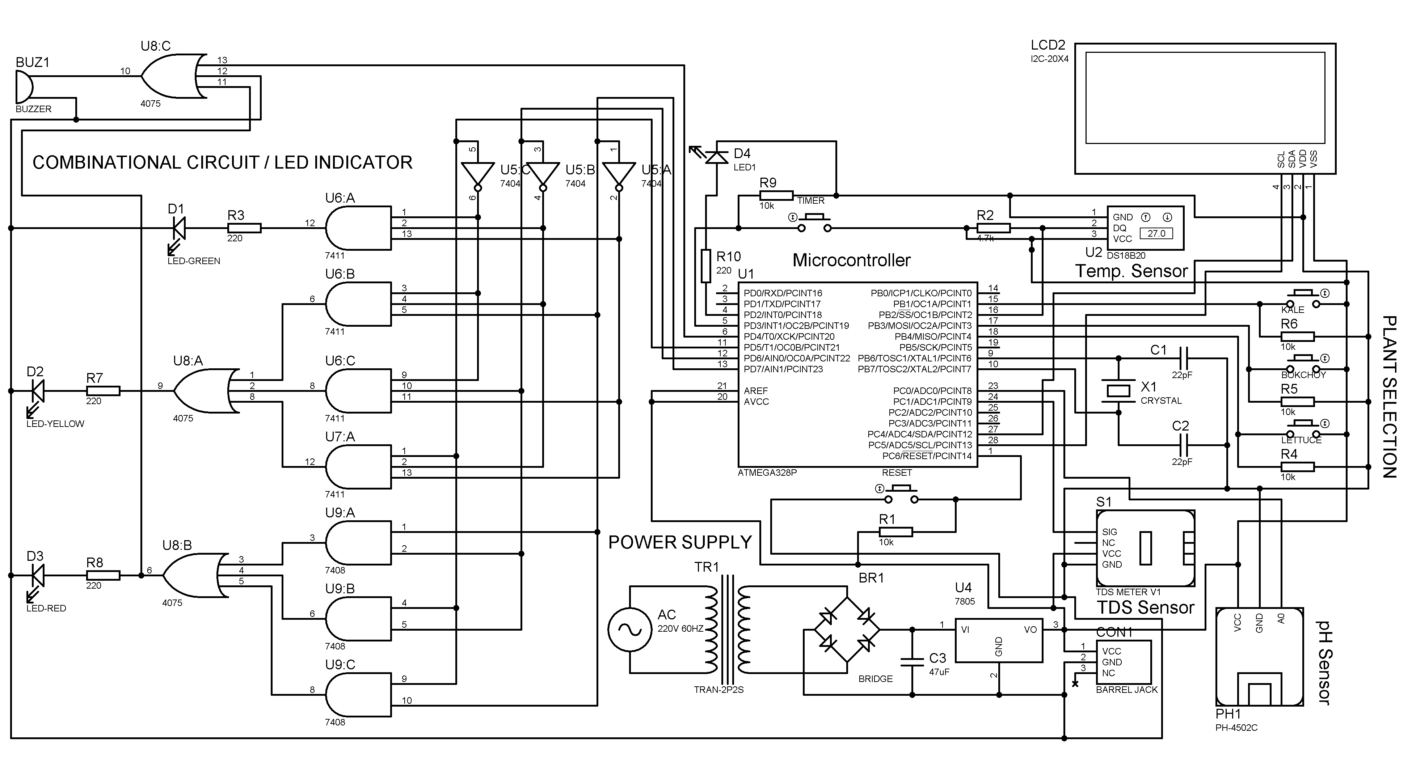
Final Schematic.bmp
