Kathrynlls/Hydroponics-Monitoring-System-using-Atmega328p/LCD DISPLAY.bmp

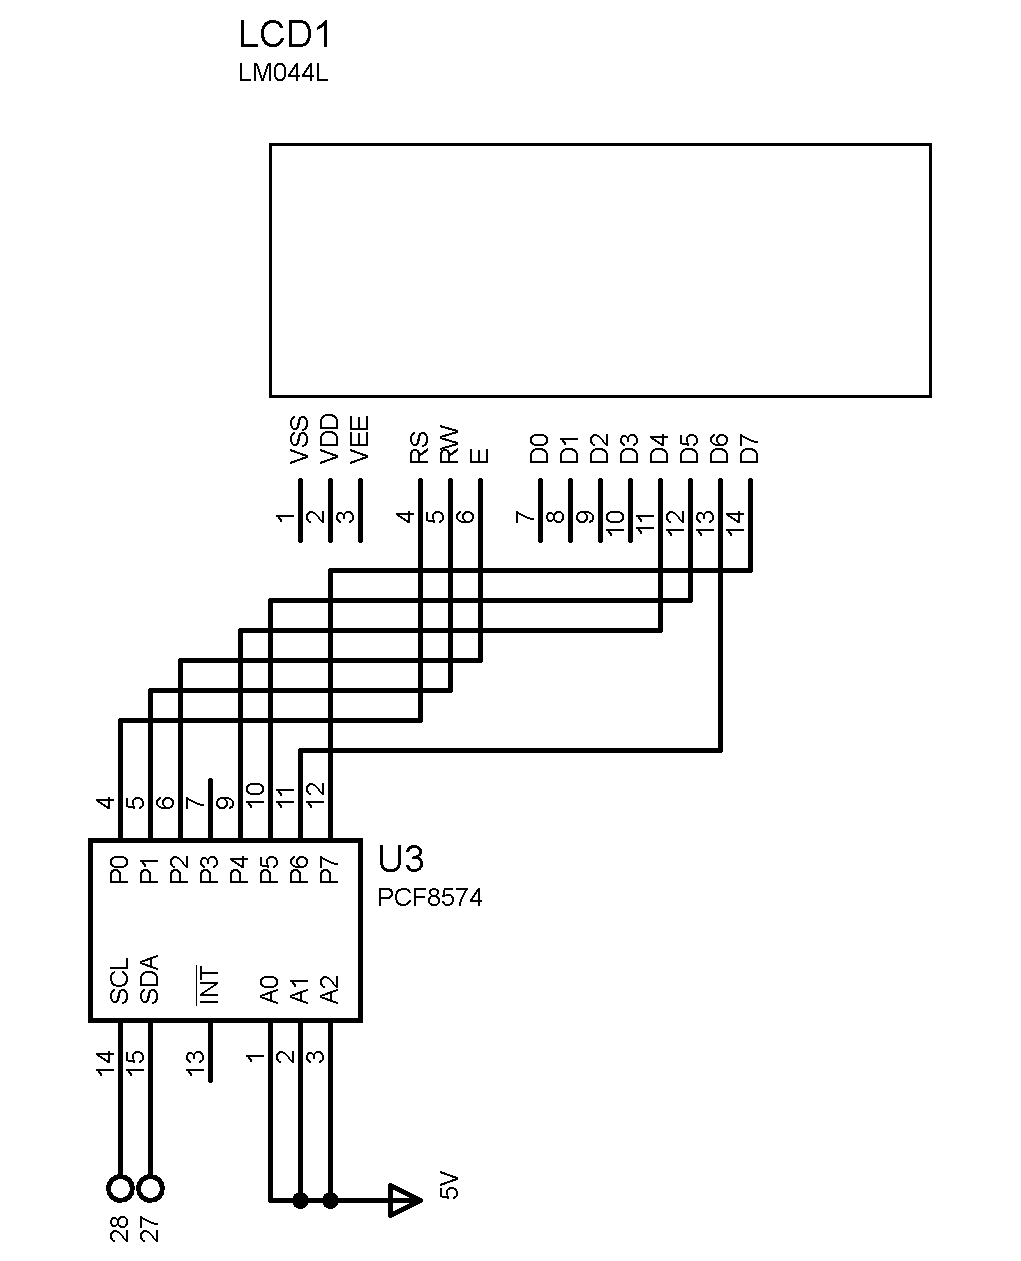
LCD DISPLAY.bmp
