Kathrynlls/Hydroponics-Monitoring-System-using-Atmega328p/Power Supply.bmp

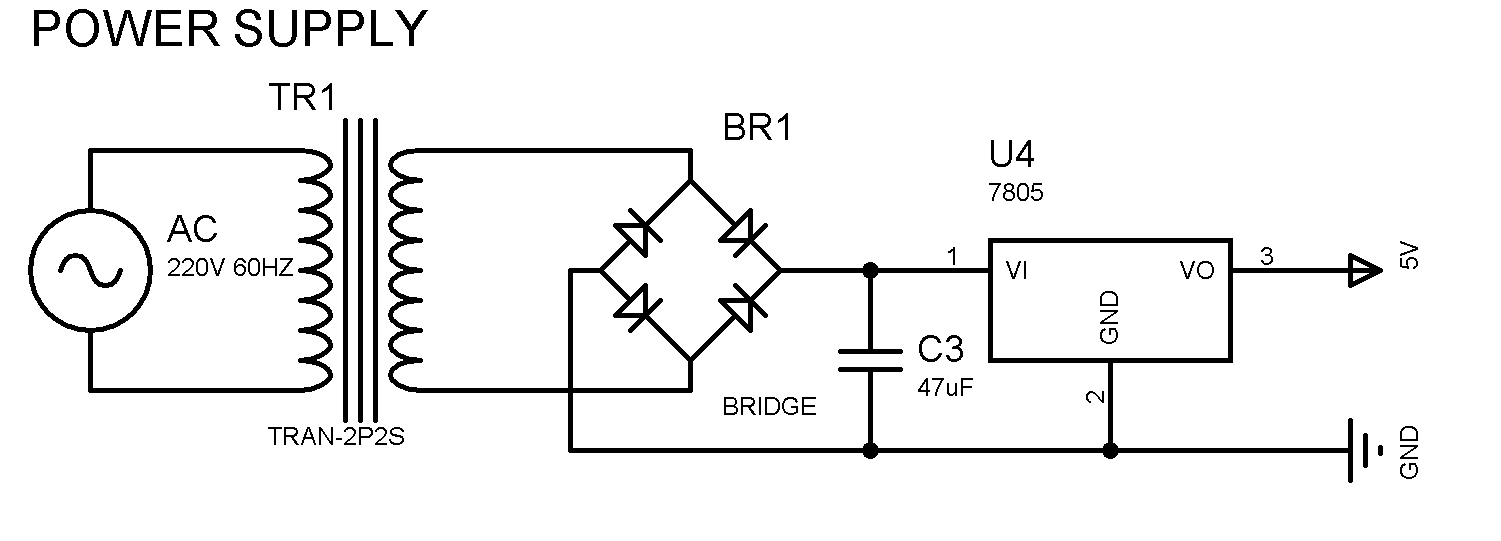
Power Supply.bmp
