Kathrynlls/Hydroponics-Monitoring-System-using-Atmega328p/Sensors.bmp

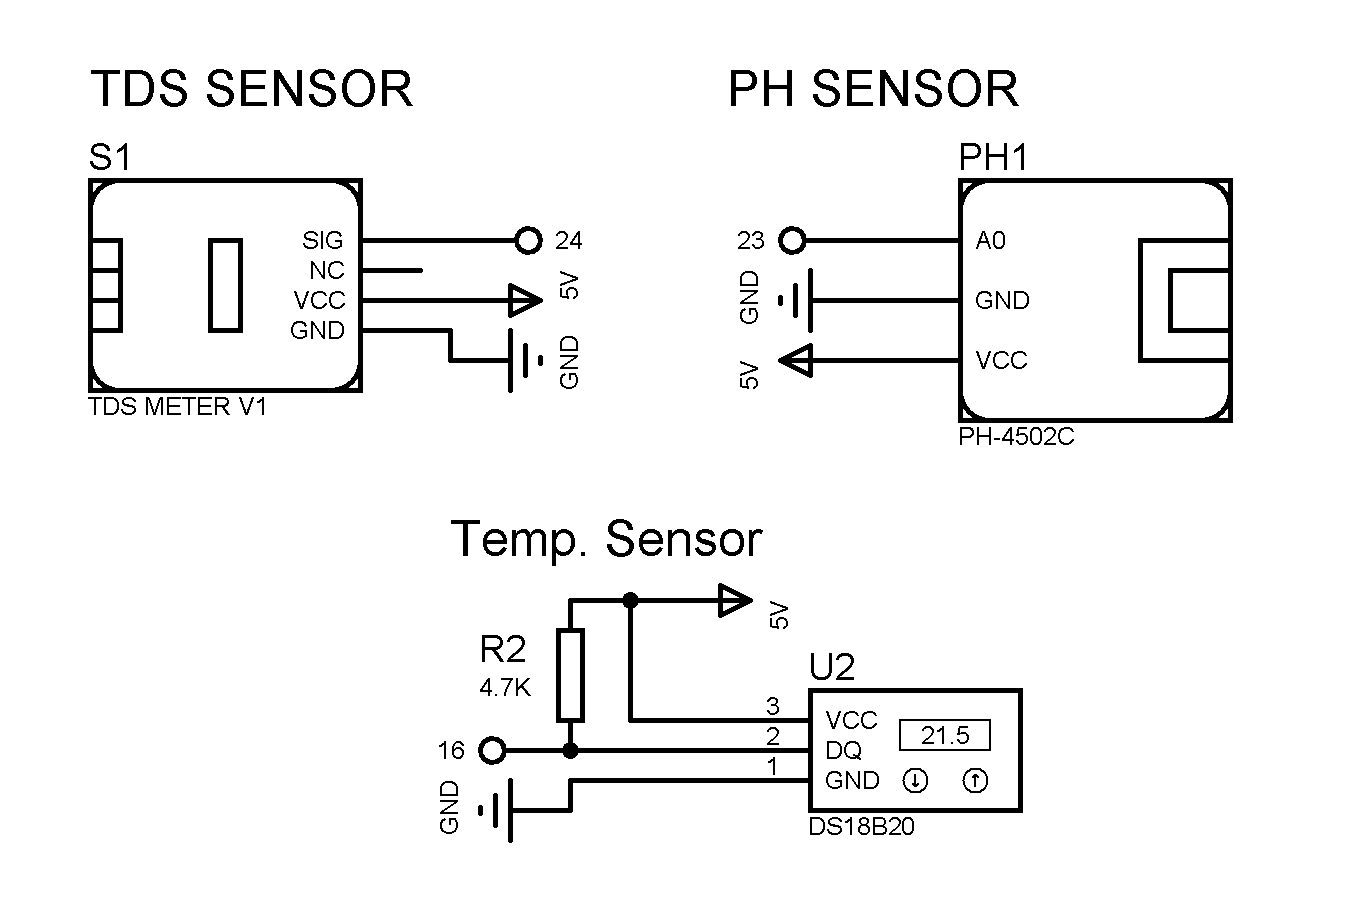
Sensors.bmp
