Kathrynlls/Hydroponics-Monitoring-System-using-Atmega328p/(list of files, drawings)

Other design files:
Design Initial Schematic.pdsprj
